shawnchivers/genthang/README.md

```
 ██████╗ ███████╗███╗   ██╗████████╗██╗  ██╗ █████╗ ███╗   ██╗ ██████╗ 
██╔════╝ ██╔════╝████╗  ██║╚══██╔══╝██║  ██║██╔══██╗████╗  ██║██╔════╝ 
██║  ███╗█████╗  ██╔██╗ ██║   ██║   ███████║███████║██╔██╗ ██║██║  ███╗
██║   ██║██╔══╝  ██║╚██╗██║   ██║   ██╔══██║██╔══██║██║╚██╗██║██║   ██║
╚██████╔╝███████╗██║ ╚████║   ██║   ██║  ██║██║  ██║██║ ╚████║╚██████╔╝
 ╚═════╝ ╚══════╝╚═╝  ╚═══╝   ╚═╝   ╚═╝  ╚═╝╚═╝  ╚═╝╚═╝  ╚═══╝ ╚═════╝ 
▀▀▀▀▀▀▀▀▀▀▀▀▀▀▀▀▀▀▀▀▀▀▀▀▀▀▀▀▀▀▀▀▀▀▀▀▀▀▀▀▀▀▀▀▀▀▀▀▀▀▀▀▀▀▀▀▀▀▀▀▀▀▀▀▀▀▀▀▀▀▀▀▀
      M E G A   D R I V E  /  G E N E S I S   ·   T A N G   N A N O   2 0 K
```

# Gen Thang

**Gen Thang is a DIY Sega Genesis / Mega Drive console project for the
[Sipeed Tang Nano 20K](https://wiki.sipeed.com/hardware/en/tang/Tang-Nano-20K/Nano-20K.html).**
A typical emulator recreates a console in software. Gen Thang does it in
hardware instead, using an FPGA chip configured to work like the original console.

Copy your own game ROMs to a microSD card (also called a TF card), choose a game
from the on-screen menu, and play. The standard build sends video and audio over
720p HDMI. You need a computer to program the board initially, but not to play.
Games are not included.

You can build it as a **TV console with Genesis controllers** or a **handheld
with built-in buttons and a small screen**. This repository contains the FPGA
design, menu firmware, build tools and optional PCB and printable-case designs.
You can use a [prebuilt release image](#choose-a-release-image) without compiling
the source yourself.

<p align="center">
  <a href="hardware/modern-3btn-handheld/index.html">
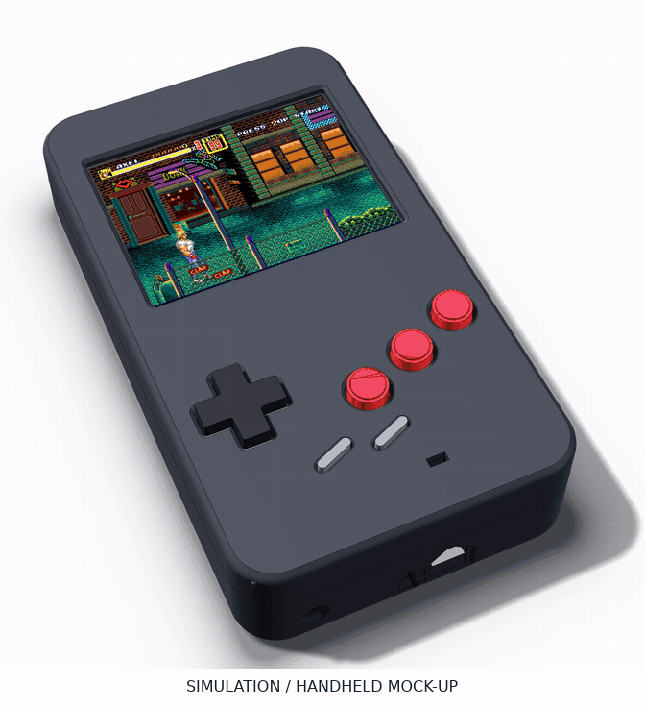
[picture p1: docs/images/modern-3btn-demo.gif]
Light-background mock-up of Streets of Rage 2 on the Gen Thang Modern three-button handheld
    
  </a>
</p>
<p align="center"><sub>Three-button handheld mock-up: Streets of Rage 2 frames from
Gen Thang's Verilator simulation composited onto a 3D render.
This is not footage from a physical handheld.
<a href="hardware/modern-3btn-handheld/index.html">Explore the handheld build guide.</a></sub></p>

> **Alpha software.** Gen Thang is under active development and is published as an
> early alpha. Expect bugs, game-compatibility gaps, missing features and breaking
> changes between releases. The default dual-DB9 build and raw-button variant are
> built and timing-checked but have not yet been tested on the new canonical wiring. The
> legacy single-DB9 breadboard image was tested by the author with a wired Genesis
> pad on its now-deprecated wiring, but only that one setup. Save
> states are experimental. Core switching rewrites the board's SPI flash. There is
> no warranty; you build, wire and flash at your own risk, and wiring mistakes can
> damage the board or a controller. See [Disclaimer](#disclaimer).

## Contents

**First build?** Start with [What you need](#what-you-need), then choose an
[assembly guide](#assembly-guides) for your controller or handheld arrangement.
The detailed pin tables and developer sections are references; you do not need
to read them all to understand the project.

- **See what it does:** [Features](#features) · [Game gallery](#game-gallery-streets-of-rage-2-sonic-2-and-x-men)
- **Build the hardware:** [Assembly guides](#assembly-guides) · [PCB and printable case](#pcb-and-printable-case) · [DB9 + biomech build guide](hardware/dual-db9-opt-pcb/index.html)
- **Set up the board:** [What you need](#what-you-need) · [Choose a release image](#choose-a-release-image) · [Flash](#1-flash-the-board) · [Prepare the card](#2-prepare-the-tf-card) · [Connect controllers](#3-connect-a-controller)
- **Play and use the menu:** [Using Gen Thang](#using-gen-thang) · [Controls](#controls) · [Options](#options-menu) · [Display options](#display-options) · [Save states](#save-states) · [USB upload](#uploading-roms-over-usb-serial) · [Core switching](#switching-cores)
- **Develop and debug:** [Build from source](#build-from-source) · [Simulation and screenshots](#simulation-and-screenshots) · [Limitations and troubleshooting](#limitations-and-troubleshooting)
- **About the project:** [Credits and tooling](#credits-and-tooling) · [Disclaimer](#disclaimer) · [License](#license)

## Features

- Motorola 68000 (fx68k), Z80 (T80), VDP, YM2612 (JT12) and SN76489 (JT89)
  implementations from the MiSTer Genesis core, running at 54 MHz and locked to
  the 60 Hz HDMI frame.
- 720p HDMI with audio. The picture is scaled to a centred 4:3 window.
- ROM browser on the TF card (`.md`, `.bin`, `.gen`, up to 4 MB) with an options
  page for resume, reset, save/load state and display settings.
- Controller options: two Genesis 3/6-button pads on DB9 breakouts (default), or
  twelve directly wired buttons for handhelds on the same physical GPIO layout.
- One save-state slot per game, with "Resume saved game" after a power cycle.
- Scanline and composite-blend display options.
- Optional ROM and core-image upload over the board's USB serial port (only in
  `GT_SERIAL_UPLOAD=1` builds; the default build leaves it out to fit the FPGA).

Not supported: SVP (Virtua Racing), EEPROM cartridges, Game Genie, interleaved
`.smd` ROMs and battery-backed cartridge saves (cartridge SRAM lives in SDRAM and is
only preserved inside a save state). Timing is fixed at NTSC / 60 Hz, as inherited
from MDTang.

## Game gallery: Streets of Rage 2, Sonic 2 and X-Men

Gen Thang's Genesis core playing the intro and attract mode (the unattended
demo) of three games, from ROMs you supply. These native 320x224 frames were
captured from Gen Thang running in its Verilator reference testbench (ideal memory;
see [Simulation and screenshots](#simulation-and-screenshots)). They are Gen Thang
simulation output, not captures from another emulator or from the physical HDMI port.

### Streets of Rage 2

<table>
  <tr>
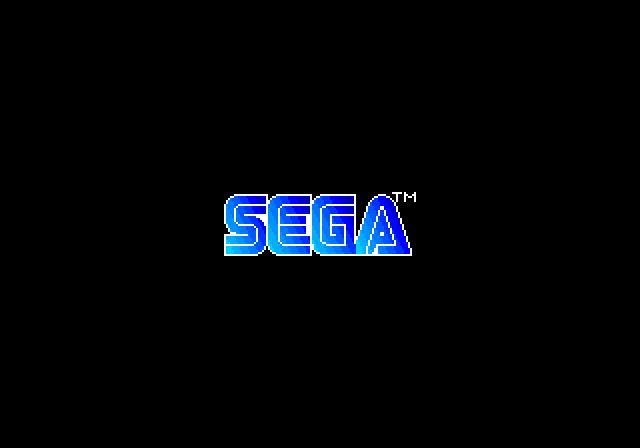
[picture p2: docs/images/sor2-sega.png]
    <td><br><sub>Boot logo</sub></td>
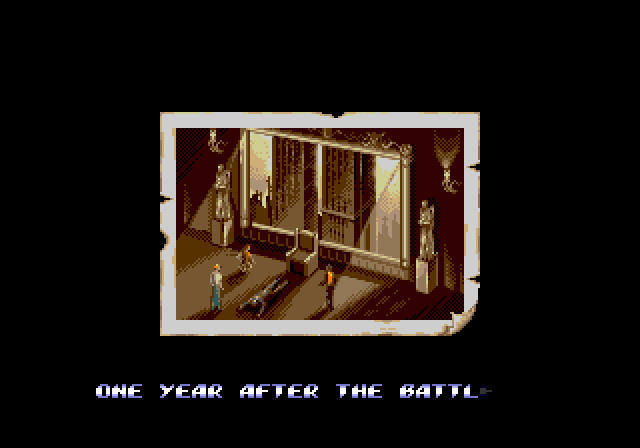
[picture p3: docs/images/sor2-story.png]
    <td><br><sub>Story intro</sub></td>
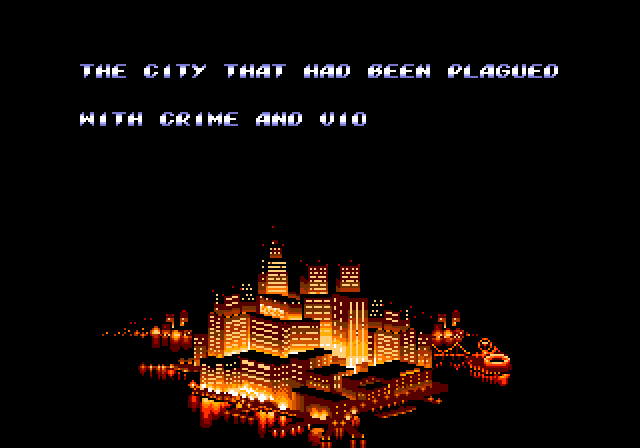
[picture p4: docs/images/sor2-city.png]
    <td><br><sub>The city</sub></td>
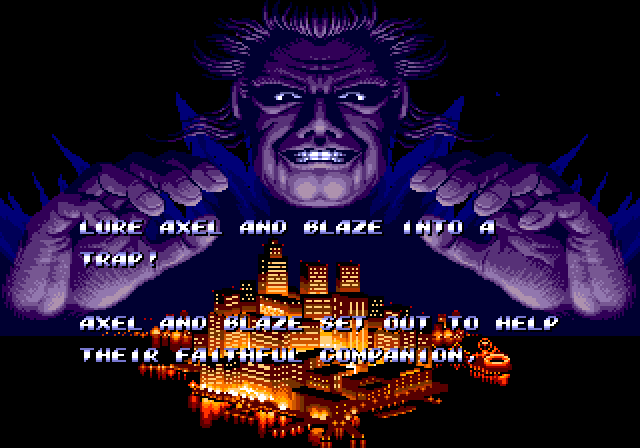
[picture p5: docs/images/sor2-boss.png]
    <td><br><sub>Mr. X and the city</sub></td>
  </tr>
  <tr>
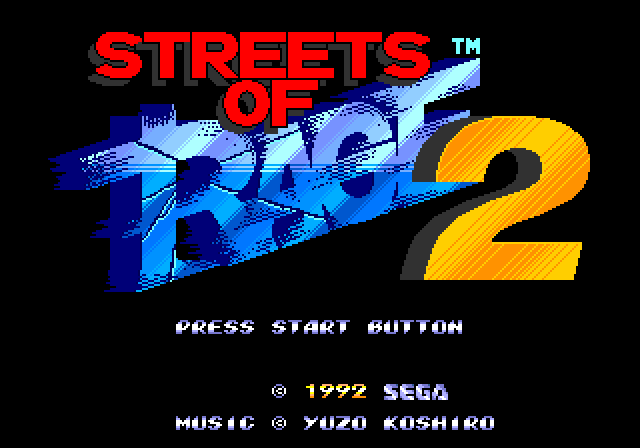
[picture p6: docs/images/sor2-title.png]
    <td><br><sub>Title screen</sub></td>
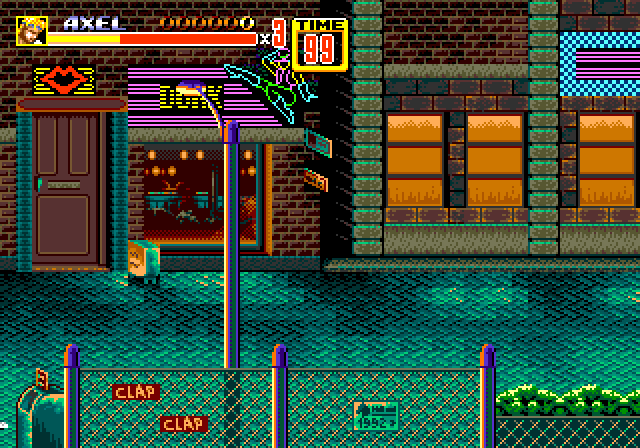
[picture p7: docs/images/sor2-attract-1.png]
    <td><br><sub>Attract mode: Stage 1</sub></td>
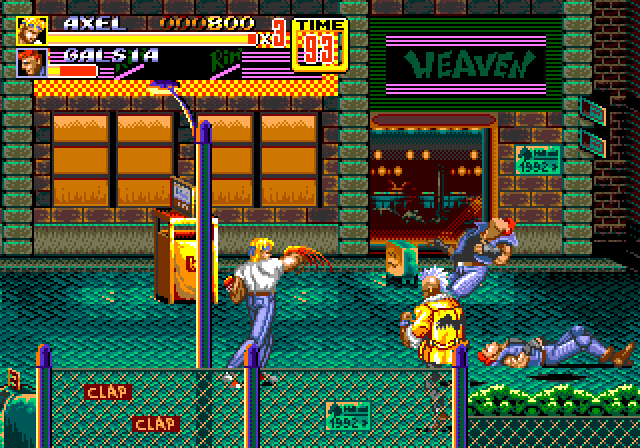
[picture p8: docs/images/sor2-attract-2.png]
    <td><br><sub>Attract mode: a fight</sub></td>
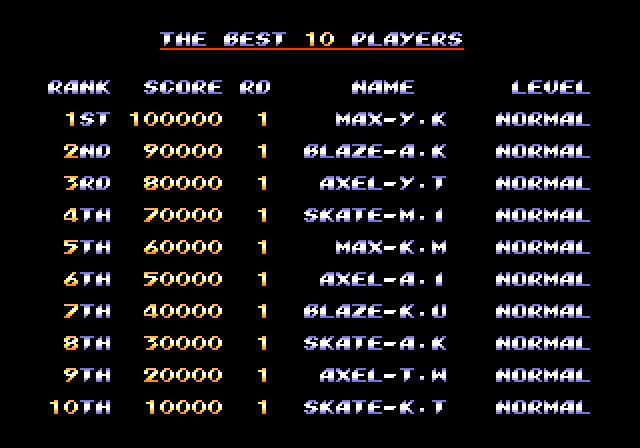
[picture p9: docs/images/sor2-scores.png]
    <td><br><sub>High scores</sub></td>
  </tr>
</table>

### Sonic The Hedgehog 2

<table>
  <tr>
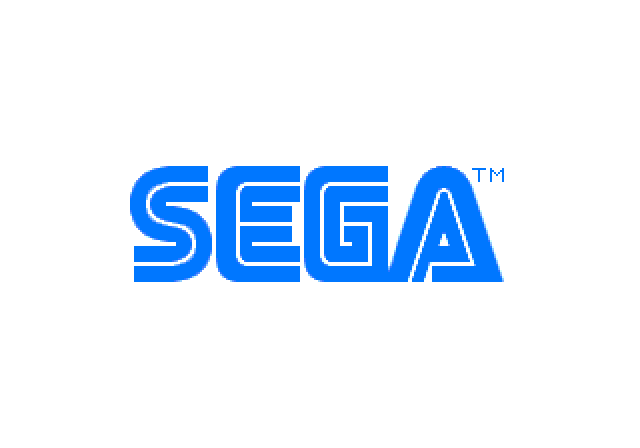
[picture p10: docs/images/sonic2-sega.png]
    <td><br><sub>Boot logo</sub></td>
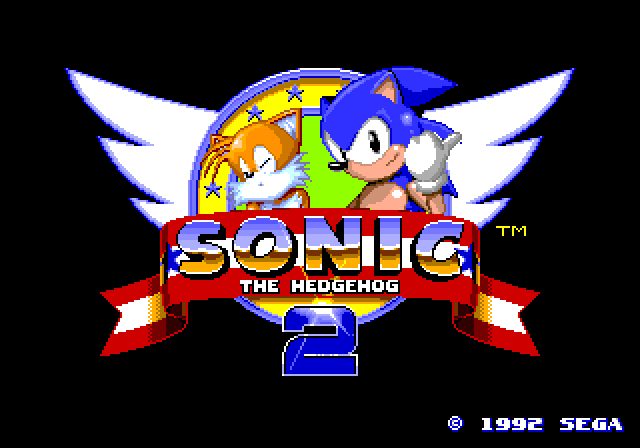
[picture p11: docs/images/sonic2-title.png]
    <td><br><sub>Title screen</sub></td>
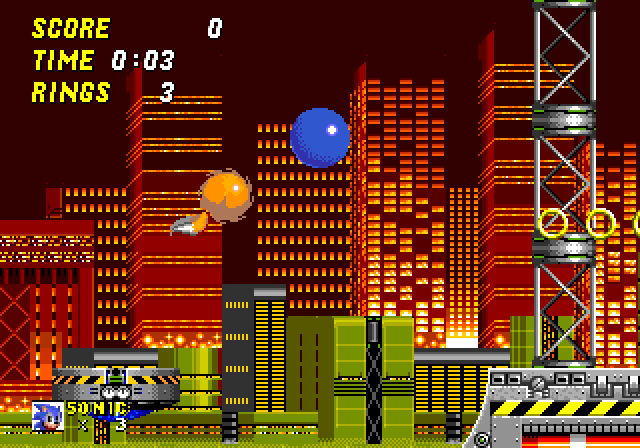
[picture p12: docs/images/sonic2-cpz-1.png]
    <td><br><sub>Chemical Plant Zone (demo)</sub></td>
  </tr>
  <tr>
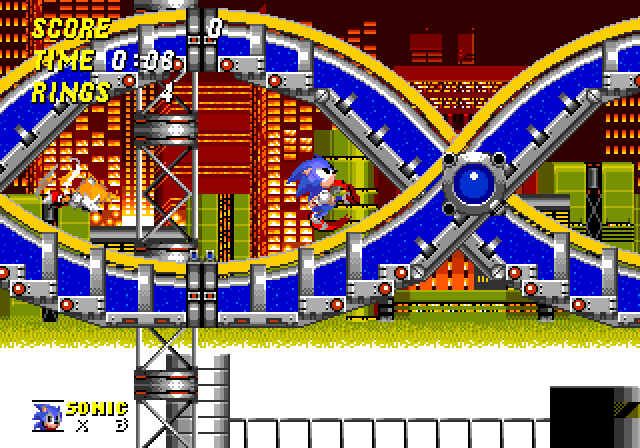
[picture p13: docs/images/sonic2-cpz-2.png]
    <td><br><sub>Chemical Plant Zone (demo)</sub></td>
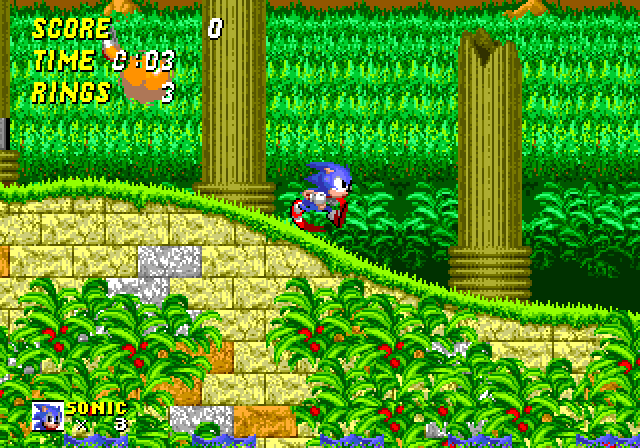
[picture p14: docs/images/sonic2-arz-1.png]
    <td><br><sub>Aquatic Ruin Zone (demo)</sub></td>
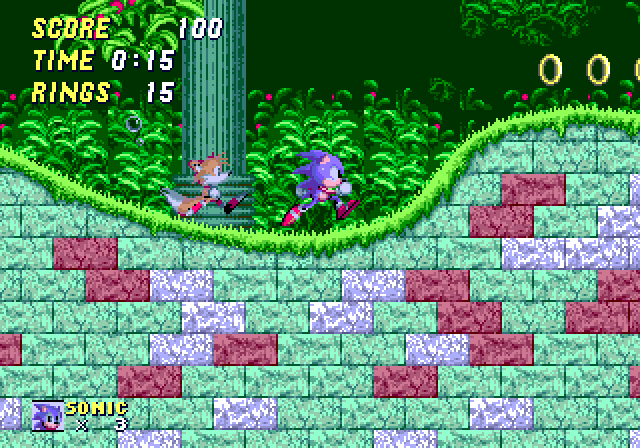
[picture p15: docs/images/sonic2-arz-2.png]
    <td><br><sub>Aquatic Ruin Zone (demo)</sub></td>
  </tr>
</table>

### X-Men

<table>
  <tr>
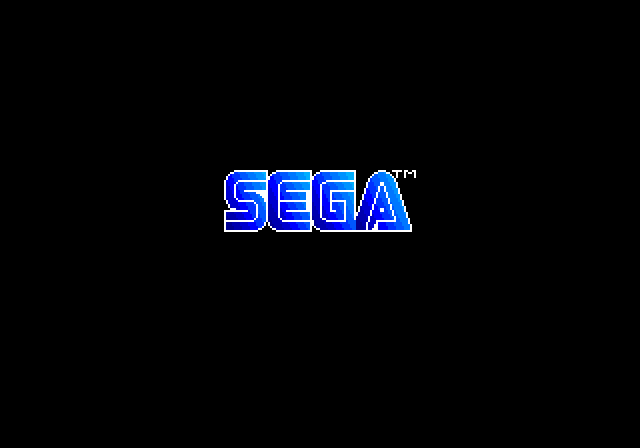
[picture p16: docs/images/xmen-sega.png]
    <td><br><sub>Boot logo</sub></td>
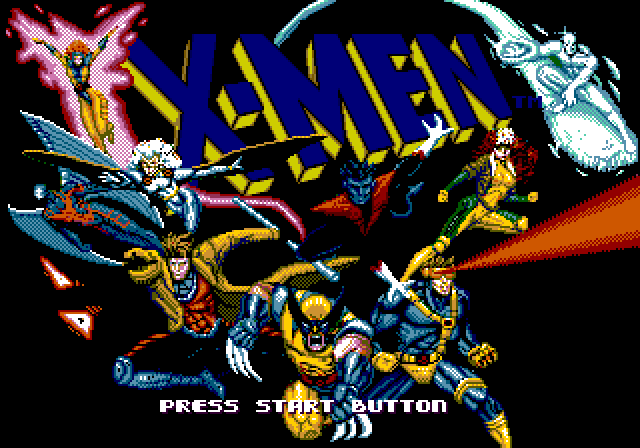
[picture p17: docs/images/xmen-title.png]
    <td><br><sub>Title screen</sub></td>
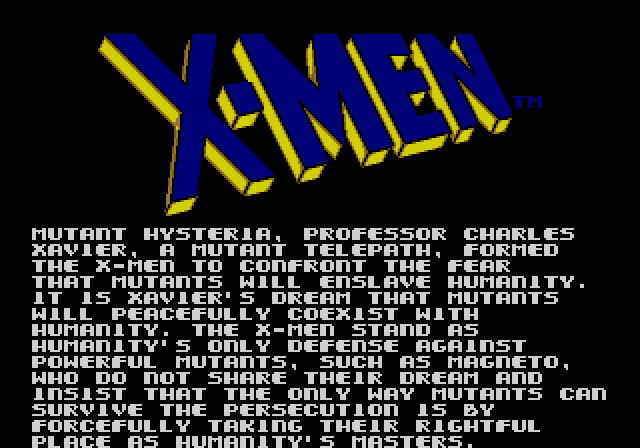
[picture p18: docs/images/xmen-story.png]
    <td><br><sub>Story text</sub></td>
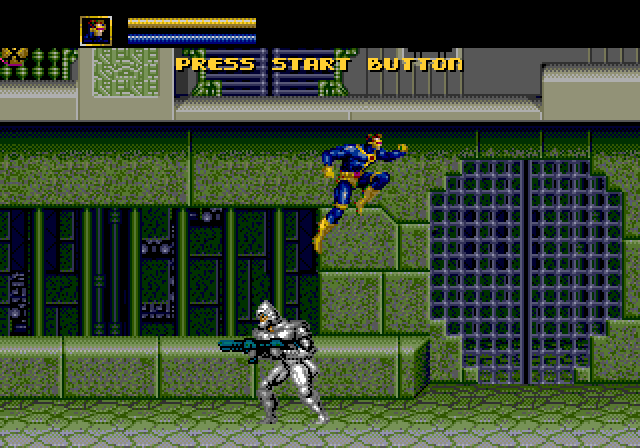
[picture p19: docs/images/xmen-play-1.png]
    <td><br><sub>Demo: Cyclops</sub></td>
  </tr>
  <tr>
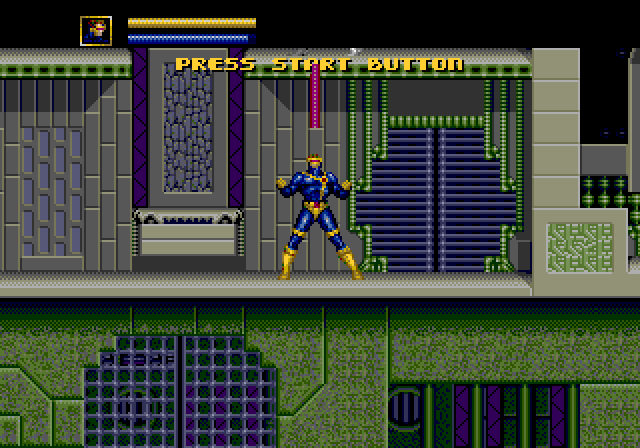
[picture p20: docs/images/xmen-play-2.png]
    <td><br><sub>Demo: Cyclops</sub></td>
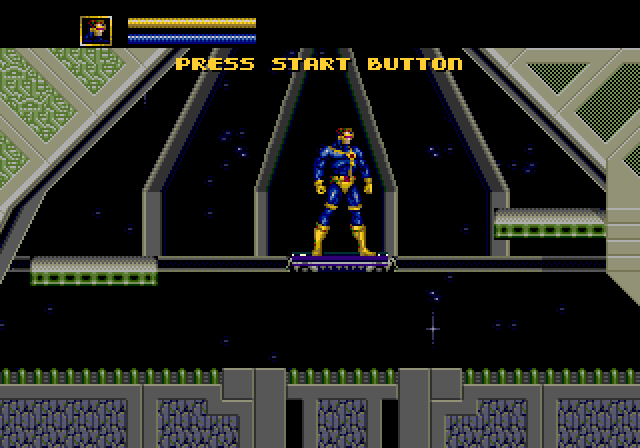
[picture p21: docs/images/xmen-play-3.png]
    <td><br><sub>Demo: Cyclops</sub></td>
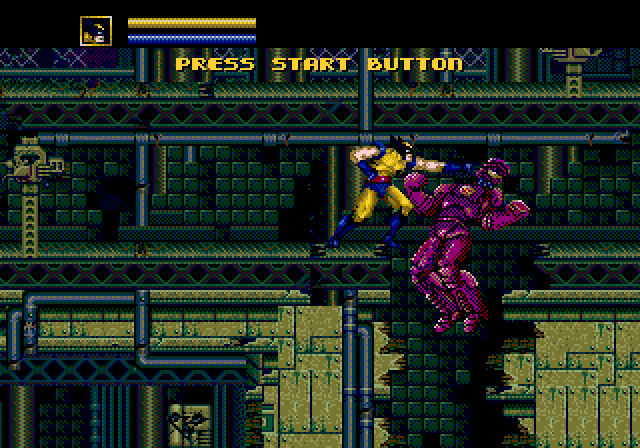
[picture p22: docs/images/xmen-play-4.png]
    <td><br><sub>Demo: Wolverine</sub></td>
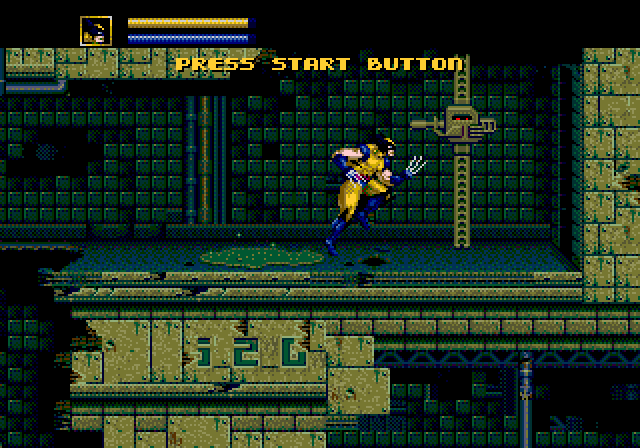
[picture p23: docs/images/xmen-play-5.png]
    <td><br><sub>Demo: Wolverine</sub></td>
  </tr>
</table>

<sub>Frames produced by Gen Thang running in its Verilator reference testbench.
That testbench uses ideal memory and BRAM VRAM rather than the full board's SDRAM
controller and menu firmware; these are simulation captures, not physical HDMI
captures.</sub>

## Assembly guides

Start here for step-by-step hardware builds, including parts, printing, assembly
and firmware setup. Choose the guide and firmware that match your hardware.

| Build | Assembly guide | Firmware |
|---|---|---|
| Two-player DB9 console with biomechanical case | [Illustrated build guide](https://shawnchivers.github.io/genthang/hardware/dual-db9-opt-pcb/) · [Offline page](hardware/dual-db9-opt-pcb/index.html) | `db9` |
| Standalone L3 dual-DB9 carrier with stereo line-out | [Colorful build guide and capacitor chooser](https://shawnchivers.github.io/genthang/hardware/dual-db9-lineout-pcb/) · [Offline page](hardware/dual-db9-lineout-pcb/index.html) | [Official v1.9.3 DB9 image](https://github.com/shawnchivers/genthang/releases/download/v1.9.3/genthang_nano20k_db9_flash.bin) |
| GenThang Modern 3-button handheld (beta) | [Illustrated build guide](https://shawnchivers.github.io/genthang/hardware/modern-3btn-handheld/) · [Offline page](hardware/modern-3btn-handheld/index.html) | `raw` |

**DB9 bench references:** [O1 soldering and pre-power checks](hardware/dual-db9-opt-pcb/ASSEMBLY.md)
· [Biomechanical case printing and assembly](hardware/dual-db9-biomech-case/README.md)
· [L3 line-out assembly](hardware/dual-db9-lineout-pcb/ASSEMBLY.md)
· [L3 capacitor selection](hardware/dual-db9-lineout-pcb/index.html#caps).

## PCB and printable case

The [hardware directory](hardware/README.md) includes the
[O1 dual-DB9 carrier PCB](hardware/dual-db9-opt-pcb/README.md) for two Genesis
controllers and an original
[Giger-inspired biomechanical case](hardware/dual-db9-biomech-case/README.md)
for the carrier and Tang Nano 20K.

**Build the console:** the [DB9 + biomech assembly guide](https://shawnchivers.github.io/genthang/hardware/dual-db9-opt-pcb/)
([local page](hardware/dual-db9-opt-pcb/index.html)) walks through parts sourcing,
printing, soldering, continuity tests, flashing, two-player bring-up and fitting
the carrier into the biomechanical case. It includes CAD illustrations, direct
PCB/STL downloads and a printable bench copy. This O1 build uses HDMI audio, not
the separate line-out carrier.

- **PCB:** KiCad sources, fabrication ZIPs, BOM, assembly instructions and
  continuity-test tables.
- **Case:** printable [base STL](hardware/dual-db9-biomech-case/stl/case_base.stl)
  and [lid STL](hardware/dual-db9-biomech-case/stl/case_lid.stl), an editable
  [STEP model](hardware/dual-db9-biomech-case/dual-db9-biomech-case.step), and
  parametric CadQuery source. The case has been printed.

**Handheld (beta):** the [GenThang Modern 3-button build guide](https://shawnchivers.github.io/genthang/hardware/modern-3btn-handheld/)
([source](hardware/modern-3btn-handheld/index.html)) walks through printing and assembling a battery-powered A·B·C handheld
with a 3.5" IPS screen, with 3D renders, an interactive viewer, wiring diagrams and the three
[STLs](hardware/modern-3btn-handheld/stl/). It uses the `raw` firmware.

**Standalone stereo line-out:** the [L3 carrier](hardware/dual-db9-lineout-pcb/README.md)
adds a 3.5 mm output for powered speakers, with GPIO31 left and GPIO17 right.
Its [colorful build guide](https://shawnchivers.github.io/genthang/hardware/dual-db9-lineout-pcb/)
includes a simple capacitor chooser, soldering and electrical
checks. The author confirms the GPIO17 audio move works and has submitted L3 to
OSH Park. Use the [L3 order ZIP](hardware/dual-db9-lineout-pcb/dual-db9-lineout-L3-OSHPARK.zip)
and the [official v1.9.3 DB9 image](https://github.com/shawnchivers/genthang/releases/download/v1.9.3/genthang_nano20k_db9_flash.bin).
L3 is a separate carrier; it does not fit the O1 biomechanical case above.

**OSH Park is the recommended PCB manufacturer for people within the USA.** Use the [OSH Park order ZIP](hardware/dual-db9-opt-pcb/dual-db9-opt-O1-OSHPARK.zip).

The carrier uses the standard `db9` firmware and the pinout in
[step 3](#3-connect-a-controller). It is unprotected **3.3 V-only**. This worked
on my personal configuration, but not all third-party controllers might work; only
3-button and 6-button SEGA OEM controllers were tested.

## What you need

- Tang Nano 20K and a USB-C cable.
- microSD / TF card (FAT32 or exFAT) and your own Mega Drive ROM files.
- HDMI display (with audio, if you want sound).
- A controller arrangement from [step 3](#3-connect-a-controller).
- Gowin Programmer (part of Gowin EDA) to write the flash. The Education edition
  1.9.11.03 is what was used for the releases.

ROM images and other copyrighted game data are **not** included.

## Choose a release image

Each release contains a bitstream for every controller arrangement. Every
`*_flash.bin` is a complete SPI-flash image (bitstream at `0x000000`, menu
firmware at `0x500000`); the `.fs` files are bitstream-only.

| Image | Controllers | Notes |
|---|---|---|
| `genthang_nano20k_db9_flash.bin` | Two Genesis pads on DB9 breakouts (default) | Canonical J6/J5 wiring, 3.3 V only; see [dual Genesis pads](#dual-genesis-pads-db9-build) |
| `genthang_nano20k_raw_flash.bin` | Twelve direct buttons | Handheld pinout, plus the Nano's speaker and a headphone jack; see [direct buttons](#direct-buttons-raw-build) |
| `genthang_nano20k_raw_3btn_flash.bin` | Single-player three-button handheld | Raw pinout; port 2 reads as unplugged and **Mode** alone opens the menu |
| `genthang_nano20k_db9_800x480_flash.bin`, `genthang_nano20k_raw_800x480_flash.bin` | Same pads, for an 800x480 TFT on a TFP401 board | Native 800x480 DVI, no HDMI audio; see [display options](#display-options) |

The wiring must match the image you flash. A mismatched image reads the wrong pins.

## Setup

### 1. Flash the board

Write the `*_flash.bin` for your controller arrangement at SPI-flash address
`0x000000`. Verify it against the release's `SHA256SUMS` first
(`sha256sum -c SHA256SUMS --ignore-missing`).

**Gowin Programmer GUI (Windows or Linux):** connect the board, open *Gowin
Programmer*, choose series **GW2AR** and device **GW2AR-18C**, then double-click the
operation. Set *Access Mode* to **External Flash Mode** and *Operation* to **exFlash
Erase, Program thru GAO-bridge**, pick the `*_flash.bin` file (switch the file
filter to `*.*`), set *Start Address* to `0x000000` and run it. The
[SNESTang installation guide](https://github.com/nand2mario/snestang/blob/main/doc/installation.md)
has screenshots of the same dialogs.

**Linux, command line:** the on-board BL616 debugger claims the FTDI interface;
release it first (repeat after every replug), then use the programmer. In our
testing openFPGALoader did not work with this board's debugger.

```sh
echo -n 1-2:1.0 | sudo tee /sys/bus/usb/drivers/ftdi_sio/unbind   # adjust 1-2 to your USB port
cd "$GOWIN_HOME/Programmer/bin"      # your Gowin EDA install directory
QT_QPA_PLATFORM=minimal ./programmer_cli --device GW2AR-18C --run 39 \
    --mcuFile /path/to/genthang_nano20k_db9_flash.bin --spiaddr 0x000000
```

A `.fs` file can be loaded into SRAM for a quick test, but it does not include the
menu firmware, so a flash image is required for normal use.

### 2. Prepare the TF card

Format the card with an MBR partition table and a FAT32 (or exFAT) filesystem, then
copy your `.md`, `.bin` or `.gen` ROMs onto it, in folders if you like. On Linux:

```sh
sudo parted /dev/sdX --script mklabel msdos mkpart primary fat32 1MiB 100%
sudo mkfs.vfat -F 32 -n GENTHANG /dev/sdX1
```

(Replace `/dev/sdX` with your card and double-check it first: this erases the card.)
Insert the card, connect HDMI and a controller, then power the board. To add ROMs
later, copy them to the card in a normal card reader. (Builds made with
`GT_SERIAL_UPLOAD=1` can also copy them over USB; see
[Uploading ROMs over USB serial](#uploading-roms-over-usb-serial).)

### 3. Connect a controller

Always **power the board off before wiring** controllers. The FPGA pins are 3.3 V
only and are not 5 V tolerant. In the tables below, the "FPGA pin" is the GPIO
number used in the constraints file; the "Nano contact" is the header position,
counted 1-20 from the USB-C end with the board viewed from above (USB at the top):
**J6** is the left header and **J5** the right header.

The original single-DB9 breadboard layout is documented separately in
[deprecated controller pinouts](docs/deprecated-pinouts.md). It is not included
in current releases.

#### Dual Genesis pads (`db9` build)

For a PCB instead of hand wiring, see the
[dual-DB9 carrier and matching printable case](#pcb-and-printable-case).

For two wired 3- or 6-button Genesis pads, use
`genthang_nano20k_db9_flash.bin`. Player 1 is entirely on J6 and player 2 entirely on J5.
Leave the Nano LCD connector and speaker header empty. Both ports use 3.3 V with
internal pull-ups; the DB9 pin 5 supply is 3.3 V.

| DB9 pin (male) | Signal | Player 1 FPGA pin (contact) | Player 2 FPGA pin (contact) |
|---|---|---|---|
| 1 | Up / D0 | 73 (J6.1) | 42 (J5.5) |
| 2 | Down / D1 | 74 (J6.2) | 41 (J5.6) |
| 3 | Left / D2 | 77 (J6.5) | 51 (J5.9) |
| 4 | Right / D3 | 27 (J6.8) | 48 (J5.10) |
| 5 | Pad supply | **3.3 V, not 5 V** (J6.19) | **3.3 V, not 5 V** (J5.16) |
| 6 | TL (B / A) | 28 (J6.9) | 49 (J5.12) |
| 7 | TH select (output) | 29 (J6.12) | 72 (J5.17) |
| 8 | Ground | GND (J6.20) | GND (J5.15) |
| 9 | TR (C / Start) | 30 (J6.13) | 71 (J5.18) |

##### P1 breadboard wiring

P1 can be built on a 30-row breadboard using only J6. Seat the Nano
component-side up with USB-C at the top, put J6.1 in hole `b5`, and connect a
passive **male DB9 screw-terminal or solder-cup breakout** with nine jumpers:

| DB9 pin | Function | Breakout jumper | Nano hole | Nano contact |
|---:|---|---|---|---|
| 1 | Up / D0 | terminal 1 to `a5` | `b5` | J6.1, GPIO73 |
| 2 | Down / D1 | terminal 2 to `a6` | `b6` | J6.2, GPIO74 |
| 3 | Left / D2 | terminal 3 to `a9` | `b9` | J6.5, GPIO77 |
| 4 | Right / D3 | terminal 4 to `a12` | `b12` | J6.8, GPIO27 |
| 5 | Controller supply | terminal 5 to `a23` | `b23` | J6.19, **3.3 V only** |
| 6 | TL / B, A | terminal 6 to `a13` | `b13` | J6.9, GPIO28 |
| 7 | TH select | terminal 7 to `a16` | `b16` | J6.12, GPIO29 |
| 8 | Ground | terminal 8 to `a24` | `b24` | J6.20, GND |
| 9 | TR / C, Start | terminal 9 to `a17` | `b17` | J6.13, GPIO30 |

Canonical P1 DB9 breadboard wiring

A bare DB9 does not fit a 2.54 mm breadboard. Check the numbered terminals and
your breadboard's internal row connections with a continuity meter before
connecting the Nano. DB9 pin 5 is **3.3 V only, never 5 V**; power off before
wiring or connecting a controller, and do not hot-plug this unprotected setup.
An optional 100 nF ceramic capacitor may be fitted directly across DB9 pins 5
and 8. Use the normal `genthang_nano20k_db9_flash.bin`; P2 may remain
disconnected.

Build it with:

```sh
GT_PAD=db9 ./build.sh
```

#### Direct buttons (`raw` build)

For handheld builds: twelve buttons, each switching an FPGA pin to GND (the
internal pull-ups are enabled), plus the Nano's speaker and a headphone jack (see
[speaker and headphone jack](#speaker-and-headphone-jack-raw-build)).

The pinout is laid out for a Nano mounted component side forward with USB-C at the
top. The left header (J6) faces the D-pad and the jack, and the right header (J5)
faces the face buttons. Groups sit on neighbouring pins, for neat solder runs or
multi-pin Dupont housings.

| Header pin | FPGA pin | Function | | Header pin | FPGA pin | Function |
|---|---|---|---|---|---|---|
| J6.8 | 27 | Up | | J5.3 | 76 | Start |
| J6.9 | 28 | Down | | J5.5 | 42 | X |
| J6.10 | 25 | Left | | J5.6 | 41 | A |
| J6.11 | 26 | Right | | J5.10 | 48 | Y |
| J6.12 | 29 | Headphone detect | | J5.12 | 49 | B |
| J6.13 | 30 | Jack R | | J5.13 | 86 | Mode |
| J6.14 | 31 | Jack L | | J5.17 | 72 | Z |
| J6.20 | GND | Button and jack ground | | J5.18 | 71 | C |
| | | | | J5.15 | GND | Button ground |

- Each face-button column shares neighbouring pins: X/A on J5.5–6, Y/B on
  J5.10/12 and Z/C on J5.17–18.
- The pins skipped on J5 belong to the TF card (80), the speaker amplifier (51,
  54–56) and the LED strip (79).
- Spare: 73, 74, 75 and 77 (J6.1, J6.2, J6.3, J6.5).
- In vector order, `btn_n[0..11]` (`B, A, Mode, Start, Up, Down, Left, Right, C, Y,
  X, Z`) uses pins `49, 41, 86, 76, 27, 28, 25, 26, 71, 48, 42, 72`.
- Releases up to 1.6.2 used the DB9 data pins for the raw build instead
  (`73, 74, 77, 27, 28, 30, 42, 41, 51, 48, 49, 71`). Rewire older raw builds when
  updating.

## Using Gen Thang

At power-on the menu lists the card's folders and ROMs sorted by name. If the card
cannot be read the status line says why (no reply, not initialised, not FAT32 /
exFAT). Picking a ROM streams it into SDRAM (about 7 s for 2 MB) and starts the game.

<p align="center">
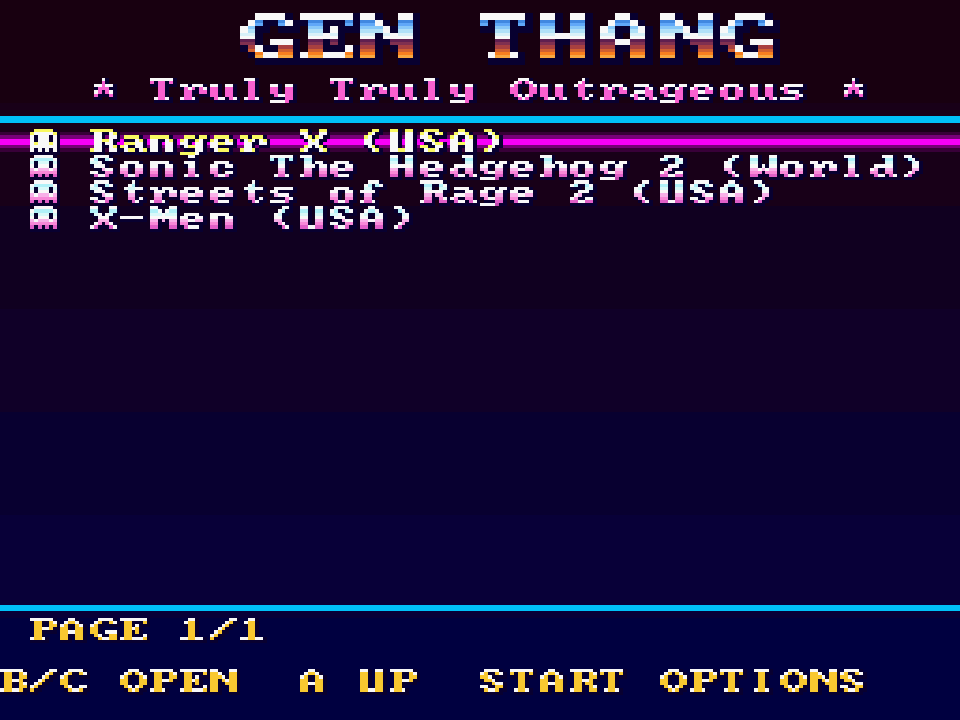
[picture p24: docs/images/menu-games.png]
Gen Thang game menu
  
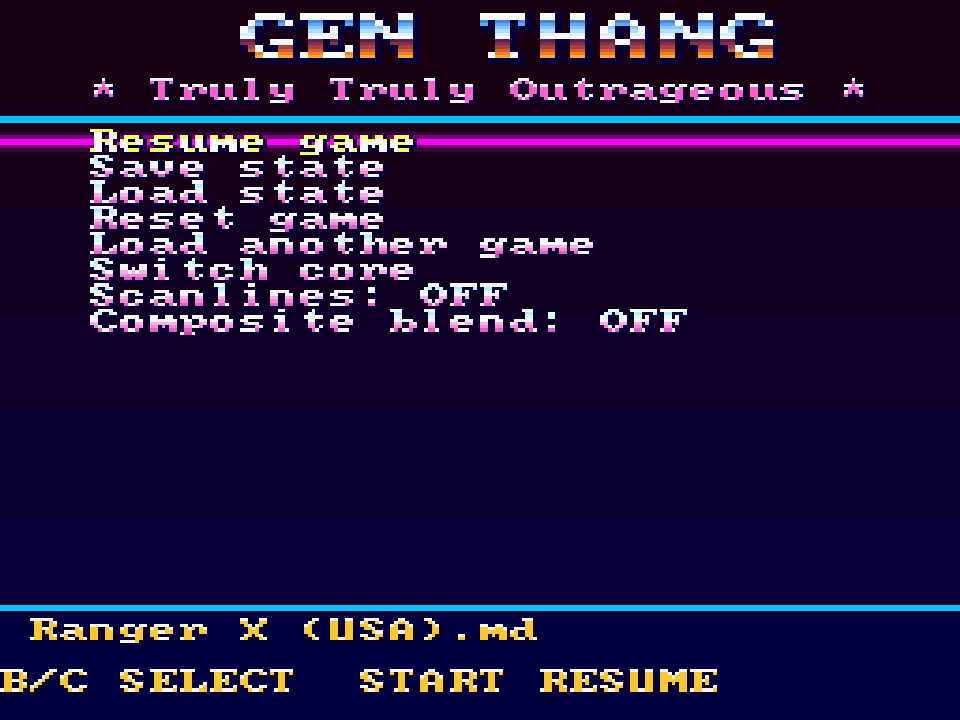
[picture p25: docs/images/menu-options.png]
Gen Thang options menu during a game
  
</p>
<p align="center"><sub>Menu overlay rendered by the Verilator testbench (see
<a href="#simulation-and-screenshots">Simulation and screenshots</a>).</sub></p>

### Controls

Everything in the menus needs only the D-pad, A/B/C and Start, so a 3-button pad
is enough. Player 1 drives the menu; player 2 only plays.

| Genesis control | Games page | Options page | In game |
|---|---|---|---|
| D-pad | move; Left/Right = page | move; Left/Right = change value | D-pad |
| A | parent folder | back to games (no game loaded) | A |
| B / C | open folder / load ROM | select | B / C |
| X / Y / Z | - | - | X / Y / Z |
| Start | open Options | resume the game | Start |
| Start+A+B+C or Mode+Start | resume the game | resume the game | open the menu (the game pauses) |

### Options menu

The Options page opens first when you call up the menu during a game:

- **Resume game**, **Save state**, **Load state**, **Reset game**, **Load another game**
- **Scanlines**: off, 25 %, 50 %
- **Composite blend**: off, on
- **Video output**: HDMI, or DVI with audio on the line-out jack only (see [display options](#display-options))
- **Display**: TV (default), or 4:3 LCD
- **Brightness**: 100 % (default), 75 %, 50 %, 25 % (raw build only)

The running firmware version is shown below the **GEN THANG** title on every menu page.

Opening the menu pauses the game and mutes HDMI audio. **Reset game** pulses the
console reset input without clearing work RAM, like the physical Genesis reset
button (this is the reset X-Men's Mojo level expects). Display settings are saved
to `GENTHANG.CFG` on the card. Scanlines and composite blend never affect the menu
itself, nor does brightness; video output and display apply to the menu too.

### Display options

The menu draws at 256x224 and the game at 320x224 or 256x224, both scaled into the
same centred 960x720 (4:3) window inside the 1280x720 HDMI frame by default. Two
post-processing options are applied by the HDMI scaler:

- **Scanlines** dims the lower half of each Genesis line by 25 % or 50 %. It is
  skipped in interlaced modes.
- **Composite blend** averages each pixel with its left neighbour, which melts the
  dither patterns many games use for transparency and shading the way a composite
  cable does. Version 1.9.3 removes adaptive blending to make room for the YM2612
  ladder effect; a saved adaptive setting becomes normal blend ON. Custom builds
  can restore adaptive with `GT_NO_ADAPTIVE=0`, subject to FPGA fit and timing.

**Brightness** exists only in builds with `GT_PICTURE=1`, the default for the raw
(handheld) build; the DB9 build leaves it out because the FPGA has no logic to spare,
and its menu does not show it. It dims the game picture to 75 %, 50 % or 25 % using the
scanline dimmer: on scanline rows the scanline and brightness levels add, down to 25 %.
On handheld (`GT_PICTURE=1`) builds the menu is always drawn at a fixed 50 % so it is
not harsh on the LCD; Brightness does not change it. This is software dimming, not LCD backlight control:
it does not reduce backlight power or improve the panel's black level, and dark detail
can be lost. The setting is saved to `GENTHANG.CFG` and kept, unused, when the card
moves to a DB9 board. (1.9.0 also had a Color mode; it was removed in 1.9.1 because that
picture stage broke audio and game loading on the handheld.)

**Video output** chooses HDMI (default, with audio) or DVI. DVI sends the same
720p60 picture without HDMI data islands, so the display gets no audio; use the
[line-out jack](#line-out-jack-db9-and-raw-builds) for sound. Use it if a
display pulses or flickers on mid and dark tones: on an LG 50PN6500 plasma, any HDMI
data island made the picture pulse regardless of its contents, and DVI was stable.

**Display** chooses **TV** (default, the centred 4:3 window) or **4:3 LCD**.
Use LCD mode for a 640x480 panel/controller such as the PCB800850 that squeezes
the entire 1280x720 input onto its 4:3 panel. It expands the game and menu across
the full input width (the leftmost 3 pixels stay black), removing the built-in side bars so the controller's
downscaling restores the intended proportions. On a normal 16:9 TV this mode
looks stretched; switch back to TV there. HDMI timing stays at 720p60, and no
extra framebuffer is used. Changes take effect at a frame boundary and are
saved to `GENTHANG.CFG`; settings from older versions still load with TV mode.

**Bare TFT panels behind a DVI/HDMI decoder board** (such as the Adafruit TFP401
with an 800x480 40-pin TFT) have no scaler, so they cannot show 720p at all. Build
the `GT_VIDEO=800x480` variant (`genthang_nano20k_<pad>_800x480.fs`) for them. It
outputs native 800x480 at 59.9 Hz (CVT timing, 29.7 MHz pixel clock), always as DVI
because the TFP401 cannot receive audio, so use the line-out jack for sound. TV mode
shows a centred 640x480 4:3 window; 4:3 LCD mode fills the full 800 width.

<p align="center">
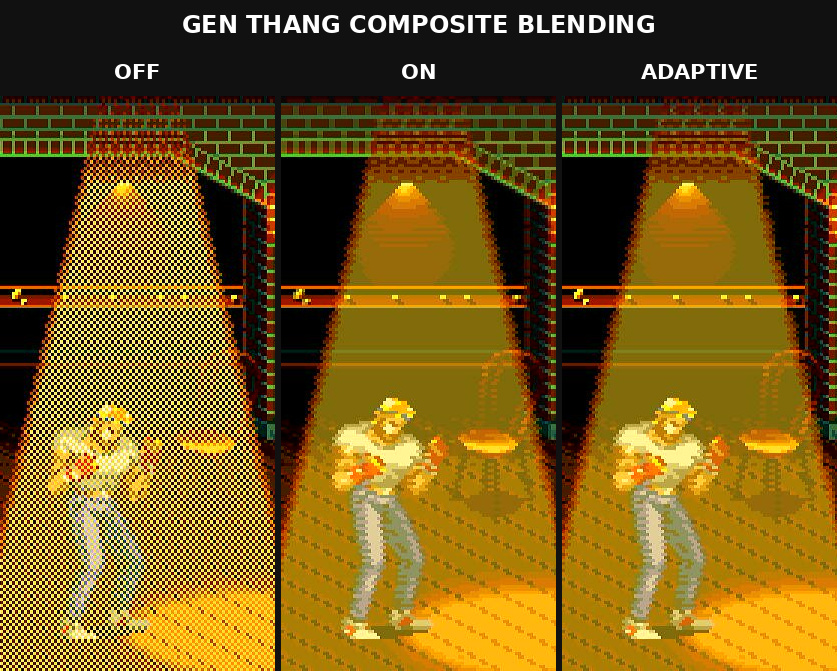
[picture p26: docs/images/composite-blending-options.jpg]
Gen Thang composite blending off, on and adaptive comparison
  
</p>

<p align="center"><sub>The same spotlight scene with composite blending off, on
and adaptive in earlier releases, cropped to show how each mode affects the light, character and floor
dither.</sub></p>

### Save states

Save states are **experimental**. There is one slot per game, stored next to the ROM
as `<rom name>.ss0` (about 200 KB). **Save state** and **Load state** from the
Options page return you to the game. The last ROM path is stored in `GENTHANG.CFG`,
so after a power cycle the start-up options offer **Resume saved game**, which
reloads that ROM and restores its state.

How it works: the menu parks the 68000 in a small routine
([firmware/m68k/savestate.s](firmware/m68k/savestate.s)) through a level-7
interrupt, freezes the Z80 at an instruction boundary, and saves work RAM, VRAM,
CRAM, VSRAM, VDP registers, Z80 RAM and registers, YM2612 registers, I/O and
cartridge SRAM. **Not saved:** PSG and YM2612 key-on state (notes resume at the next
key-on), the VDP FIFO and the raster position. A state only fits the exact ROM it was
made from.

### Uploading ROMs over USB serial

**Not in the default build or releases.** The serial UART is only built with
`GT_SERIAL_UPLOAD=1 ./build.sh`. Its fit is not certified with the 1.9.3 ladder
configuration; the default DB9 build already has very little logic headroom.
Without it the menu ignores the serial port; copy ROMs and core images to the card in
a card reader instead.

`genthang-upload` copies ROMs or core images to the inserted TF card through the Nano
20K's USB serial port. The card stays FAT32 / exFAT and still works in a normal
reader.

```sh
./upload/genthang-upload /dev/ttyUSB0 game.md
./upload/genthang-upload /dev/ttyUSB0 game.md --name "Game Name.md"
./upload/genthang-upload-gui.py     # GTK 3 frontend (needs the GTK 3 Python bindings)
```

The GUI detects the Sipeed debugger, accepts files by picker or drag and drop, and
shows progress and device errors. The transfer is CRC32-verified before it replaces
the destination, so an interrupted upload leaves the previous file intact. **Leave
the on-screen menu open during the transfer**: the PicoRV32 is stalled while a game
runs and cannot receive anything. The tool defaults to 460800 baud because the
debugger's USB-UART runs at four times the FPGA's setting; use `--baud 115200` with
corrected debugger firmware. On Linux your user needs access to the serial device
(usually the `dialout` group).

### Switching cores

Official 1.9.3 builds use `GT_NO_CORE_SWITCH=1`, which removes the runtime flash
interface and hides this menu entry to make room for ladder audio.
It also rejects serial core-image uploads; normal ROM loading and firmware bootstrap
from flash are unchanged. The FPGA reports this omission in core-ID bit 20 and the
adaptive omission in bit 19, so use the matching menu firmware from this worktree.

Custom builds with `GT_NO_CORE_SWITCH=0` can restore this feature, subject to FPGA
fit and timing. In those builds, *Switch core* lists complete SPI-flash images (`.bin`) in `/cores`, programs the one
you pick into the board's flash and asks you to power-cycle. Copy one to `/cores` on
the card (or, in a `GT_SERIAL_UPLOAD=1` build, upload it with
`./upload/genthang-upload /dev/ttyUSB0 other_flash.bin --core`). It must be up to 8 MB, a full flash
image, not a Gowin `.fs`; Gen Thang's own `*_flash.bin` files qualify. **Do not
remove power while the menu says `FLASHING`.** An interrupted write may need
recovery with Gowin Programmer over USB.

## Build from source

### Toolchain

- **Gowin EDA** Education 1.9.11.03 or a compatible release (`gw_sh`). Set
  `GOWIN_HOME` to its install directory (or `GW_SH` to the `gw_sh` binary, or put
  `gw_sh` on `PATH`); `build.sh` then sets the software rendering and FreeType
  environment the tools need on Linux. No install location is assumed. The IDE
  project uses SystemVerilog 2017.
- Only to change the menu: a RISC-V GCC (`riscv64-unknown-elf`, with picolibc) and
  m68k binutils. `firmware/firmware.bin` and `firmware/ss_stub.h` are committed and
  were checked to rebuild bit-for-bit with GCC 13.2 / binutils 2.42.
- Only for simulation: Verilator 5, `mtools` and `mkfs.vfat`.

```sh
git clone https://github.com/shawnchivers/genthang.git
cd genthang
./build.sh                        # impl/pnr/genthang_nano20k_db9.fs, dual DB9 build
GT_LADDER=0 ./build.sh            # custom clean-output audio build
GT_PAD=raw ./build.sh             # twelve direct buttons + Nano speaker (handheld pinout)
GT_VIDEO=800x480 ./build.sh       # native 800x480 DVI for a bare TFT on a TFP401 board
GT_PAD=raw GT_3BTN=1 ./build.sh   # 3-button handheld (*_3btn): no player 2, Mode alone opens the menu
GT_PICTURE=0 GT_PAD=raw ./build.sh  # raw build without the brightness option
./release.sh                      # all variants (db9, raw, raw_3btn, *_800x480) + flash images + tarball
```

`GT_PAD` (`db9`, `raw`) selects the supported pad ports in `src/mdtang_top.sv`, through
`src/pad_config.vh` (written by `build.tcl`) and `src/boards/nano20k_<pad>.cst`.
The raw build has its own handheld pinout; DB9 uses 12 data GPIOs and two TH outputs. The old `GT_PINOUT=breadboard` and `breadboard-rev1` values are deprecated
aliases for canonical DB9 and print a warning. The DualShock (`GT_PAD=ds`) build has
been removed.
`GT_3BTN=1` is for the single-player three-button handheld: player 1 reads as a 3-button
pad (Mode, X, Y and Z are not passed to games), port 2 reads as unplugged, and Mode alone
(held 20 ms) opens the menu instead of Mode+Start. The firmware reads it from bit 18 of
the core ID register. Output names get a `_3btn` suffix.
`GT_SERIAL_UPLOAD=1` adds the iosys UART for USB serial uploads. It is off by default
to leave logic headroom; its fit is not certified for 1.9.3. `GT_PICTURE`
(`0`/`1`) adds the brightness option to the HDMI scaler; it defaults to
`1` for `GT_PAD=raw` and `0` for DB9, which cannot fit it. The firmware reads the choice
from bit 16 of the core ID register, so one `firmware.bin` serves both. The default build also runs
the menu's PicoRV32 with a single-read-port register file, which halves its
distributed RAM at the cost of a slightly slower menu CPU.
The 1.9.3 defaults are `GT_LADDER=1`, `GT_NO_ADAPTIVE=1` and `GT_NO_CORE_SWITCH=1`.
JT12's YM2612 Model 1 DAC ladder distortion is enabled, while adaptive blending and
runtime core switching are omitted. Normal blend OFF/ON and scanlines remain.
Each flag accepts `0` or `1` for custom builds; changing the feature set requires a
fresh placement and timing check. `release.sh` explicitly fixes the official
feature set for every variant regardless of caller environment.
The earlier GPIO17/L3 ladder experiment with adaptive and core switching retained
did not fit the Nano 20K. The initial
build left 218 equivalent LUTs unplaced. Sharing a 10-bit ladder sum between the
stereo outputs reduced that to 100, but both timing-priority and balanced placement
still exhausted all 10,368 CLS. No ladder-enabled bitstream was generated.
The arithmetic optimization passes `tests/jt12_ladder_tb.sv`, which checks all
4,096 accumulator/panning/ladder combinations against the original output equations,
including clock-enable holds. Those full-featured attempts could not proceed to
hardware testing because placement failed.
The trimmed experiment removes only adaptive blending and core switching. It
keeps normal blend OFF/ON, scanlines, game loading, reset and save states. It also
sizes the flash-bootstrap counter to the firmware length; the flash test checks
both 4-byte and full 256 KiB loads, with and without runtime flash access.

**Historical 1.9.2 GPIO17/L3 ladder prerelease:** placement and routing pass, with
20,608/20,736 logic slots and 10,359/10,368 CLS used (128 logic slots and 9 CLS spare).
`clk_sys` reaches 63.534 MHz, `clk_z80` 44.117 MHz and `hclk` 76.879 MHz; all exceed
their targets, with zero negative setup/hold slack.
- [Combined flash image with matching menu firmware](builds/db9-gpio17-ladder-trimmed/genthang_nano20k_db9_gpio17_ladder_trimmed_flash.bin):
  program at SPI-flash address 0. GPIO31 left audio, GPIO17 right audio and both
  DB9 controller pinouts are unchanged.
- [SRAM bitstream](builds/db9-gpio17-ladder-trimmed/genthang_nano20k_db9_gpio17_ladder_trimmed.fs):
  use only after the matching menu firmware is installed in SPI flash. The older
  GPIO17 menu does not know that adaptive and core switching are disabled.
- [Checksums](builds/db9-gpio17-ladder-trimmed/SHA256SUMS) and
  [build configuration, source hashes and validation results](builds/db9-gpio17-ladder-trimmed/build-info.json).

This pre-release image was flashed, verified and tested on hardware; the user
confirmed working operation and audio closer to the original. Its menu version
remains 1.9.2; identify it by the `gpio17_ladder_trimmed` filenames.
Gowin runs share intermediate files
in `impl/`, so do not run two builds concurrently in one checkout.

Gowin writes `impl/pnr/genthang_nano20k.bin` (bitstream) and `.fs`. Combine the
bitstream with the menu firmware into a flash image yourself with:

```sh
python3 merge_flash.py impl/pnr/genthang_nano20k.bin firmware/firmware.bin genthang_nano20k_flash.bin
```

`release.sh` does this for each variant and refuses to package a build that misses
the `clk_sys`, `clk_z80` or `hclk` targets or leaves negative setup/hold slack. The
design nearly fills the FPGA (see [Resource use](#resource-use)), so even small RTL
changes can break timing. Rebuild the menu with:

```sh
cd firmware
make RISCV=/usr/bin/riscv64-unknown-elf EXTRA_CFLAGS="-isystem /usr/lib/picolibc/riscv64-unknown-elf/include"
```

The internal module and file names (`mdtang_top`, `md20k_core`, `sdram_md20k`) keep
the project's MDTang lineage and are intentionally not renamed.

### Resource use

The design nearly fills the Nano 20K's FPGA. Release builds use timing-priority
placement and timing-directed routing. Post-route timing for this release has zero
negative setup and hold slack:

| Variant | `clk_sys` Fmax (needs 54.0 MHz) | `clk_z80` Fmax (needs 27.0 MHz) | `hclk` Fmax (720p needs 74.25 MHz; 800x480 needs 29.7 MHz) |
|---|---|---|---|
| `db9` | 63.534 MHz | 44.117 MHz | 76.879 MHz |
| `raw` | 57.783 MHz | 50.044 MHz | 82.740 MHz |
| `raw_3btn` | 62.023 MHz | 47.732 MHz | 80.840 MHz |
| `db9_800x480` | 65.307 MHz | 46.219 MHz | 71.688 MHz |
| `raw_800x480` | 63.952 MHz | 45.457 MHz | 82.323 MHz |

Every release build is rejected if a clock misses its target or the timing report
contains negative setup or hold slack.

## Simulation and screenshots

The Gen Thang Verilator testbenches in [verilator/](verilator) run the synthesisable
core with the real menu firmware against models of the SDRAM, SPI flash and TF card
(`make dut`), and the same Gen Thang Genesis core in a faster reference configuration
with ideal memory and BRAM VRAM but no menu, SDRAM controller or firmware (`make ref`).
The full-board configuration is too slow to reach the attract modes (see below), so
the game frames in this README come from Gen Thang's reference testbench; the menu
images (`menu-*.png`) come from its full-board testbench.

```sh
cd verilator
make dut ROM=/path/to/game.md              # whole board core + firmware + FAT32 card image
make run-dut ARGS="-T 1700 -O 900"         # boot the menu and dump the overlay (run/dut/overlay_900.ppm)
make textdisp                              # the menu overlay alone -> run/textdisp/*.ppm
make genesis-pad gen-io                    # unit tests for the DB9 pad reader and the I/O block
make picture-modes picture-settings        # RGB pipeline and saved/menu picture settings (no ROM needed)
make ref ROM=/path/to/game.md && make run-ref ARGS="-n 300 -d 100,200"   # golden model
```

`make` needs `mcopy` and `mkfs.vfat`; set `MTOOLS=/dir/containing/mtools/` if `mcopy`
is not on `PATH`. `-t ms:len:mask` presses buttons at an absolute time and
`-p frame:len:mask` relative to the game start (mask bits 0-7: Right, Left, Down,
Up, A, B, C, Start; 8 Mode, 9 X, 10 Z, 11 Y; Mode+Start is `0x180`). `-d` dumps
frames as PPM, `-O` dumps the menu overlay. The simulation is slow (the whole board
runs at roughly 0.4 simulated seconds per minute), so a full ROM load takes tens of
minutes.

[verilator/hdmi_preview.py](verilator/hdmi_preview.py) converts a dumped frame or
overlay into a PNG as the HDMI scaler would show it (`--overlay`, `--scanlines`,
`--blend`, `--crop`). The images in [docs/images](docs/images) were produced this
way. Unit tests for the build selection and pin contract run with
`python3 -m unittest discover -s tests` (needs `tclsh`).

Results for this release: the full-board testbench booted the real menu firmware from
the SPI-flash model, initialised and mounted a FAT32 card model, loaded a 2.2 MB ROM
(560,691 ROM words written to SDRAM and checked against the file, none wrong; 4,422
card blocks read), started the game after 7.3 simulated seconds, and opened the menu
with Mode+Start during play, with zero SDRAM, flash and TF-card protocol errors.
The DB9 pad reader and the two-port I/O block unit tests pass, as do the four build
and pin-selection tests. The testbench does not exercise the HDMI frame lock, and
frame-by-frame equivalence of the whole board against the reference configuration
was not re-run for this release. The gallery therefore shows Gen Thang's Verilator
core output, not captures from the physical board's HDMI port. Hardware performance investigation notes are in
[docs/slowdown-test.md](docs/slowdown-test.md).

## Limitations and troubleshooting

- Alpha quality: compatibility is not exhaustive and timing is tight. Please report
  games that fail along with the image variant and ROM name.
- ROMs must be raw (not interleaved `.smd`), no larger than 4 MB, and use `.md`,
  `.bin` or `.gen`. No battery-backed saves are written; use save states.
- Save states are experimental and tied to the exact ROM; PSG phase, YM2612 key-on
  state, VDP FIFO contents and raster position are not restored.
- If the menu says the card is not FAT32/exFAT, reformat it with an MBR partition
  table and a FAT32 filesystem.
- USB upload is not in the default build (only with `GT_SERIAL_UPLOAD=1`, which has
  little logic headroom); where present it needs the on-screen menu open and serial
  access on your computer.
- Core switching rewrites the SPI flash; never interrupt power while it says
  `FLASHING`.
- Some Genesis pads need 5 V power and a 3.3 V level shifter, which the breadboard
  wiring does not provide; the FPGA inputs are not 5 V tolerant.
- No picture or menu: check the HDMI cable and display (the output is 720p60), that
  the flash image matches your hardware, and that the TF card is fully inserted.
- Picture pulses or flickers on a plasma TV (black and full white stay steady): set
  **Video output** to DVI in the options menu. The TV then gets no audio; use the
  line-out jack below for sound.

### Line-out jack (DB9 and raw builds)

A stereo 3.5 mm line-out is available on two otherwise unused header pins, in both HDMI
and DVI modes: left on FPGA pin 31 (J6 contact 14), right on pin 17 (J6 contact 15), ground on
J6 row 20 or J5 row 15. The raw build uses its own jack pins; see
[below](#speaker-and-headphone-jack-raw-build). The pins carry 1-bit (sigma-delta) audio, so each needs a small
filter:

```
pin ──1 kΩ──┬──10 µF (+ toward the resistor)──► jack tip (L) / ring (R)
          10 nF
GND ────────┴─────────────────────────────────► jack sleeve
```

The output is roughly 1 V peak to peak, for powered speakers, a soundbar or an amplifier;
it is not meant to drive headphones directly.

**Not hot-pluggable without the filter.** Wired straight to the pins (no resistor or
capacitors) the line-out works for a quick test, but plugging or unplugging the jack or
the speaker while the board is powered gave trouble. Power the board off first, or fit
the 1 kΩ / 10 nF / 10 µF filter, which isolates the pins. GPIO17 is unused by the controller
ports, but drives the Nano's on-board LED2 through a 510 Ω resistor; the LED can glow
with the audio. Unlike the old GPIO56 output, it is not a configuration pin or an
on-board amplifier input. Keep the Nano's speaker and LCD connectors empty.

**Carrier compatibility:** these DB9 builds use the
[L3 line-out carrier](https://github.com/shawnchivers/genthang-hw/tree/main/dual-db9-lineout-pcb)
pinout. Released images through 1.9.2 and L1/L2 carriers use GPIO56 (J5 contact 7)
for right audio. On an older carrier, use an isolated jumper from **Tang J6.15
(GPIO17) to PCB J5.7** and do not also connect Tang GPIO56 to that filter. The L3
PCB wires GPIO17 directly, with no jumper. Both controller pinouts and the raw
handheld audio pins are unchanged. This pin change is not a guarantee of noise-free audio.

**Official v1.9.3 L3 builds (DB9, 720p):**
- [Combined flash image](https://github.com/shawnchivers/genthang/releases/download/v1.9.3/genthang_nano20k_db9_flash.bin):
  program at address `0x000000` for persistent boot; includes the matching menu
  firmware at `0x500000`.
- [SRAM bitstream](https://github.com/shawnchivers/genthang/releases/download/v1.9.3/genthang_nano20k_db9.fs):
  temporary FPGA programming only; requires matching 1.9.3 menu firmware already
  installed in SPI flash.
- [SHA256 checksums](https://github.com/shawnchivers/genthang/releases/download/v1.9.3/SHA256SUMS) and
  [build provenance and timing results](https://github.com/shawnchivers/genthang/releases/download/v1.9.3/BUILD-INFO.json).

These official images include YM2612 Model 1 ladder audio and replace the
provisional GPIO17 packages. Use the combined flash image for a complete 1.9.3
installation; do not use the older standard 1.9.2 DB9 images with the L3 carrier.

On the P1 breadboard (above) the jack wires go to free holes: tip to **a18**, ring to
**a19**, sleeve to **j19**.

Line-out jack on the P1 DB9 breadboard

### Speaker and headphone jack (raw build)

The raw build plays through the Nano's **on-board MAX98357A speaker amplifier** and mutes it
when headphones are plugged into a switching 3.5 mm jack. Solder a 4–8 Ω speaker (1 W or
more) to the two speaker pads between the FPGA and header pins 56/54.

| Signal | Pin | Notes |
|---|---|---|
| I2S BCLK / LRCK / DIN | 56 / 55 / 54 | Board traces to the amplifier: 48 kHz, mono (L+R)/2 in both slots |
| Amplifier enable | 51 | High = speaker on |
| Line-out L / R | 31 (J6.14) / 30 (J6.13) | 1-bit audio, filter below |
| Headphone detect | 29 (J6.12) | Jack's RING-NORMAL contact; internal pull-up, high = plug in |

```
pin 31 ─330Ω─┬─100µF(+ to resistor)─┬─► jack TIP
            33nF                   4.7k
pin 30 ─330Ω─┬─100µF(+ to resistor)─┼─► jack RING ◄── RING-NORMAL ──► pin 29
            33nF                   4.7k
GND ────────┴──────────────────────┴─► jack SLEEVE        (TIP-NORMAL: not connected)
```

- With nothing plugged in, the RING-NORMAL contact touches the ring, so pin 29 reads low
  through the 4.7 k and the speaker plays. A plug opens the contact; after about 11 ms the
  speaker amplifier shuts down and the jack plays.
- While nothing is plugged in, both line-outs carry the DAC's silence pattern (a 27 MHz
  square wave that the filter removes). The detect pin sees a clean level, and the
  capacitors stay charged, so plugging in doesn't pop.
- These values suit 32 Ω earbuds (moderate volume) as well as line inputs. The 1 kΩ / 10 µF
  line-out filter above is too weak for headphones.
- Speaker volume is −12 dB of full scale (`ATTEN` in `src/i2s_tx.v`, 6 dB per step). This
  protects small speakers and battery packs.
- The jack's pin numbering varies between makers. With no plug in, find RING ↔ RING-NORMAL
  with a continuity meter.

## Credits and tooling

Gen Thang is an adaptation of [MDTang](https://github.com/nand2mario/mdtang) by
nand2mario, bringing its spirit to the much smaller Tang Nano 20K. It is **based
on** the work of many others. Its Genesis implementation is derived from
[Genesis_MiSTer](https://github.com/MiSTer-devel/Genesis_MiSTer) and
[MegaDrive_MiSTer](https://github.com/MiSTer-devel/MegaDrive_MiSTer) by way of
MDTang, and its menu and I/O subsystem, HDMI framebuffer and several Tang Nano
hardware blocks are derived from [SNESTang](https://github.com/nand2mario/snestang).
These projects' authors did not write Gen Thang's changes and do not endorse it; the
files Gen Thang modified say so in their headers.

Major reusable components: [fx68k](https://github.com/ijor/fx68k) (Jorge Cwik),
[T80](https://opencores.org/projects/t80), [JT12](https://github.com/jotego/jt12) and
[JT89](https://github.com/jotego/jt89) (Jose Tejada),
[PicoRV32](https://github.com/YosysHQ/picorv32) (Claire Xenia Wolf),
[hdl-util/hdmi](https://github.com/hdl-util/hdmi) (Sameer Puri),
[FatFs](http://elm-chan.org/fsw/ff/) (ChaN),
[FemtoRV](https://github.com/BrunoLevy/learn-fpga) (Bruno Levy) and
[nandland spi-master](https://github.com/nandland/spi-master) (Russell Merrick).
The complete list, with licences, is in [THIRD_PARTY.md](THIRD_PARTY.md).

Tools used: Gowin EDA 1.9.11.03, Verilator, GNU RISC-V and m68k toolchains, GNU Make,
Python 3 and Bash, mtools, and GitHub Copilot (Claude models) for development and
documentation assistance. Sipeed's Tang Nano 20K schematic was used to verify the
controller pin assignments.

Release history is in [CHANGELOG.md](CHANGELOG.md).

## Disclaimer

Gen Thang is an independent, unofficial hobby project. It is not affiliated with or
endorsed by Sega, Sipeed, Gowin, MiSTer-devel or any other party named here, and all
trademarks belong to their owners. It is provided "as is", without warranty of any
kind (see the GPL). You are responsible for using only ROMs you are legally entitled
to use; no game data is distributed. The wiring information is provided in good
faith but may contain errors: verify it against your own hardware and the Sipeed
schematic before powering anything, and use at your own risk. HDMI is a trademark of
HDMI Licensing Administrator, Inc.; the HDMI output is intended for personal and
hobby use, and a commercial product would need its own HDMI adopter licence.

## License

Gen Thang is distributed under the [GNU General Public License v3](LICENSE).
Bundled third-party components keep their own licences and notices; see
[THIRD_PARTY.md](THIRD_PARTY.md).
