shawnchivers/genthang/hardware/dual-db9-lineout-pcb/index.html

Skip to the capacitor chooser

L3 build guide · two-player Genesis · stereo line-out

# Build your L3. Choose your sound.

Build the GenThang L3 carrier: two Genesis controller ports, a removable Tang Nano 20K and a 3.5 mm stereo output for powered speakers. Everything you solder is through-hole.

Help me choose capacitors Order the L3 PCB

The author confirms the GPIO17 audio move works and has submitted L3 to OSH Park. Test scope and limits.

L3 carrier top view showing the rear stereo audio circuit and front DB9 controller ports

L3 carrier: stereo audio at the rear, two DB9 controller ports at the front.

100 x 70 mm
2-layer, 1.6 mm PCB

13 soldered parts
All through-hole

Left 31 / Right 17
FPGA GPIO numbers

2 controller ports
Canonical DB9 pinouts

Power off before building or changing connections. Controller pin 5 is 3.3 V only, never 5 V. There are no port fuses, level shifters or ESD protection. Leave the Nano's LCD and speaker connectors empty. Line-out is for powered speakers or an amplifier, not direct headphones.

Step 1

## Gather the parts for one L3 board

Shopping list
Qty | Part | What matters
1 | L3 carrier PCB | OSH Park ZIP; do not order an old L1/L2 archive.
1 | Tang Nano 20K | Two downward 1x20 male headers; Harwin M20-9992046 is the documented socket mate.
2 | Harwin M20-7822046 female sockets | J5/J6: 1x20, 2.54 mm pitch, 8.5 mm tall. Source (https://www.digikey.com/en/products/detail/harwin-inc/M20-7822046/1905)
2 | Kycon K22X-E9P-N male DB9 | J1/J2: right angle, boardlocks, recessed #4-40 inserts. Not NJ. Source (https://www.digikey.com/en/products/detail/kycon-inc/K22X-E9P-N/2596805)
1 | CUI / Same Sky SJ1-3523N | J3: exact 3-pin stereo jack. Not the 5-pin PJ-307. Drawing
2 | 1 kOhm resistors | R1/R2: 1/4 W axial, 7.62 mm lead spacing.
2 | 47 kOhm resistors | R3/R4: 1/4 W axial, 7.62 mm lead spacing.
2 | Nonpolarized filter caps | C1/C2: choose 10, 47 or 56 nF below; 50 V, 5.0 mm lead spacing.
2 | 10 uF radial electrolytics | C3/C4: 25 V, 5 mm body diameter, 2.0 mm lead spacing. Polarized.
1 each | TF card, USB-C cable, HDMI cable/display | FAT32/exFAT card with your own ROMs; USB-C supplies the Nano.
1-2 | Wired Genesis controllers | Canonical 3.3 V-only DB9 wiring; keep power off when connecting pads.
1 | Powered speakers / amplifier + stereo TRS cable | 3.5 mm tip = left, ring = right, sleeve = ground. Start with volume at zero.

Tools: soldering iron and solder, flush cutters, multimeter, a small screwdriver if mounting the board, and a computer with Gowin Programmer.

PCB order: standard 2-layer, 1 oz copper, 1.6 mm board. In the OSH Park preview, check the L3 marking, 100 x 70 mm outline, rear jack notch and three 0.60 x 1.40 mm plated jack slots. No stencil or SMT assembly is needed.

Step 2 · The easy capacitor chooser

## Pick your sound. Buy two matching filter caps.

C1 and C2 set the analog low-pass response. Choose one card below and buy two capacitors of that value: one for the left channel, one for the right. If unsure, start with the green stock option.

Stock · start here

### More treble detail

10 nF

Marking: 103
Also written: 0.01 uF

Buy 2. Nominal cutoff: 15.9 kHz. Matches the stock BOM and schematic.

Optional · darker

### Model 1 VA0-VA2-style

47 nF

Marking: 473
Also written: 0.047 uF

Buy 2. Nominal cutoff: 3.39 kHz. Less high-frequency content.

Optional · darker still

### Model 1 VA3-VA6-style

56 nF

Marking: 563
Also written: 0.056 uF

Buy 2. Nominal cutoff: 2.84 kHz. A good starting point for the darker Model 1-style option.

### How to shop without getting lost

1. Search for your chosen value, followed by “50 V through-hole film capacitor 5 mm pitch”. A nonpolarized ceramic disc also works. Prefer 5% tolerance for a matched filter pair.
2. Check 5.0 mm lead spacing and the body dimensions in the listing. A film body must clear nearby parts and your enclosure; the stock footprint is for a 5 mm ceramic disc.
3. Buy two identical parts. Do not put 10 nF on one channel and 56 nF on the other.
4. Still buy two 10 uF, 25 V radial electrolytics for C3/C4, regardless of your filter choice. Their job is to block DC, not select the tone.

nF is not uF! A 10 nF filter cap is 0.01 uF, not 10 uF. C1/C2 and C3/C4 are not interchangeable.

Nonpolarized C1/C2 filter caps beside polarized C3/C4 electrolytics, showing plus to the square pad and the minus stripe toward the jack

Filter caps: either direction. Electrolytics: plus to the square + pad; stripe/minus toward the jack.

Keep R1/R2 = 1 kOhm, R3/R4 = 47 kOhm, C3/C4 = 10 uF. Only C1/C2 change. No PCB or firmware changes are required for these choices. Power off and unplug USB before replacing parts.

The cutoff numbers use fc = 1 / (2 * pi * R * C) with a 1 kOhm resistor. Real loading shifts the response. These options approximate one analog filter corner, not a complete original Genesis audio circuit. The optional responses have not been measured on L3. Detailed filter notes.

Step 3

## Low parts first. All parts on top.

Parts go on the silkscreen side; solder underneath. With DB9 ports at the front/bottom: USB-C faces left, HDMI right, audio jack rear/top. J5 is the rear socket; J6 is the front. Socket pin 1 is at the left/USB-C end.

1. R1/R2, 1 kOhm: bend to 7.62 mm spacing, seat flat, solder and trim. R3/R4 are 47 kOhm. Resistors work either direction.
2. C1/C2: fit your selected matching pair (10, 47 or 56 nF). They are nonpolarized and can face either way.
3. C3/C4, 10 uF: positive lead into the square + pad; the can's stripe marks the negative lead. The longer lead is positive on an untrimmed new part. Follow the board's polarity marks, not the jack's orientation.
4. J3, SJ1-3523N: fit all three flat pins into the plated slots and locating pegs into their holes. Tack one pin, check it is seated, then solder the rest.
5. J5/J6 sockets: hold parallel, flush, 20.32 mm apart. An unpowered Nano can align the sockets while you tack their end pins. Remove the Nano before soldering all remaining socket contacts; never solder it into the carrier.
6. J1/J2 DB9: noses face out over the front edge. Solder all nine pins and both boardlocks on each port.

Inspect for bridges and trim sharp leads. Count 13 fitted parts and four empty mounting holes. Detailed assembly notes.

L3 top-side assembly drawing with the rotated Nano sockets, rear audio filter and front DB9 ports

Open the full assembly drawing. For mechanical checks, print the fit sheet at actual size and verify its scale with a ruler.

Step 4 · Unpowered, Nano removed

## Check the board before applying power

Use the continuity checklist for every DB9 contact. Number contacts from the USB-C/left end, not from the front edge. DB9 mating-face and solder-side views are mirrored: use molded pin numbers.

Controller continuity, unchanged from canonical GenThang
DB9 pin | Signal | P1 / J1 to J6 contact | P2 / J2 to J5 contact
1 | Up / D0 | 1 | 5
2 | Down / D1 | 2 | 6
3 | Left / D2 | 5 | 9
4 | Right / D3 | 8 | 10
5 | 3.3 V supply | 19 | 16
6 | TL / B, A | 9 | 12
7 | TH select | 12 | 17
8 | Ground | 20 | 15
9 | TR / C, Start | 13 | 18

Audio and isolation checks
Check | Required result
J6.14 / GPIO31 to R1 pad 1 | Continuity: left audio input.
J6.15 / GPIO17 to R2 pad 1 | Continuity: right audio input. No jumper required on L3.
TRS plug tip to C3 minus | Continuity with the plug inserted: left output, J3 pin 2.
TRS plug ring to C4 minus | Continuity with the plug inserted: right output, J3 pin 3.
TRS plug sleeve / J3 pin 1 | Continuity to ground, as are the DB9 shells and boardlocks.
C3/C4 positive leads | Connect to the R1/R2 filter side, not directly to the jack.
3V3 to GND | No short; this should read open with the Nano removed.
J5.1 (5 V) and J5.7 (old GPIO56) | Unconnected on the carrier. Do not bridge old and new audio outputs.

If a check fails, stop. Repair the bridge, wrong part or bad joint and repeat the test. Do not plug in the Nano to "see if it works".

Step 5

## Flash the official v1.9.3 DB9 image

The standard DB9 image in the official GenThang v1.9.3 release (https://github.com/shawnchivers/genthang/releases/tag/v1.9.3) drives right audio on GPIO17 and replaces the provisional GPIO17 package. The older releases through 1.9.2 use GPIO56 for right audio and will leave L3's right channel without the intended audio signal.

1. Download genthang_nano20k_db9_flash.bin (https://github.com/shawnchivers/genthang/releases/download/v1.9.3/genthang_nano20k_db9_flash.bin) and its SHA256SUMS (https://github.com/shawnchivers/genthang/releases/download/v1.9.3/SHA256SUMS). Keep them in the same folder and verify with sha256sum -c SHA256SUMS --ignore-missing. Do not use the raw handheld or bitstream-only image.
2. Connect the Nano separately by USB-C. In Gowin Programmer choose GW2AR / GW2AR-18C, External Flash Mode, exFlash Erase, Program thru GAO-bridge, and start address 0x000000. Program the complete _flash.bin and wait for success.
3. Disconnect USB. Prepare a TF card with an MBR partition table and FAT32 or exFAT; formatting erases existing data. Copy your own .md, .bin or .gen ROMs, up to 4 MB each.
4. Insert the card before seating the Nano: its slot is underneath. Plug the Nano into both sockets with USB-C left and HDMI right. Check all 40 pins are aligned, with no one-position offset. Press evenly.

Full flashing instructions (https://github.com/shawnchivers/genthang#1-flash-the-board) · TF card setup (https://github.com/shawnchivers/genthang#2-prepare-the-tf-card). Standard builds do not support USB ROM upload; lift the Nano out to update the card.

Step 6

## Power up, then listen

1. Place the board on a nonconductive surface, with no controller attached. Connect HDMI, then USB-C power. Measure about 3.3 V between DB9 pins 5 and 8 on each port. Avoid shorting adjacent pins with the probes.
2. Power off. Connect a pad to J1/player 1, power on and launch a game. Test directions, A/B/C and Start. Test the second port in a two-player game, changing controller connections only while unpowered.
3. Power off. Connect the powered speakers with their volume at zero, then power on. Launch a game and raise volume slowly. Verify left and right with a known stereo passage or channel test.
4. On a display that dislikes HDMI audio/data islands, choose Video output: DVI+LINE OUT in the options menu. The analog jack works in HDMI mode too. Audio is muted while the game menu is open.
5. Open the in-game menu with Start+A+B+C on a 3-button pad or Mode+Start on a 6-button pad. Menu navigation uses player 1.

If one channel is quiet or hums: first check the exact SJ1-3523N jack, its solder joints, plug-to-cap continuity, cable and speaker channel. Changing filter caps changes the tonal response; it is not a fix for a broken joint or incorrect jack. GPIO17 still carries an on-board LED load.

Standalone mounting: use the four M2.5 holes with nonconductive supports, keeping underside joints off the desk or metal. L3 retains L2 geometry, not O1's Nano orientation: the O1 biomechanical case is not its matching enclosure. Check real cable overmolds before selecting an enclosure.

Bench files

## Everything for this L3 carrier

- Order: OSH Park ZIP, generic Gerber ZIP, hardware checksums.
- Assemble: stock BOM, assembly notes, continuity checklist, schematic, 1:1 fit sheet.
- Inspect: top copper, bottom copper, KiCad PCB, CAD report, test status.
- Background: L3 design and capacitor notes, GenThang setup and controls (https://github.com/shawnchivers/genthang).

This page and its SVG illustrations have no external viewer or font dependency. Print it from your browser for a paper or PDF bench copy. Firmware downloads and external references require internet access.

Hardware index · Back to top

This is an unprotected hobby build; successful author testing is not ESD or production certification. Build, wire and flash at your own risk. ROMs are not included.
