shawnchivers/genthang/docs/images/console-demo.gif

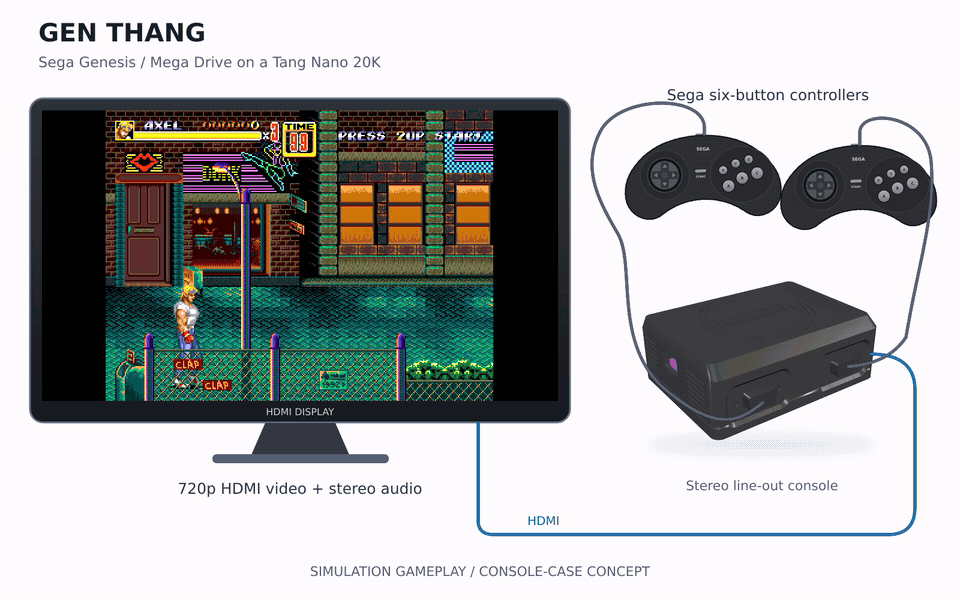
docs/images/console-demo.gif
