shawnchivers/genthang/docs/images/display-blend.png

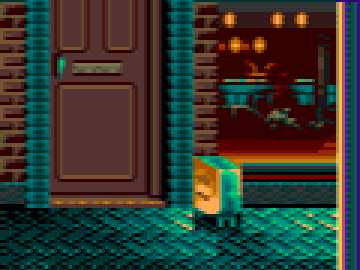
docs/images/display-blend.png
