shawnchivers/genthang/hardware/dual-db9-biomech-case/renders/back.png

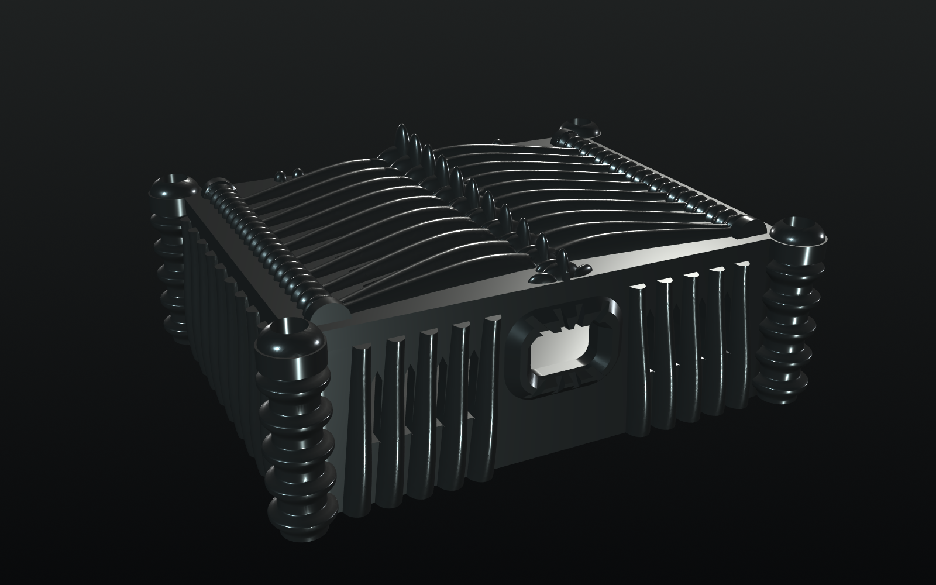
hardware/dual-db9-biomech-case/renders/back.png
