shawnchivers/genthang/hardware/dual-db9-biomech-case/renders/front.png

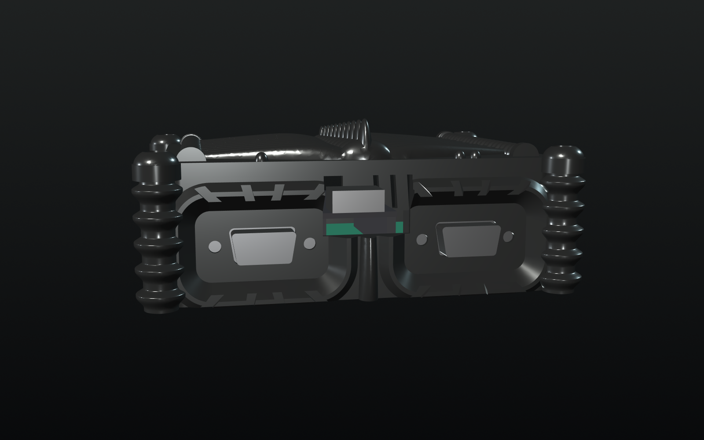
hardware/dual-db9-biomech-case/renders/front.png
