shawnchivers/genthang/hardware/dual-db9-biomech-case/renders/side.png

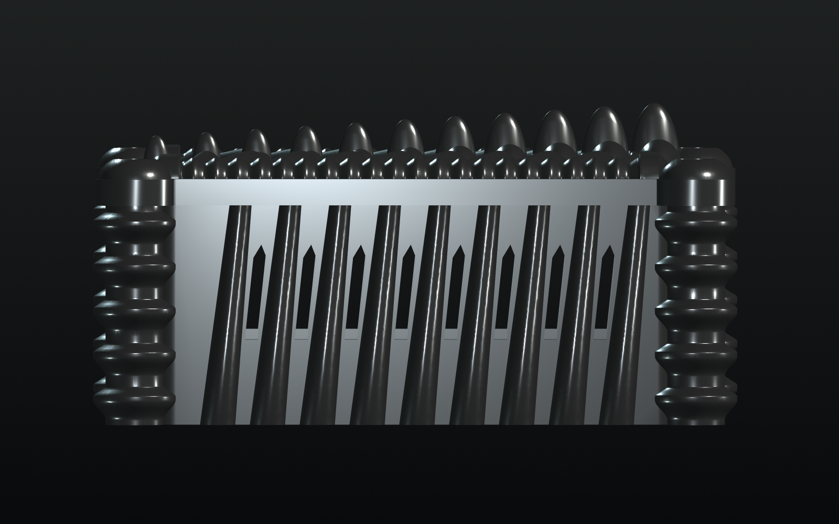
hardware/dual-db9-biomech-case/renders/side.png
