shawnchivers/genthang/hardware/dual-db9-biomech-case/renders/top.png

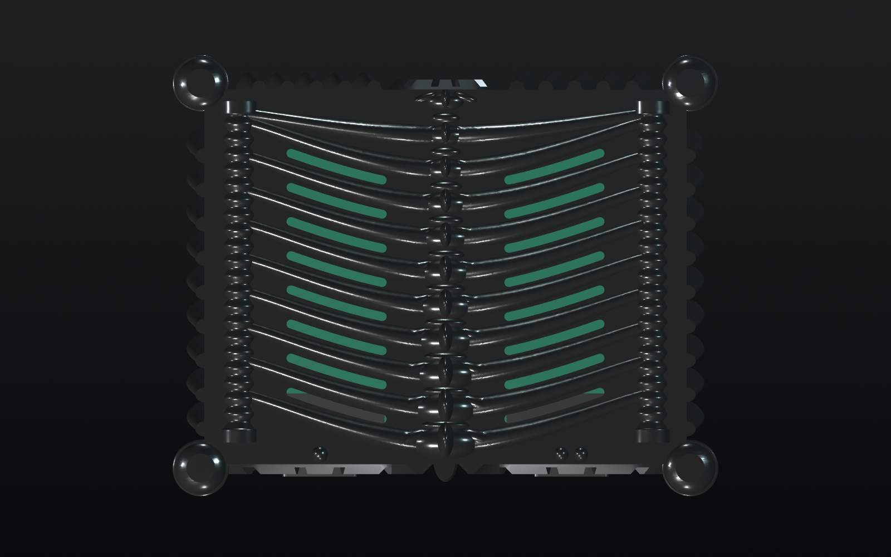
hardware/dual-db9-biomech-case/renders/top.png
