shawnchivers/genthang/hardware/dual-db9-opt-pcb/dual-db9-opt-pcb-top-bottom.png

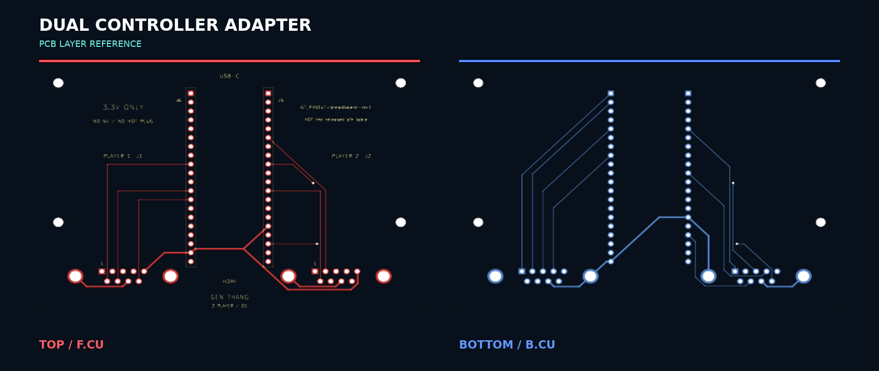
hardware/dual-db9-opt-pcb/dual-db9-opt-pcb-top-bottom.png
