shawnchivers/genthang/hardware/dual-db9-opt-pcb/dual-db9-opt-pcb-true-3d-mockup.png

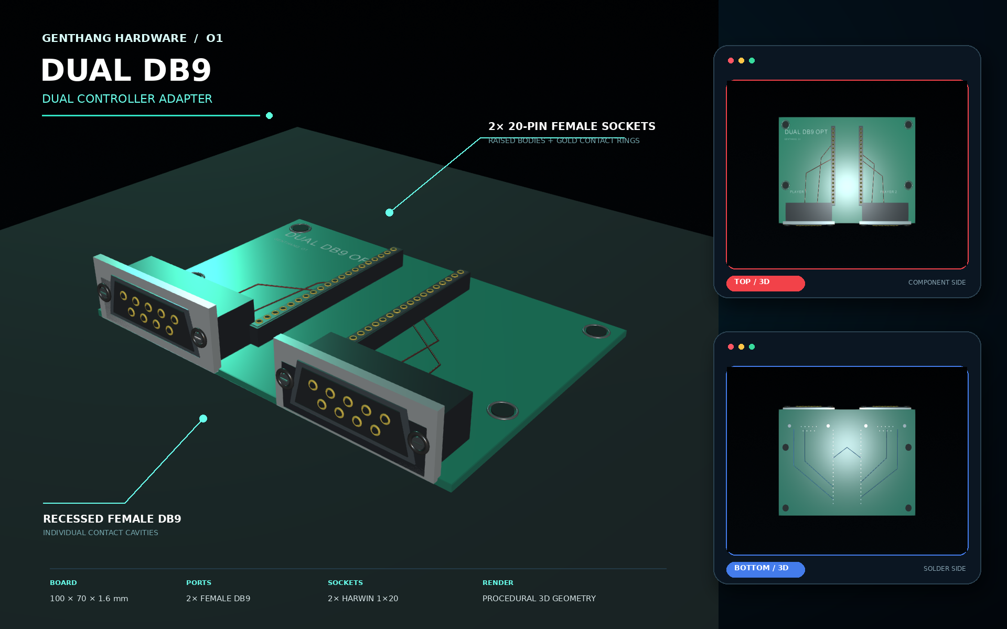
hardware/dual-db9-opt-pcb/dual-db9-opt-pcb-true-3d-mockup.png
