shawnchivers/genthang/hardware/modern-3btn-handheld/renders/buttons.png

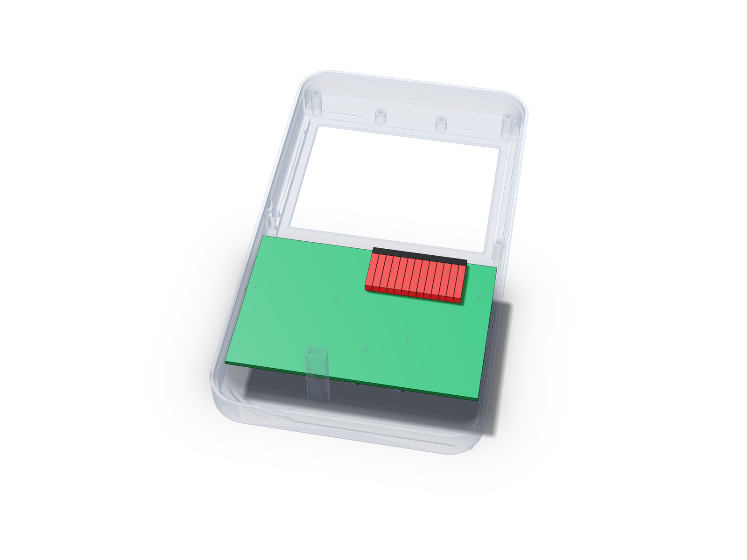
hardware/modern-3btn-handheld/renders/buttons.png
