shawnchivers/genthang/hardware/modern-3btn-handheld/renders/close.png

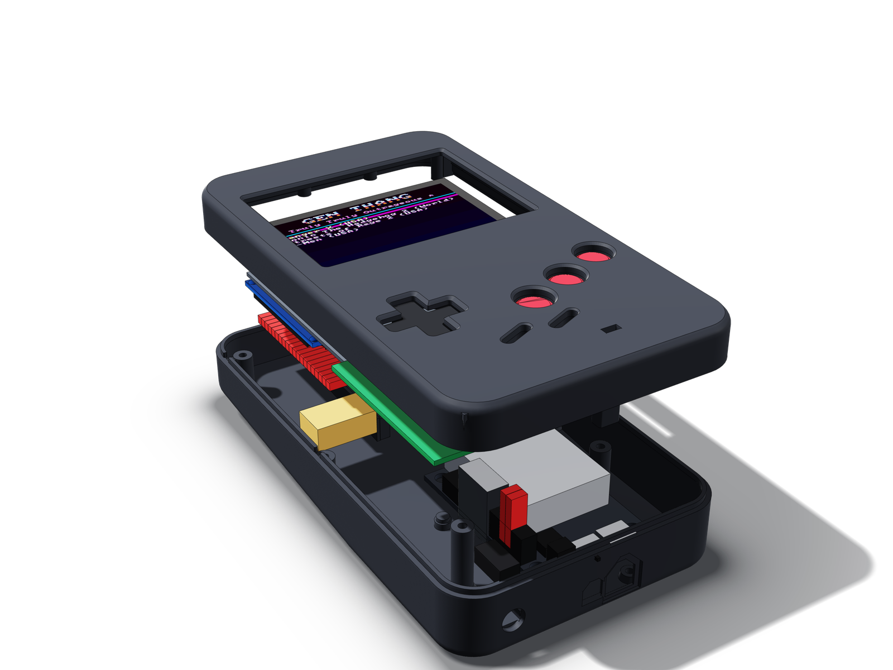
hardware/modern-3btn-handheld/renders/close.png
