shawnchivers/genthang/hardware/modern-3btn-handheld/renders/done.png

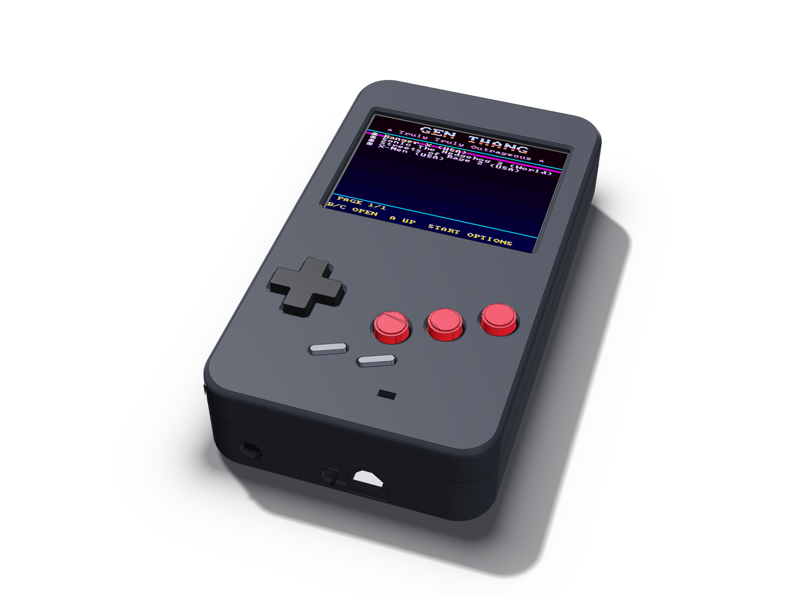
hardware/modern-3btn-handheld/renders/done.png
