shawnchivers/genthang/hardware/modern-3btn-handheld/renders/hero-back-midnight.png

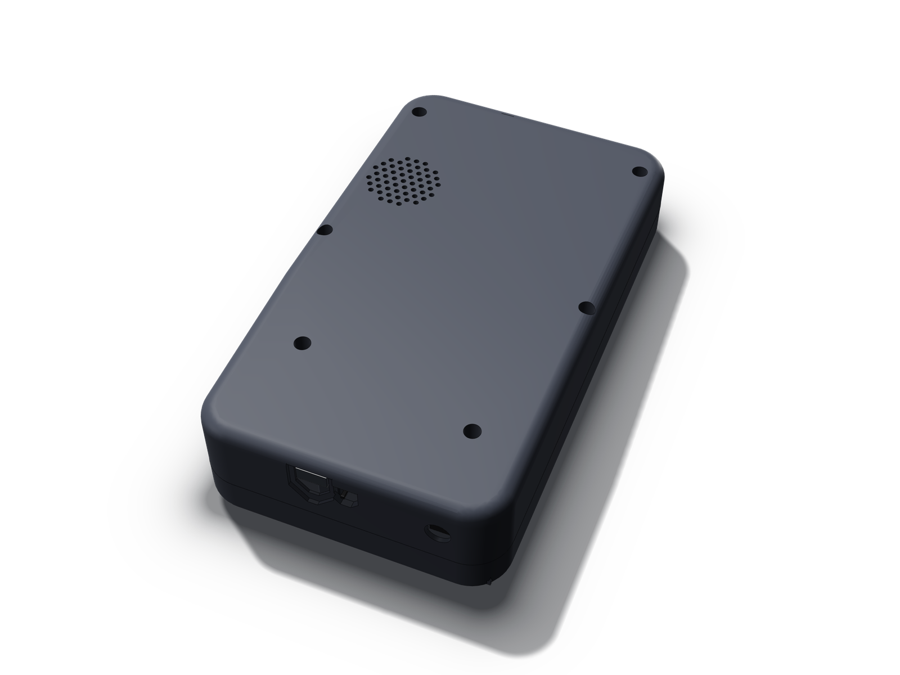
hardware/modern-3btn-handheld/renders/hero-back-midnight.png
