shawnchivers/genthang/hardware/modern-3btn-handheld/renders/inside.png

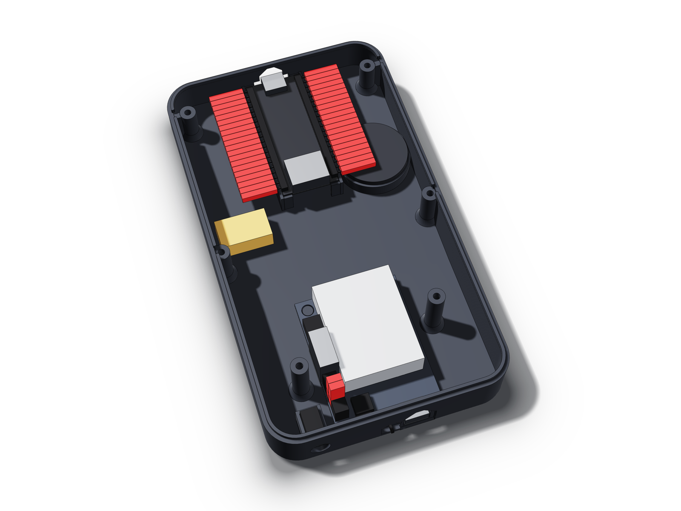
hardware/modern-3btn-handheld/renders/inside.png
