shawnchivers/genthang/hardware/modern-3btn-handheld/renders/membranes.png

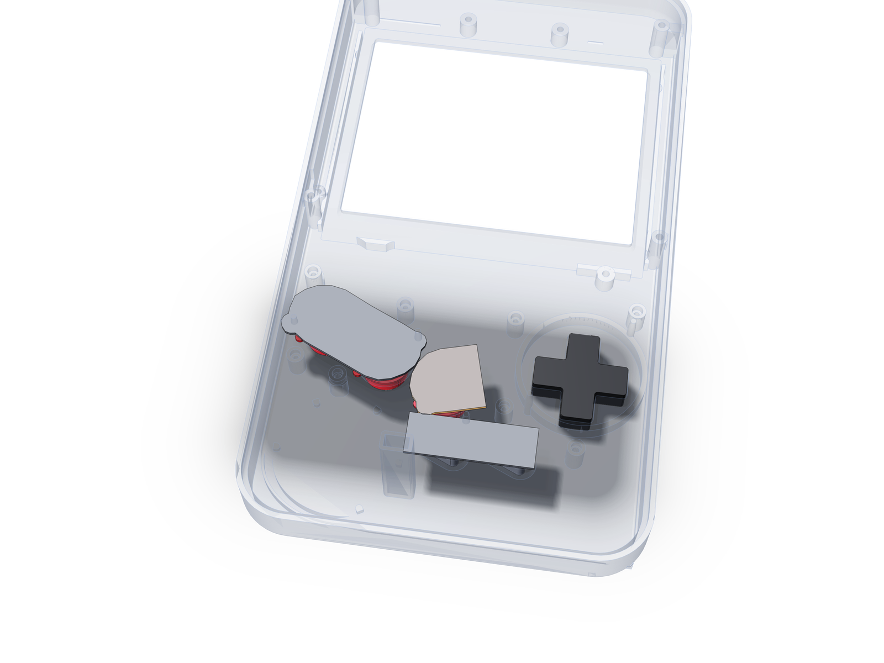
hardware/modern-3btn-handheld/renders/membranes.png
