shawnchivers/genthang/hardware/modern-3btn-handheld/renders/nano.png

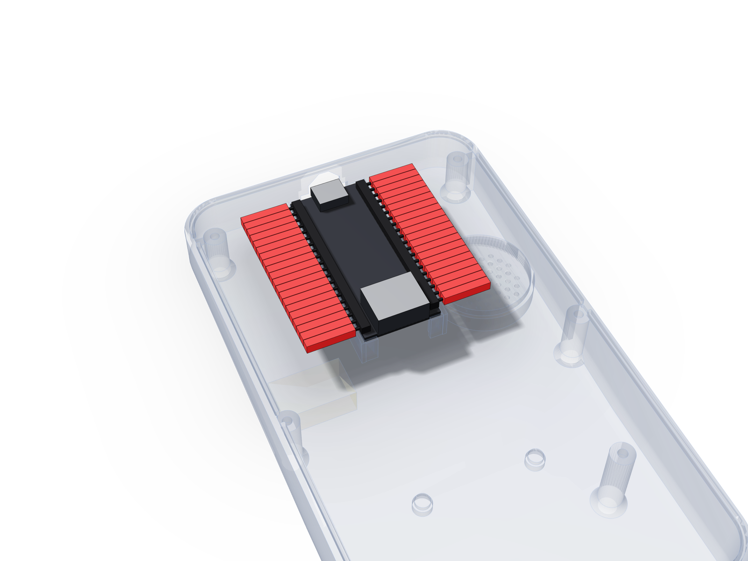
hardware/modern-3btn-handheld/renders/nano.png
