shawnchivers/genthang/hardware/dual-db9-lineout-pcb/THT-placement-reference.csv

Reference | X_mm | Y_mm | Rotation_deg | Side | Datum | Note
J6 | 25.87 | 29 | 90 | Top | Bottom-left board corner; X right/Y up; footprint anchor pin 1 | Manual THT reference, NOT SMT centroid; see assembly drawing for physical orientation
J5 | 25.87 | 49.32 | 90 | Top | Bottom-left board corner; X right/Y up; footprint anchor pin 1 | Manual THT reference, NOT SMT centroid; see assembly drawing for physical orientation
J1 | 16.46 | 10.920000000000002 | 0 | Top | Bottom-left board corner; X right/Y up; footprint anchor pin 1 | Manual THT reference, NOT SMT centroid; see assembly drawing for physical orientation
J2 | 72.46 | 10.920000000000002 | 0 | Top | Bottom-left board corner; X right/Y up; footprint anchor pin 1 | Manual THT reference, NOT SMT centroid; see assembly drawing for physical orientation
R2 | 64.0 | 63.0 | 0 | Top | Bottom-left board corner; X right/Y up; footprint anchor pin 1 | Manual THT reference, NOT SMT centroid; see assembly drawing for physical orientation
C2 | 64.0 | 57.0 | 0 | Top | Bottom-left board corner; X right/Y up; footprint anchor pin 1 | Manual THT reference, NOT SMT centroid; see assembly drawing for physical orientation
C4 | 77.0 | 63.0 | 0 | Top | Bottom-left board corner; X right/Y up; footprint anchor pin 1 | Manual THT reference, NOT SMT centroid; see assembly drawing for physical orientation
R4 | 76.0 | 56.0 | 0 | Top | Bottom-left board corner; X right/Y up; footprint anchor pin 1 | Manual THT reference, NOT SMT centroid; see assembly drawing for physical orientation
R1 | 18.0 | 63.0 | 0 | Top | Bottom-left board corner; X right/Y up; footprint anchor pin 1 | Manual THT reference, NOT SMT centroid; see assembly drawing for physical orientation
C1 | 18.0 | 57.0 | 0 | Top | Bottom-left board corner; X right/Y up; footprint anchor pin 1 | Manual THT reference, NOT SMT centroid; see assembly drawing for physical orientation
C3 | 31.0 | 63.0 | 0 | Top | Bottom-left board corner; X right/Y up; footprint anchor pin 1 | Manual THT reference, NOT SMT centroid; see assembly drawing for physical orientation
R3 | 30.0 | 56.0 | 0 | Top | Bottom-left board corner; X right/Y up; footprint anchor pin 1 | Manual THT reference, NOT SMT centroid; see assembly drawing for physical orientation
J3 | 50.0 | 65.5 | 180 | Top | Bottom-left board corner; X right/Y up; footprint anchor pin 1 | Manual THT reference, NOT SMT centroid; see assembly drawing for physical orientation
