shawnchivers/genthang/hardware/dual-db9-biomech-case/dual-db9-biomech-case.step

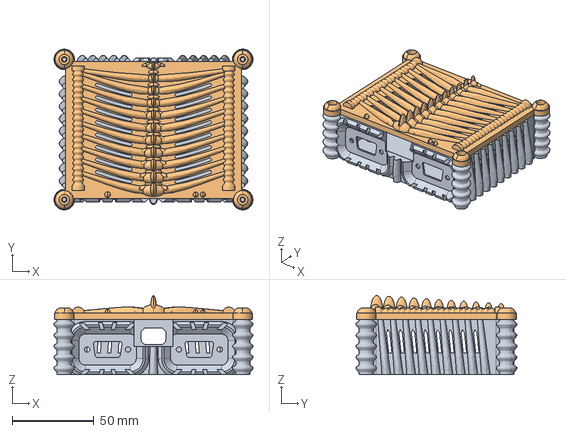
[picture p48: CAD file, 2026-10-20]
hardware/dual-db9-biomech-case/dual-db9-biomech-case.step
121.6 x 98.3 x 48.3 mm
case_base
case_lid
