shawnchivers/genthang/hardware/dual-db9-biomech-case/mockup/sockets.stl

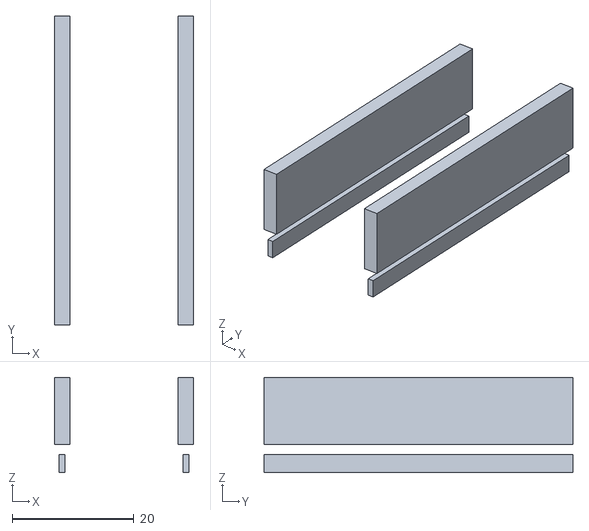
[picture p49: CAD file, 2026-10-20]
hardware/dual-db9-biomech-case/mockup/sockets.stl
22.9 x 50.8 x 15.6
