shawnchivers/genthang/hardware/dual-db9-biomech-case/stl/case_base.stl

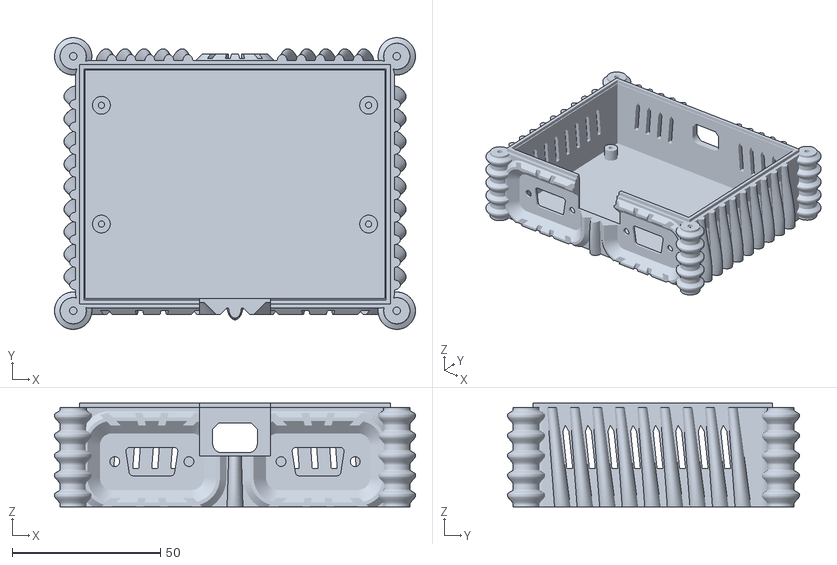
[picture p50: CAD file, 2026-10-20]
hardware/dual-db9-biomech-case/stl/case_base.stl
121.6 x 98.3 x 35.0
