shawnchivers/genthang/hardware/dual-db9-biomech-case/mockup/pcb.stl

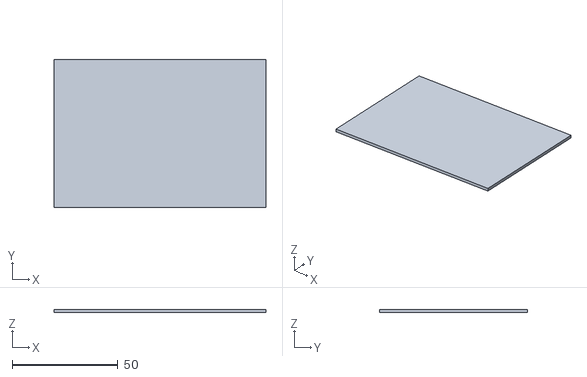
[picture p51: CAD file, 2026-10-20]
hardware/dual-db9-biomech-case/mockup/pcb.stl
100.0 x 70.0 x 1.60
