shawnchivers/genthang/hardware/dual-db9-biomech-case/stl/case_lid.stl

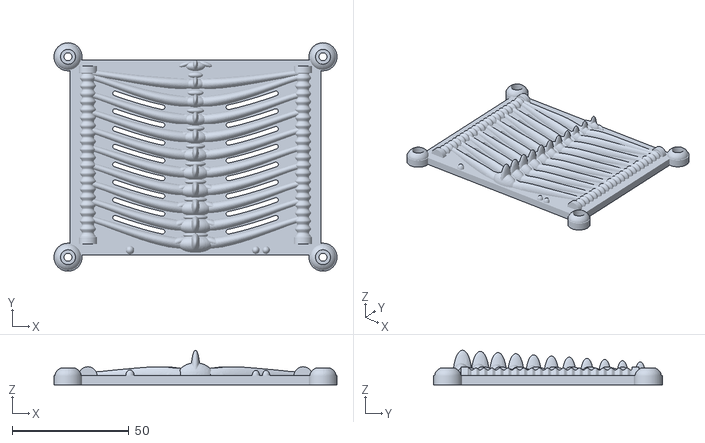
[picture p52: CAD file, 2026-10-20]
hardware/dual-db9-biomech-case/stl/case_lid.stl
121.0 x 97.7 x 14.8
