shawnchivers/genthang/hardware/dual-db9-biomech-case/mockup/usbc.stl

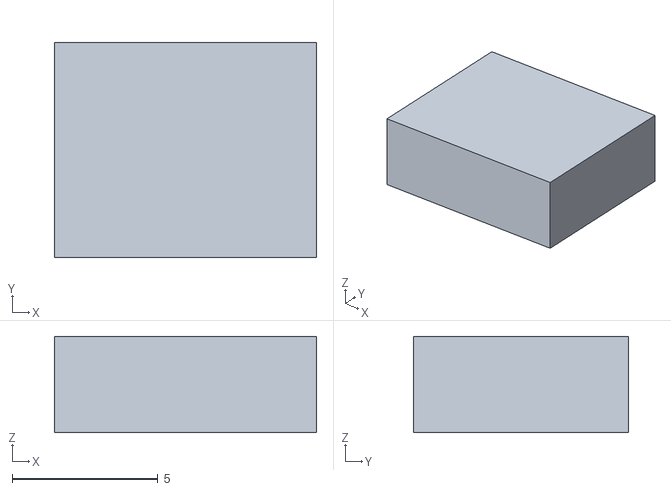
[picture p53: CAD file, 2026-10-20]
hardware/dual-db9-biomech-case/mockup/usbc.stl
9.00 x 7.40 x 3.30
