shawnchivers/genthang/hardware/dual-db9-biomech-case/mockup/hdmi.stl

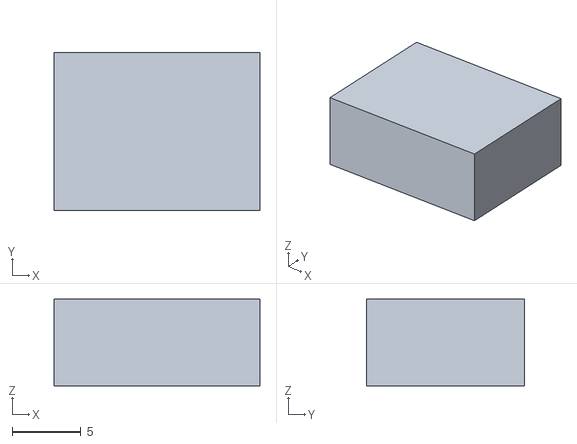
[picture p54: CAD file, 2026-10-20]
hardware/dual-db9-biomech-case/mockup/hdmi.stl
15.0 x 11.5 x 6.30
