shawnchivers/genthang/hardware/dual-db9-biomech-case/mockup/db9.stl

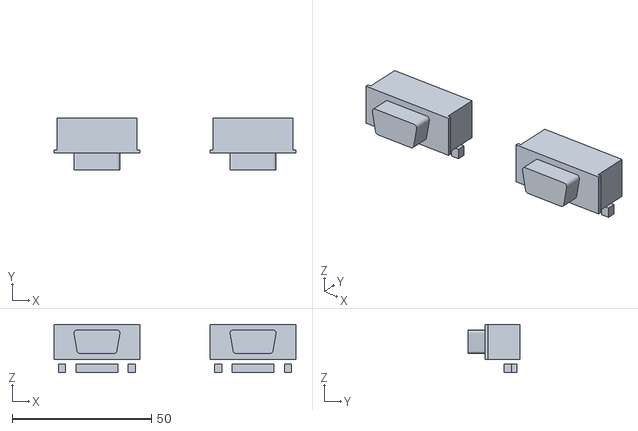
[picture p55: CAD file, 2026-10-20]
hardware/dual-db9-biomech-case/mockup/db9.stl
86.8 x 18.5 x 17.3
