shawnchivers/genthang/hardware/dual-db9-biomech-case/mockup/plugs.stl

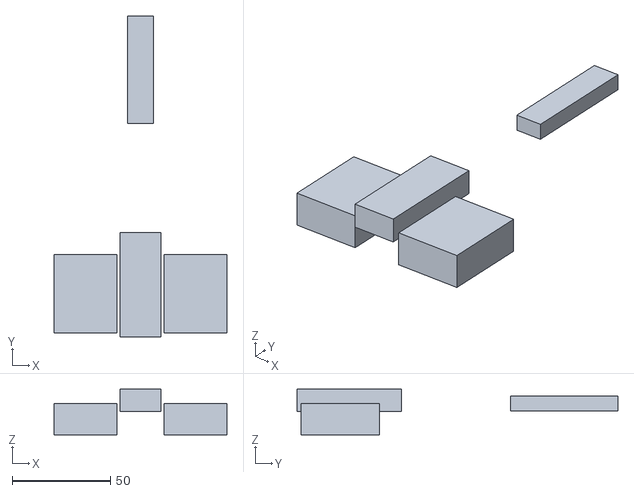
[picture p56: CAD file, 2026-10-20]
hardware/dual-db9-biomech-case/mockup/plugs.stl
88.0 x 163.4 x 23.3
