shawnchivers/genthang/hardware/dual-db9-biomech-case/mockup/nano.stl

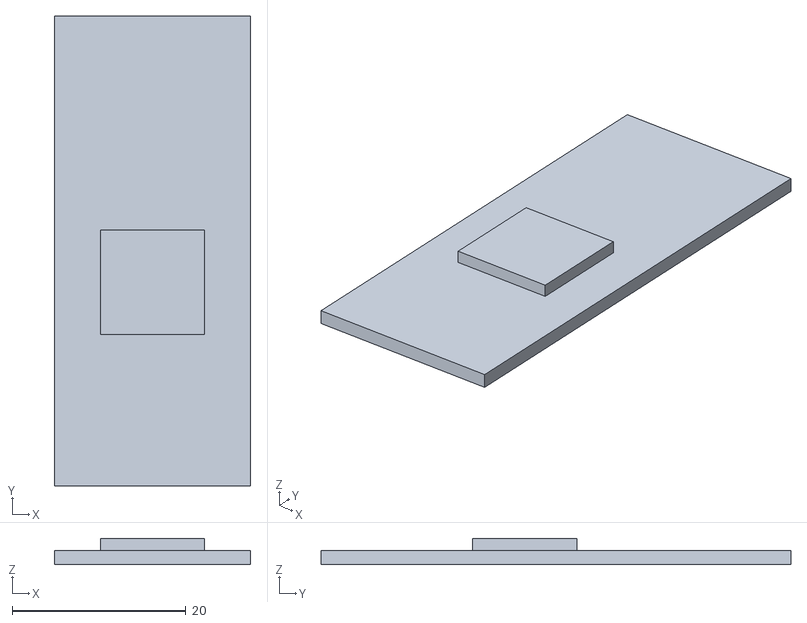
[picture p57: CAD file, 2026-10-20]
hardware/dual-db9-biomech-case/mockup/nano.stl
22.6 x 54.0 x 3.00
