shawnchivers/genthang/hardware/dual-db9-biomech-case/mockup/screws.stl

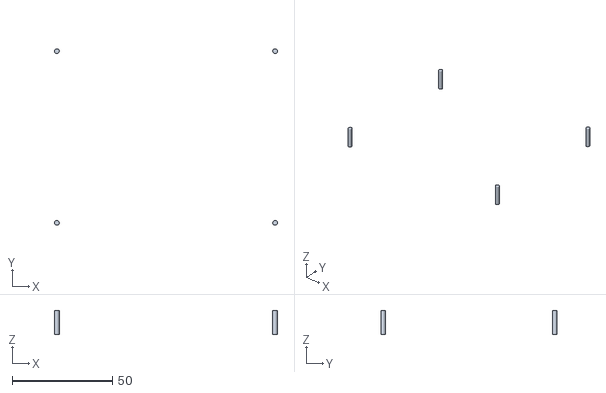
[picture p58: CAD file, 2026-10-20]
hardware/dual-db9-biomech-case/mockup/screws.stl
111.4 x 88.1 x 12.0
