shawnchivers/genthang/hardware/modern-3btn-handheld/renders/print.png

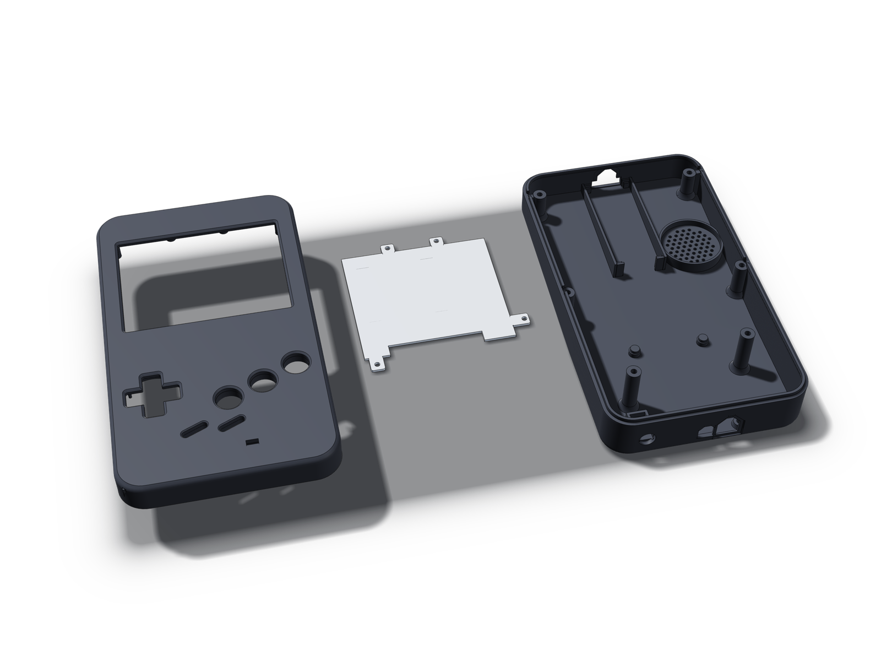
hardware/modern-3btn-handheld/renders/print.png
