shawnchivers/genthang/CHANGELOG.md

# Changelog

## Unreleased

## 1.9.3 - 2026-11-07

- **Official ladder-audio builds:** YM2612 Model 1 DAC distortion is enabled for
  every release variant. Adaptive blending and runtime core switching are removed
  to fit the Nano 20K; normal composite blending, scanlines, game loading/reset,
  save states and handheld brightness remain. Existing adaptive settings become
  normal blend ON. Combined flash images include matching 1.9.3 menu firmware.
- The DB9 GPIO17/L3 ladder implementation was hardware-tested before release:
  flash programming/verification and reboot passed, and the user confirmed
  working operation and sound closer to the original. Other variants are checked
  by synthesis, placement/routing, timing and targeted regression tests.

- **GPIO17/L3 ladder audio build:** enables YM2612 Model 1 DAC distortion, with
  shared 10-bit JT12 output arithmetic verified against all 4,096 input/mode/pan
  combinations. Adaptive blending and runtime core switching are omitted to fit;
  normal blending, scanlines, game loading, reset and save states remain. Legacy
  adaptive settings map to normal blending. The matching menu detects omitted
  features through core-ID bits 19/20. A sized flash-bootstrap counter provides
  the final placement savings. All timing targets pass with zero negative slack,
  leaving 9 CLS and 128 logic slots. Flashed and verified on hardware; the user
  reports working operation and sound closer to the original. Published separately
  from the standard 1.9.2 builds; its menu version remains 1.9.2.

- **DB9 right line-out moved to GPIO17 (J6 contact 15)** for the L3 line-out
  carrier, instead of GPIO56 (J5 contact 7), which is shared with the on-board
  amplifier and FPGA configuration. Left audio, both controller pinouts and raw
  handheld audio are unchanged. GPIO17 has the Nano's on-board LED2 load.
  L1/L2 carriers need an isolated right-audio jumper from Tang J6.15 to PCB J5.7;
  their original GPIO56 connection must not remain connected to that filter.

## 1.9.2 - 2026-10-25

- **Handheld menu at a fixed 50 %.** Raw (`GT_PICTURE=1`) builds draw the menu at half
  brightness, so it is no longer harsh on the LCD. Brightness still applies to games
  only. DB9 builds are unchanged.
- **Fixed: sound and loading breaking after unrelated changes.** X-Men and Gargoyles
  played only a rumble (and Aladdin could white-screen) whenever unrelated logic changed,
  even though timing passed. Synthesis optimizes the whole chip, so it resolved the `x`
  don't-care values in the 68K (fx68k) and Z80 (T80) cores differently in each build.
  They are now fixed at `0`. Found by step-by-step hardware tests that ruled out the JT12
  and Z80 timing exceptions, the SDRAM clock phase and the Z80 clock phase.

## 1.9.1 - 2026-10-25

- **Raw build: sound and game loading fixed.** The 1.9.0 Color mode / Brightness stage
  broke X-Men audio (only a rumble) and white-screened some games (Aladdin) on the
  handheld, even though the build met timing. Bisected on hardware to that stage alone.
  **Color mode is removed**; **Brightness** (100 / 75 / 50 / 25 %) now reuses the
  scanline dimmer, with no extra pipeline stage. It dims games only; the menu stays
  at full brightness. A Color mode saved by 1.9.0 is ignored.
- **New `raw_3btn` image** (`GT_PAD=raw GT_3BTN=1`) for the single-player three-button
  handheld: player 1 is a 3-button pad, port 2 reads as unplugged (Streets of Rage 2 no
  longer sees a second player), and **Mode alone** opens the menu (20 ms debounce).
  Other builds keep Mode+Start / Start+A+B+C.

## 1.9.0 - 2026-10-25

- **Raw build: Color mode and Brightness options.** The handheld build adds saved
  **Color mode: Original / Warm / Cool / Vivid** and **Brightness: 100% / 75% / 50% / 25%**
  menu options, applied to games and menus after scanlines and blending (software
  dimming, not the LCD backlight). They are behind the new `GT_PICTURE` build flag, on by
  default for `GT_PAD=raw` and off for DB9, whose build has no logic to spare. The core
  reports the flag in bit 16 of the core ID register, so the shared menu firmware only
  shows the options on builds that have them. Older settings files still load.

- Tested on the handheld (raw build): Toy Story, Sonic & Knuckles + Sonic 2, and the
  Color mode and Brightness options. The DB9 build has these fixes too but was only
  verified in simulation.

- **Fixed: Sonic & Knuckles + Sonic 2 (lock-on) showed a white/black screen.** S&K writes 1
  to `$A130F1` and then jumps to the locked-on Sonic 2 code at `$300000`. The core took
  every such write as "map cartridge SRAM over `$200000-$3FFFFF`" and executed SRAM. That
  register only exists on cartridges with backup RAM, so the core now honours it only when
  the loaded ROM declares backup RAM (`RA` at `$1B0`) or, for S&K lock-on images, the
  locked-on game does (`RA` at `$2001B0`, which Sonic 3 has and Sonic 2 lacks). The menu
  firmware checks this while loading and passes it with the end-of-load write, which costs
  the FPGA almost no logic (a comparator version did not fit the DB9 build). This matches
  BlastEm. Among the test ROMs only Sonic & Knuckles (alone and with Sonic 2) changes
  behaviour; Sonic 3 & Knuckles still saves through `$A130F1`.

- **Fixed: games of exactly 4 MB showed a white screen and never started** (Toy Story,
  Sonic 3 & Knuckles, Ultimate Mortal Kombat 3, Sonic 3D Blast, ...). The loader counts
  32-bit words in a 21-bit counter, but `md20k_core.sv` passed only its low 20 bits to the
  core as the ROM size. A full 4 MB ROM (0x100000 words) therefore wrapped to size 0, and
  every cartridge read, including the reset vectors, returned 0. ROMs smaller than 4 MB
  were not affected. genthangverify did not catch it because its testbench supplies the
  ROM size directly instead of going through the board loader.

- New **`GT_VIDEO=800x480`** build (`genthang_nano20k_<pad>_800x480.fs`) for bare TFT
  panels behind a scaler-less DVI decoder such as the Adafruit TFP401 with an 800x480
  40-pin panel, which cannot display 720p. It outputs 800x480 at 59.9 Hz (CVT timing,
  992x500 total, 29.7 MHz pixel clock from a 148.5 MHz PLL) and always as DVI. The
  Display option picks a centred 640x480 window (TV) or the full 800 width (LCD).
  The default 720p build is unchanged. Result: logic 95% (19544/20736), CLS 10145/10368,
  timing met (hclk Fmax 82 MHz). Tested on the board with an Adafruit TFP401 and an
  800x480 TFT. `release.sh` now also builds `db9_800x480` and `raw_800x480`.

## 1.8.0 - 2026-10-20

- Added a saved **Display: TV / 4:3 LCD** option for panels whose controllers
  squeeze the full 720p input onto a 4:3 screen (such as a 640x480 PCB800850 kit).
  LCD mode fills the input width for both games and menus; TV mode retains the
  existing centred 4:3 window and remains the default.
- Reverted the 68000 refresh change that kept the 128-cycle phase across DMA bus
  hand-overs (`d294e0f`, shipped in 1.7.0). It fixed one Aladdin frame but broke Alien 3
  (30 frames) and the Streets of Rage 2 trash-can demo. Refresh timing around DMA is a
  known trade-off; see the "Regression-sensitive" section of `docs/known-issues.md`
  before changing it.

## 1.7.0 - 2026-10-17

- **USB serial upload removed from the default build** so the design fits the GW2AR-18
  again. Since the VDP slot-timing change (`08dbf6c`) every build failed placement by
  42-348 LUTs at 100% CLS. The iosys UART is now only built with `GT_SERIAL_UPLOAD=1`
  (which fits with the register-file change below, but with only 9 spare CLS); without
  it the menu ignores the serial port and its debug output, and releases no longer ship
  the upload tools. Copy ROMs and core images to the card in a card reader.
- The menu's PicoRV32 uses a single-read-port register file (`ENABLE_REGS_DUALPORT=0`),
  halving its distributed RAM. The menu CPU takes an extra cycle for instructions with
  two source registers.
- Result: logic 97% (20101/20736), CLS 10270/10368, timing met on all clocks
  (clk_sys 62.6 MHz against 54 MHz). Not yet tested on the board.
- 68000 refresh keeps its 128-cycle phase across DMA bus hand-overs (fixes seven wrong
  pixels in an Aladdin palette transition; see `docs/known-issues.md`).
- **Removed the deprecated DualShock build** (`GT_PAD=ds`, `nano20k_ds.cst`,
  `dualshock_controller.v`). `GT_PAD` now accepts only `db9` and `raw`; every build has the
  line-out jack.
- **Raw build: new handheld pinout (rewire existing raw builds).** The pins are laid out for
  a Nano mounted component side forward. The D-pad (J6.8–11) and the 3.5 mm jack (J6.12–14)
  are on the left header. The face buttons sit in column pairs (X/A J5.5–6, Y/B J5.10/12,
  Z/C J5.17–18) with Start on J5.3 and Mode on J5.13. `btn_n[0..11]` is now on
  `49, 41, 86, 76, 27, 28, 25, 26, 71, 48, 42, 72`; it was on the DB9 data pins.
- Raw build: plays through the Nano's on-board MAX98357A speaker amplifier (`src/i2s_tx.v`,
  48 kHz mono, −12 dB). The speaker mutes when headphones are plugged into a switching jack;
  detection is on pin 29. The line-out moves to pins 31/30 with the RC filter values for
  headphones.

## 1.6.2 - 2026-10-14

- Fixed the menu's "Reset game" sometimes freezing the game (for example Streets of Rage 2
  stopping on a still picture). The menu overlay pauses the core, and the reset was sent
  entirely inside that pause. The fx68k 68000 only takes a reset when its clock enables run
  while it is held, so depending on where the CPU was frozen the reset was lost. The 68000
  then carried on with the old game while the Z80 and YM2612 had been reset. The pause is now
  lifted while the reset is asserted. Tested on the board with repeated resets in SOR2.
- Verilator `tb_ref`: `+sreset`, `+sreset_len`, `+spause`, `+oldpause` and `+sprobe` reproduce
  and inspect a menu reset.

## 1.6.1 - 2026-10-13

- Fixed the Streets of Rage 2 stage 1 trash-can glitch (a stray pixel column beside the
  can, or black dots and a white line on it). The VDP line buffers now use Gowin
  simple-dual-port BSRAM instead of true dual-port, whose sprite buffer returned corrupted
  colour bits on the board although simulation and timing were clean. The sprite buffer
  write port runs on the falling clock edge, fed straight from registers. See
  `docs/sor2-trashcan-glitch.md`.
- Added the `GT_NO_SOUND=1` build option (debug builds without FM, PSG and audio filters).
- Known issue: the menu's "Reset game" can hang some games (`docs/known-issues.md`).

## 1.6.0 - 2026-10-11

- Added a **Video output** menu option: HDMI (default) or DVI. DVI sends the picture
  without HDMI data islands and therefore without audio. An LG 50PN6500 plasma pulsed
  on mid and dark tones whenever any data island was present, whatever it carried;
  standalone HDMI tests showed DVI and island-free output were stable. The setting is
  saved in `GENTHANG.CFG` (third character), which older firmware ignores.
- Added a stereo 3.5 mm line-out on DB9 and raw builds: 1-bit sigma-delta audio on
  FPGA pins 31 (left, J6 row 14) and 56 (right, J5 row 7), filtered off board with
  1 kOhm, 10 nF and 10 uF per channel. It works in HDMI and DVI modes. The menu shows the DVI setting as
  "Video output: DVI+LINE OUT". Without the filter the jack is not hot-pluggable.
- Restored 68K DRAM refresh timing: every 128 CPU cycles the next 68K bus cycle
  waits 2 cycles, as on the console. CPU-bound code no longer runs ~1.6% fast.
- 68K writes to the VDP no longer take an extra wait state when the VDP FIFO has
  room. Together these match BlastEm's bus timing in the genthangverify probes
  and fix Flicky running two frames ahead of the reference.
- The menu's serial port baud divider is now fixed at 115200 baud (the only
  rate the firmware uses) to free logic for the timing fix.

## 1.5.2 - 2026-10-10

- Fixed X/Y/Z/Mode on wired 6-button DB9 pads repeatedly triggering while held.
  The pad reader restarted its handshake every ~2 ms, before some pads' TH
  counters had reset, so those scans read the extra buttons as released. A
  missed 6-button reply now keeps the previous X/Y/Z/Mode state and doubles the
  pause between scans (from about 2.4 ms up to 19 ms, longer than a console
  polling once per frame); pads that reset quickly keep the short poll. Button
  changes are also reported right after each scan instead of one pause later.
- The `genesis-pad` Verilator test now models 6-button pads with 1-12 ms reset
  times and fails on any change of a held button. Bench-tested on the DB9 build
  with a wired six-button pad on P1.

## 1.5.1 - 2026-10-10

- Made the canonical dual-DB9 J6/J5 controller mapping the default and deprecated
  the separate DualShock layout. DualShock source remains available for archival
  builds but is no longer included in releases.
- Consolidated all non-DualShock controller wiring on the dual-DB9 J6/J5 pinout.
  The raw build now uses the same 12 data GPIOs as DB9 and omits only the two TH
  outputs. The DualShock constraints are unchanged.
- Replaced the separate DB9 breadboard release variants with one `db9` image.
  `GT_PINOUT=breadboard` and `breadboard-rev1` remain warning-producing aliases
  for canonical DB9; the duplicate constraint files were removed.

## 1.5.0 - 2026-10-09

- Removed the nonfunctional CRAM-dots menu option and forced the VDP option off.
  Settings files written by v1.4.2 remain readable.
- Added a dual-DB9 `breadboard-rev1` build matching the two-controller perfboard
  pinout in the Genthang hardware repository.

## 1.4.2 - 2026-10-09

- Fixed the Genesis six-button controller phase counter so the extended response
  occurs once per handshake instead of repeating every fourth rapid poll.
- Added a runtime **CRAM dots** option to the menu. It defaults to off, persists
  in `GENTHANG.CFG`, and preserves settings files written by earlier releases.
- Built and timing-checked the DualShock, raw-button, and DB9 breadboard images;
  the controller, smoke, and VDP accuracy regressions all pass.

## 1.4.1 - 2026-10-08

- Corrected per-line sprite-cell overflow handling for partially budgeted
  horizontally flipped sprites; the rendered cell selection now matches
  BlastEm in the covered Verilator comparisons. Physical hardware overflow
  ordering is not independently confirmed.
- Enabled timing-priority placement and timing-directed routing for the DS,
  raw, and DB9 breadboard release builds.

## 1.4.0 - 2026-10-08

- VDP accuracy, found with genthangverify against BlastEm: the sprite line buffer RAM is
  clocked on `CLK` here (Genesis_MiSTer uses `~CLK`), which made the "is this pixel already
  taken" read lag one pixel, so overlapping sprites lost or replaced pixels and the sprite
  collision flag was wrong. Sprite part three now issues the read two pixels ahead and
  primes the first two pixels of every tile (two extra cycles per sprite tile). Sonic 2 and
  Streets of Rage 2 scenes that differed on every frame now match BlastEm.
- `VSCROLL_BUG` is now 1 (hardware behaviour of the partial left column with per-column
  vertical scroll) instead of the MiSTer "nicer" option 0.
- Consolidated the project into the standalone `genthang` repository with a clean
  root commit while retaining the earlier development record below.
- Clarified the project's lineage: Gen Thang adapts MDTang, bringing its spirit to
  the much smaller Tang Nano 20K.
- New `db9_breadboard` image and `GT_PINOUT=breadboard` build option: single Genesis
  pad on a nine-wire DB9 breakout that avoids the Nano's HDMI-sideband GPIOs. Built
  and timing-checked, and bench-tested with a wired six-button Genesis pad.
- The two-pad stock DB9 image and its wiring notes are no longer part of this
  repository (the wiring is kept in the hardware repository).
- Build selection variables renamed `MDX_PAD` / `MDX_PINOUT` to `GT_PAD` / `GT_PINOUT`;
  Gowin outputs are now named `genthang_nano20k*`.
- `release.sh` builds the `ds`, `raw` and `db9_breadboard` variants, fails on missed
  clocks or negative slack, and packages a tarball with `SHA256SUMS`.
- Source headers now say which files are based on MDTang, Genesis_MiSTer and
  SNESTang; added `THIRD_PARTY.md`.
- Documentation rewritten: DualShock 2 and breadboard wiring, display options,
  save states, and screenshots identified explicitly as Gen Thang Verilator output.
- Gowin builds use `GOWIN_HOME`, `GW_SH` or `gw_sh` on `PATH`; no installation
  directory is assumed.
- Verilator `Makefile` no longer assumes a ROM path or tool locations; added
  `verilator/hdmi_preview.py` to preview scanlines and composite blend on dumped
  frames.
