shawnchivers/genthang/hardware/dual-db9-lineout-pcb/schematic.pdf

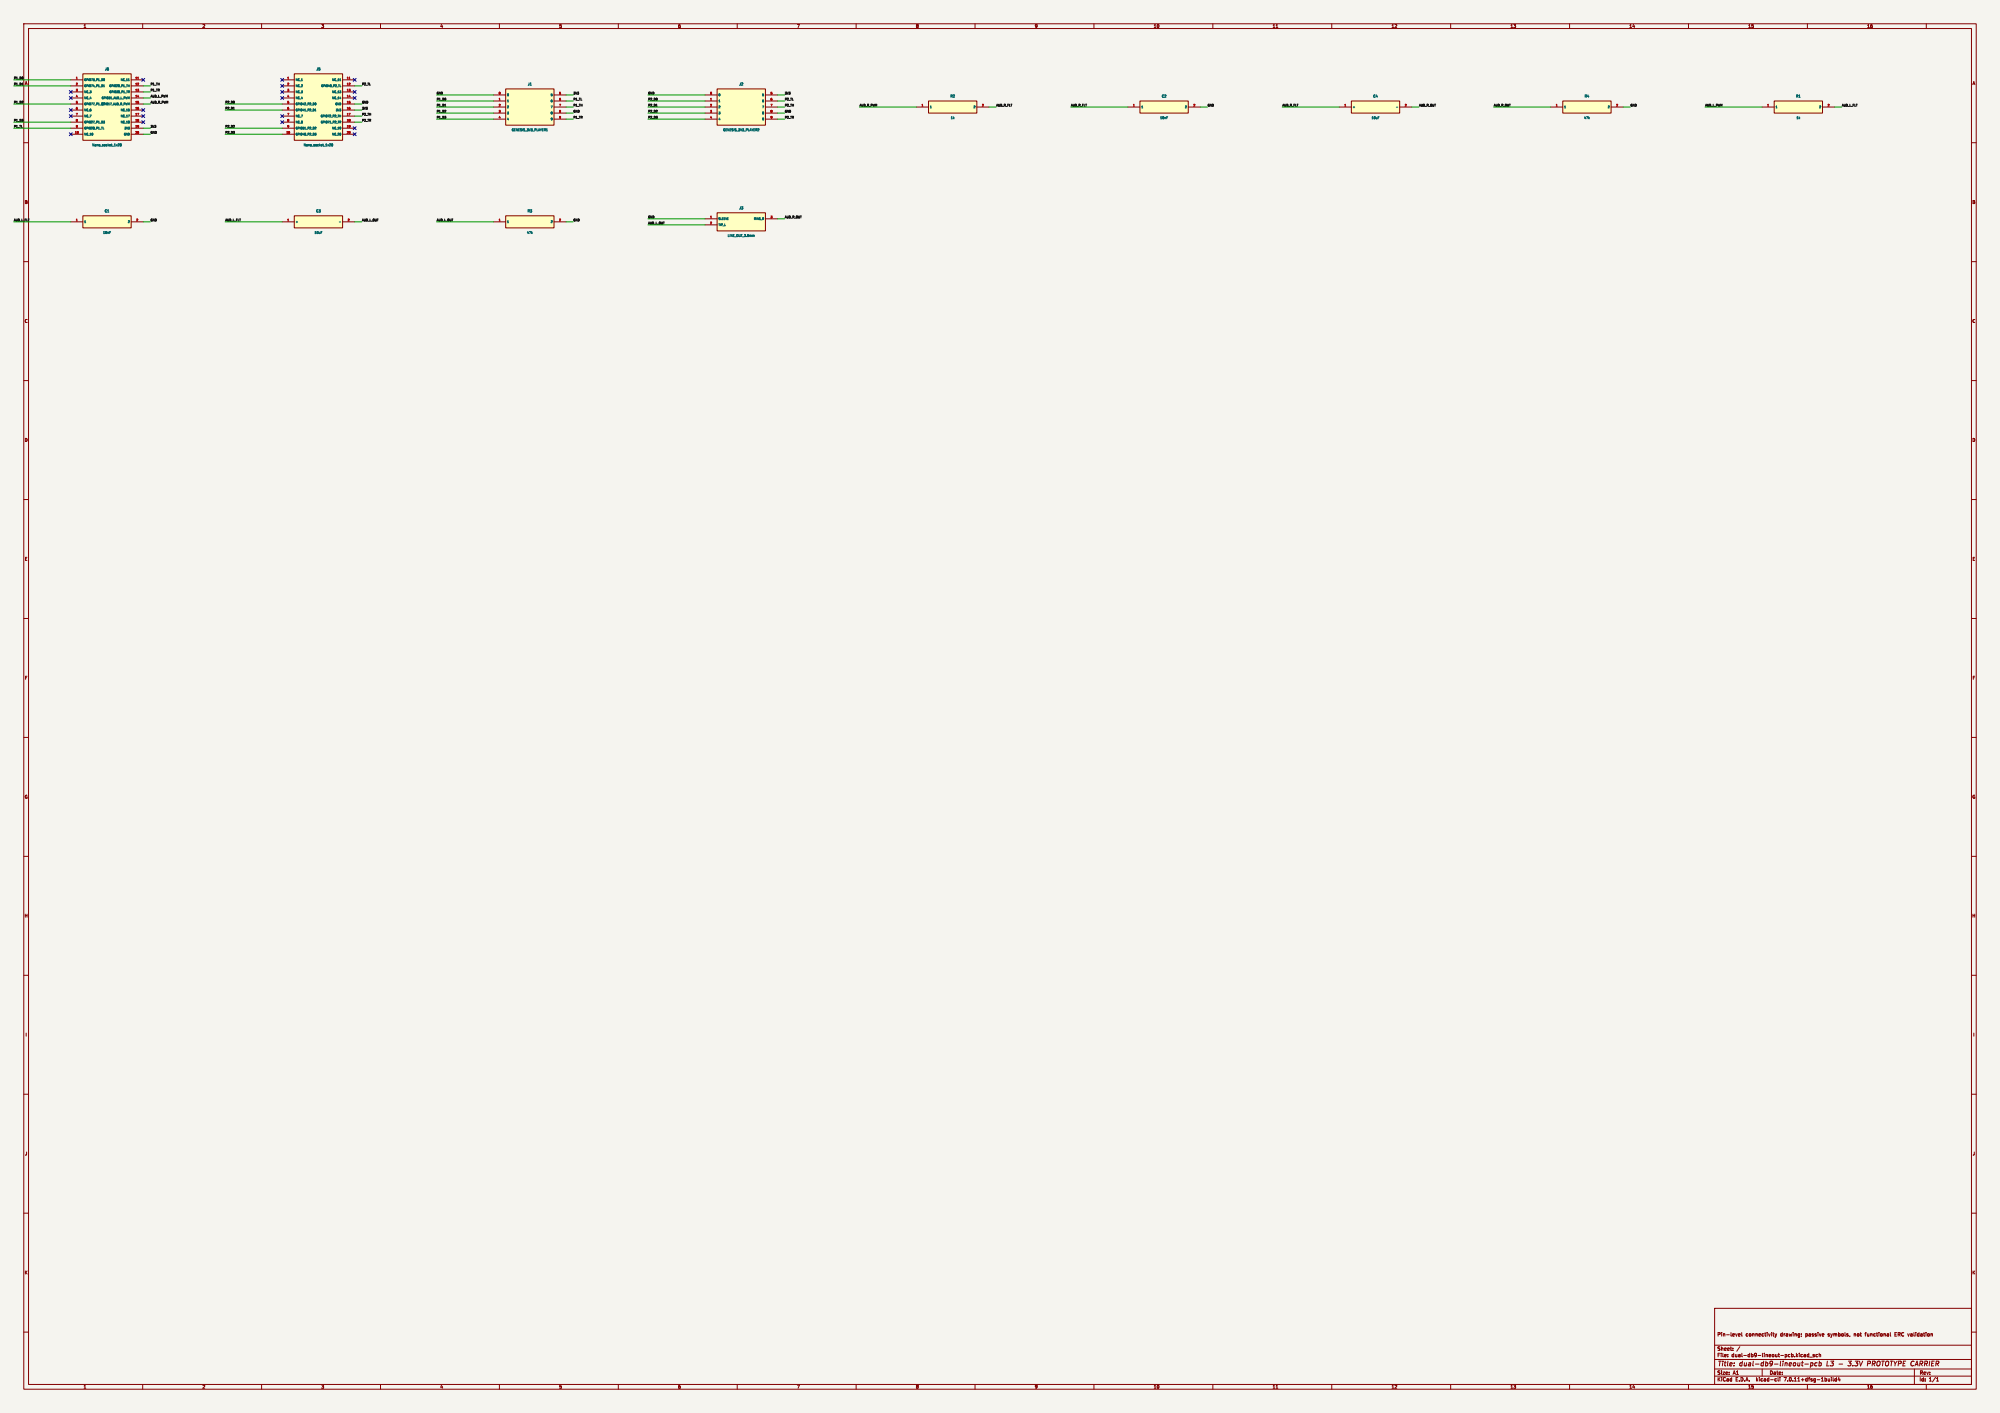
[picture p60: page 1]
