shawnchivers/genthang/hardware/dual-db9-opt-pcb/schematic.pdf

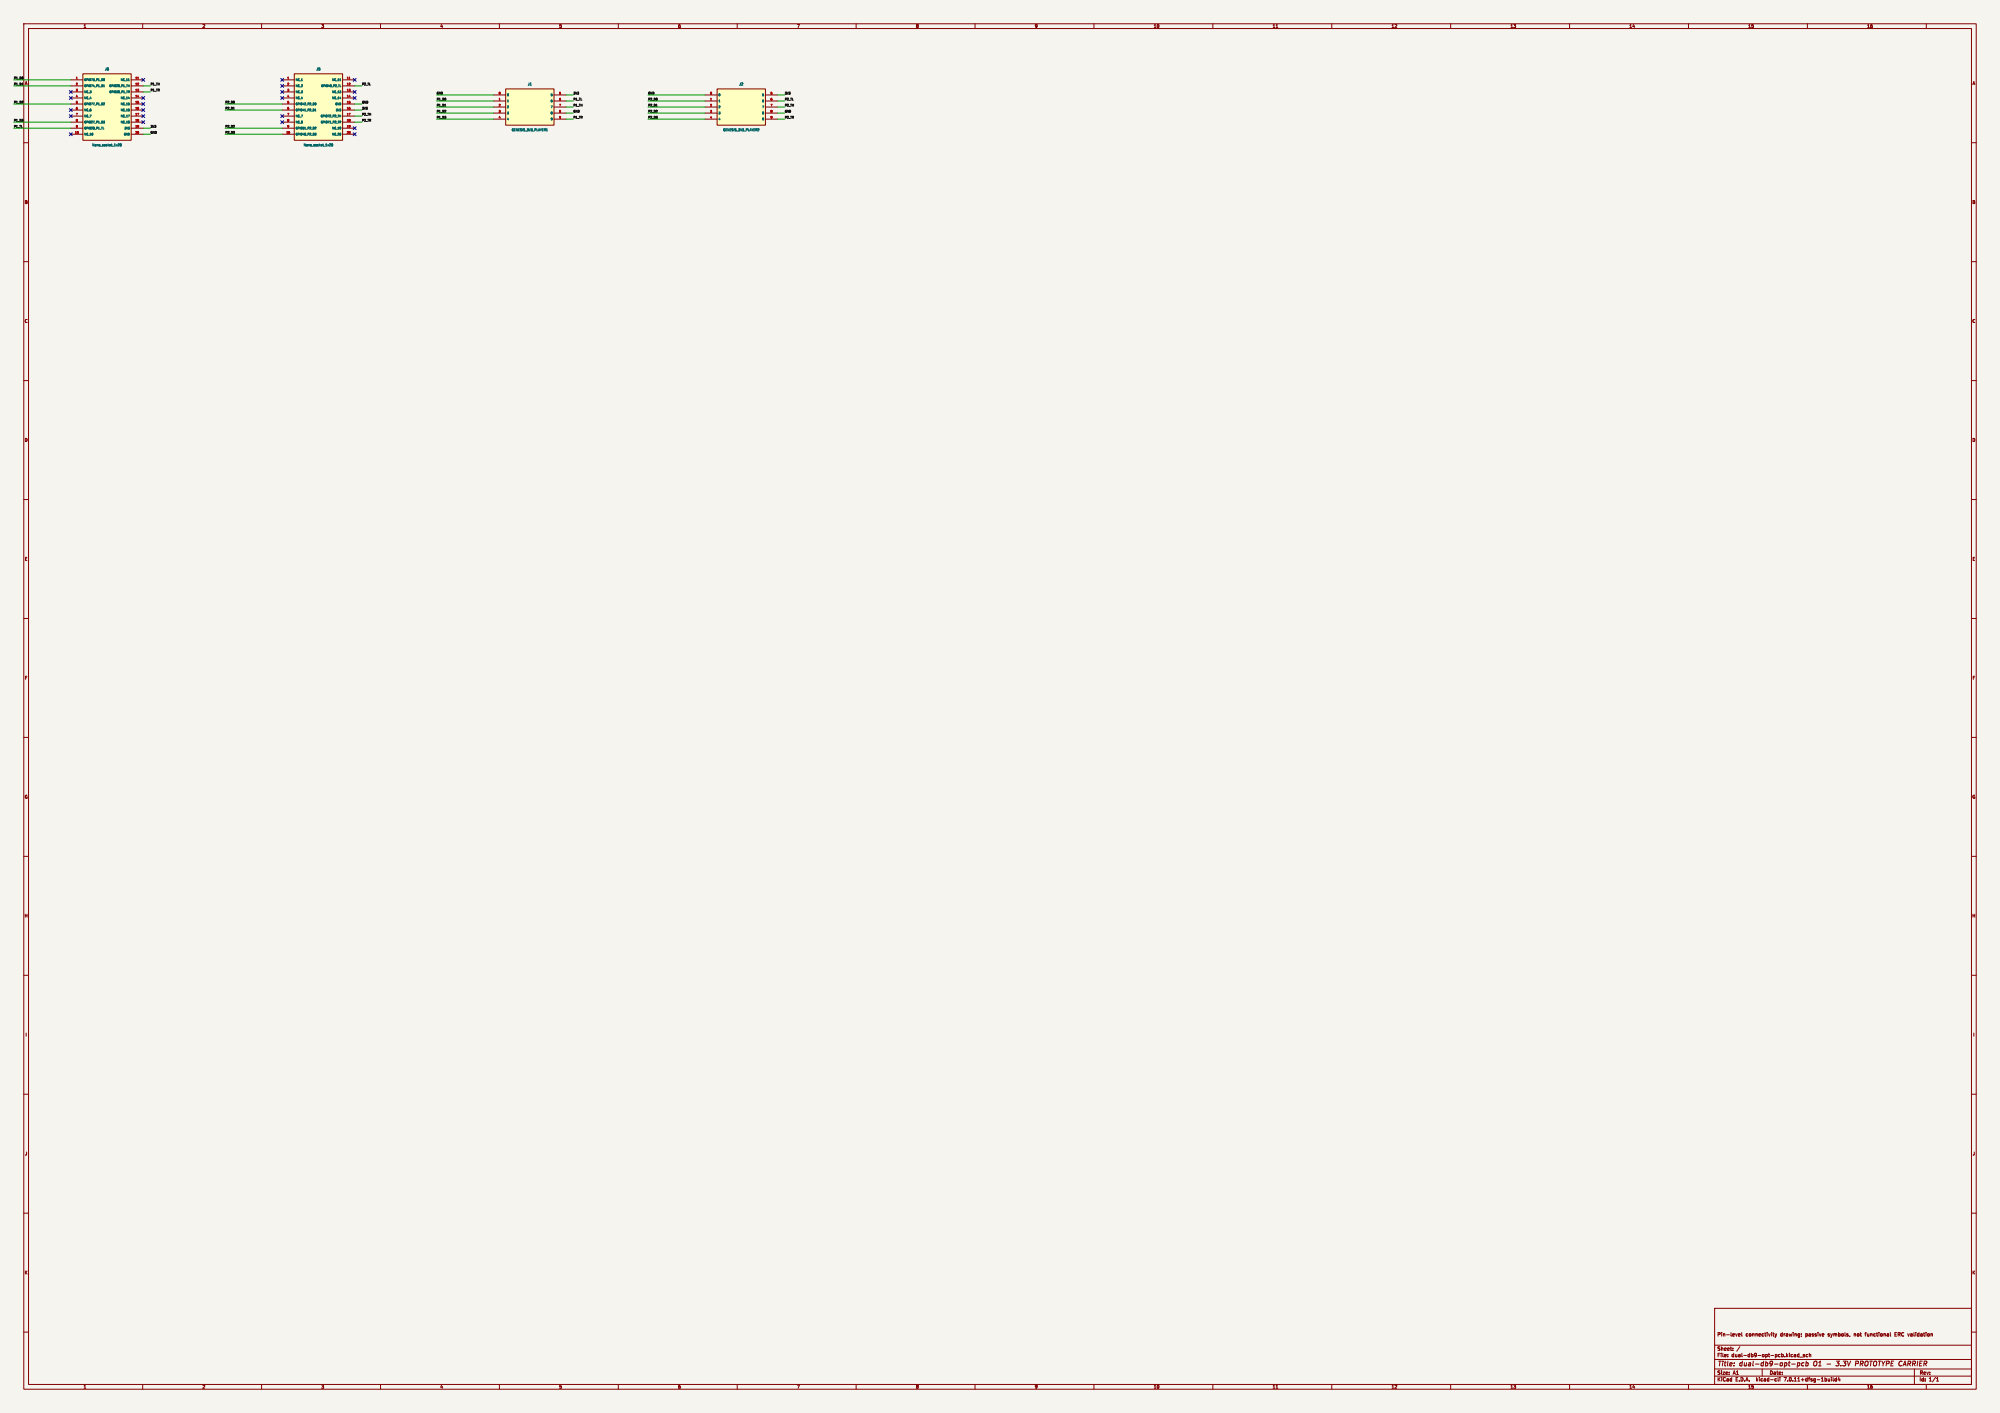
[picture p61: page 1]
