shawnchivers/genthang/hardware/dual-db9-opt-pcb/dual-db9-opt-pcb.kicad_pcb

## KiCad design hardware/dual-db9-opt-pcb/dual-db9-opt-pcb.kicad_pcb (2026-10-20)

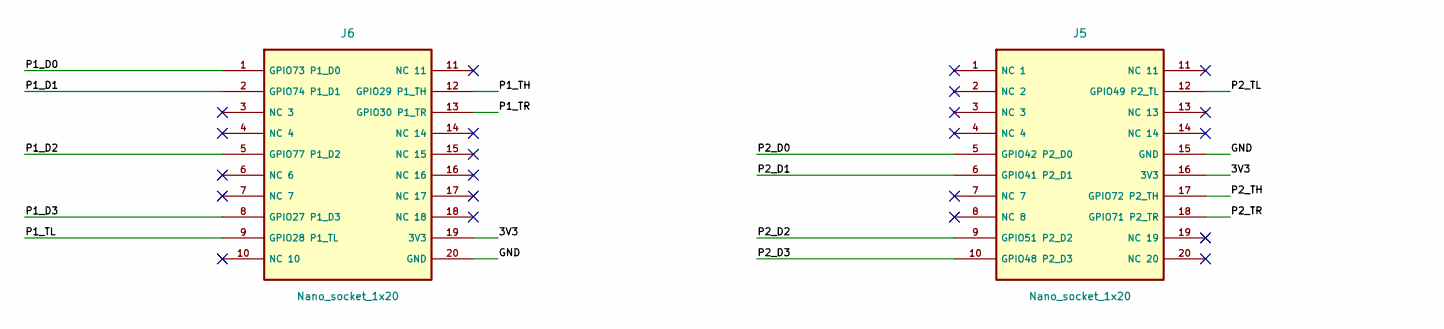
[picture p62: schematic dual-db9-opt-pcb.kicad_sch, dual-db9-opt-pcb O1 - 3.3V PROTOTYPE CARRIER, part in row 1, column 1]

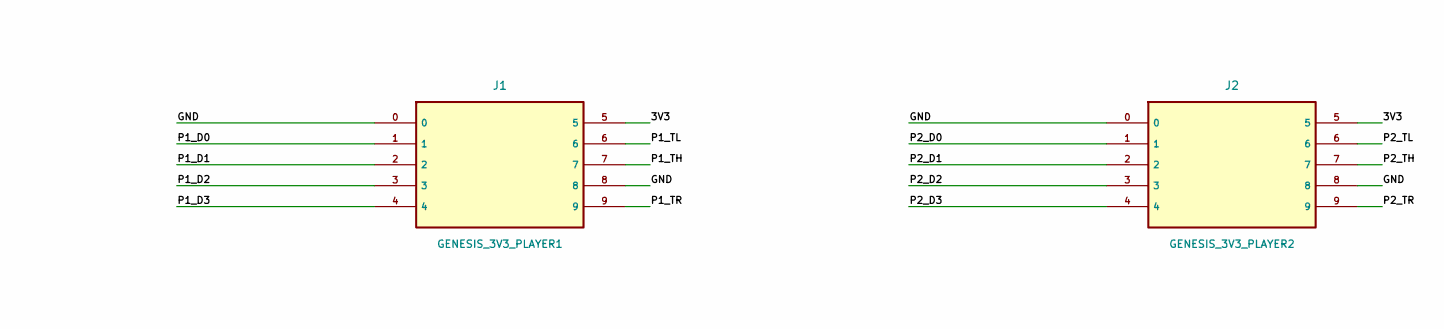
[picture p63: schematic dual-db9-opt-pcb.kicad_sch, dual-db9-opt-pcb O1 - 3.3V PROTOTYPE CARRIER, part in row 1, column 2]

Parts:
J1: GENESIS_3V3_PLAYER1; Kycon_K22X-E9P-N
J2: GENESIS_3V3_PLAYER2; Kycon_K22X-E9P-N
J5, J6: Nano_socket_1x20; Harwin_M20-7822046_1x20

Connections:
3V3: J1.5, J2.5, J5.16 (3V3), J6.19 (3V3)
GND: J1.0, J1.8, J2.0, J2.8, J5.15 (GND), J6.20 (GND)
P1_D0: J1.1, J6.1 (GPIO73 P1_D0)
P1_D1: J1.2, J6.2 (GPIO74 P1_D1)
P1_D2: J1.3, J6.5 (GPIO77 P1_D2)
P1_D3: J1.4, J6.8 (GPIO27 P1_D3)
P1_TH: J1.7, J6.12 (GPIO29 P1_TH)
P1_TL: J1.6, J6.9 (GPIO28 P1_TL)
P1_TR: J1.9, J6.13 (GPIO30 P1_TR)
P2_D0: J2.1, J5.5 (GPIO42 P2_D0)
P2_D1: J2.2, J5.6 (GPIO41 P2_D1)
P2_D2: J2.3, J5.9 (GPIO51 P2_D2)
P2_D3: J2.4, J5.10 (GPIO48 P2_D3)
P2_TH: J2.7, J5.17 (GPIO72 P2_TH)
P2_TL: J2.6, J5.12 (GPIO49 P2_TL)
P2_TR: J2.9, J5.18 (GPIO71 P2_TR)

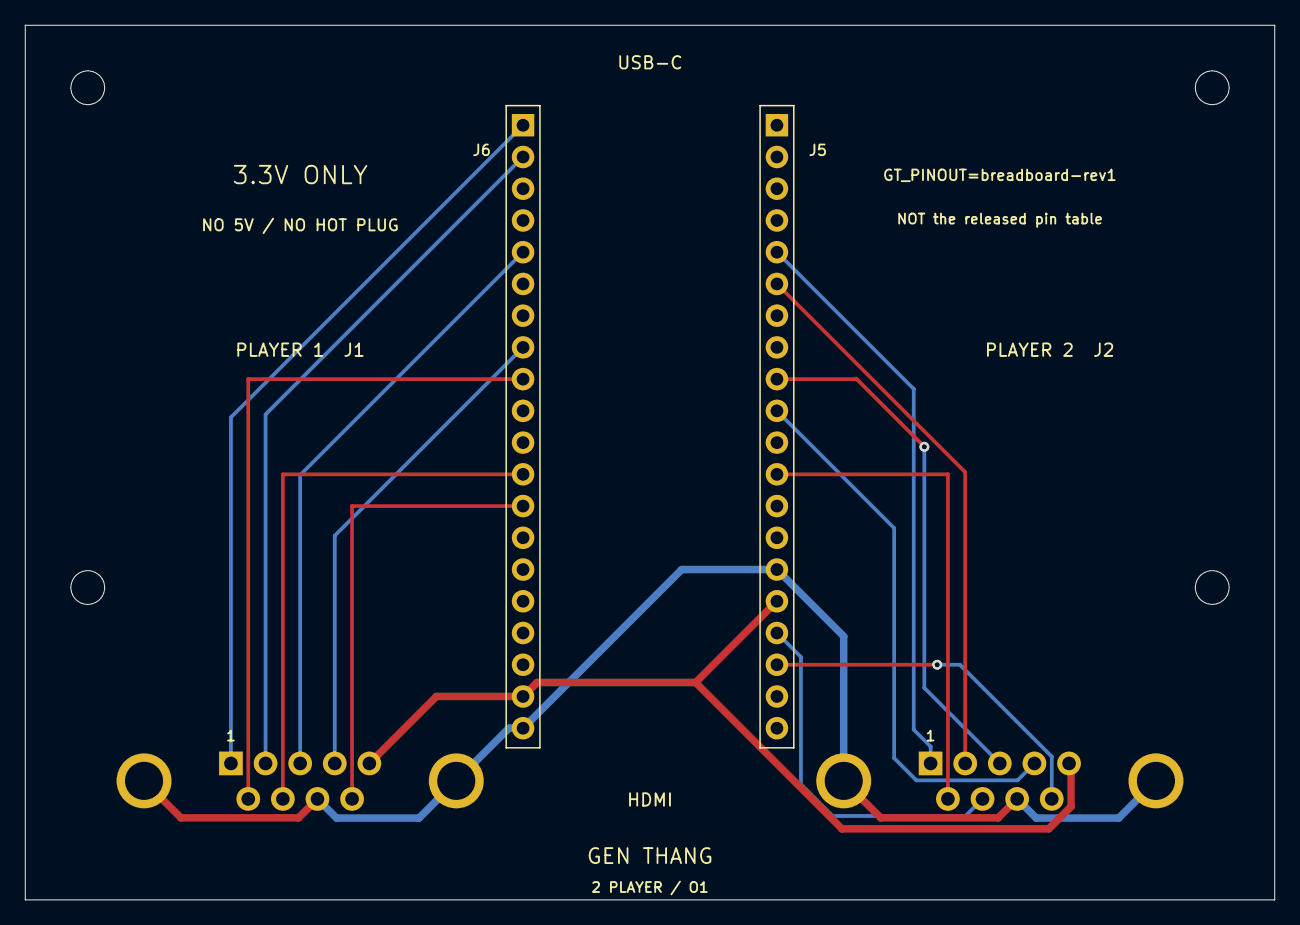
[picture p64: board dual-db9-opt-pcb.kicad_pcb from above]

Board: 2 copper layers, 100.0 x 70.0 mm, 8 parts (0 on the bottom side), 16 nets.

Other parts of the board:
H1, H2, H3, H4: M2.5_clearance; Mount_M2_5
