shawnchivers/genthang/src/system.sv

`include "pad_config.vh"   // build options (NO_SOUND)
// Copyright (c) 2010 Gregory Estrade (greg@torlus.com)
// Copyright (c) 2018 Sorgelig
//
// All rights reserved
//
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
// Redistributions in synthesized form must reproduce the above copyright
// notice, this list of conditions and the following disclaimer in the
// documentation and/or other materials provided with the distribution.
//
// Neither the name of the author nor the names of other contributors may
// be used to endorse or promote products derived from this software without
// specific prior written permission.
//
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
// Please report bugs to the author, but before you do so, please
// make sure that this is not a derivative work and that
// you have the latest version of this file.
//
//
// Changes for Tang boards by nand2mario, 10/2024
// 1. Added a separate clock for Z80 (CLK_Z80) that is half the speed of MCLK
//    due to lower Fmax of T80 on Tang.
// 2. Converted VHDL T80 to Verilog.
// 3. No SVP, EEPROM or GameGenie for now.
//
// Gen Thang: derived from Genesis_MiSTer (MiSTer-devel) by way of MDTang; this is
// not the upstream file. Gen Thang additions: shorter 68K ROM/RAM read path,
// posted work-RAM writes, SDRAM-backed cartridge SRAM and the save-state window.
//
// Tang Nano 20K build:
// 4. VDP VRAM is external (VRAM_* / VRAM32_* ports), served from SDRAM by the top level.
// 5. Two 3/6-button pads; no multitap/mouse/gun/serial/J-Cart.

module system #(
	parameter P2_SIX_BUTTON = 1,
	parameter P2_CONNECTED = 1
)
(
	input         RESET_N,
	input         SOFT_RESET,
	input         MCLK,			// 53.69Mhz
	input         CLK_Z80,		// 1/2 MCLK as Z80 core has low Fmax

	input   [1:0] LPF_MODE,		// low-pass filter mode: Model 1,Model 2,Minimal,No Filter
	input         ENABLE_FM,
	input         ENABLE_PSG,
	output [15:0] DAC_LDATA,
	output [15:0] DAC_RDATA,

	input         LOADING,
	input         PAL,
	input         EXPORT,
	input         FAST_FIFO,
	input         SRAM_QUIRK,
	input         SRAM00_QUIRK,
	input         EEPROM_QUIRK,
	input         NORAM_QUIRK,
	input         PIER_QUIRK,
	input         SVP_QUIRK, 
	input         FMBUSY_QUIRK,
	input         SCHAN_QUIRK,
	input         SRAM_REG,		// cartridge (or the locked-on one) declares backup RAM: $A130F1 maps SRAM over ROM

	input   [1:0] TURBO,		// Turbo mode: None,Medium,High

	input         GG_RESET,
	input         GG_EN,
	input [128:0] GG_CODE,
	output        GG_AVAILABLE,

	input  [14:0] BRAM_A,		// SRAM access interface
	input  [15:0] BRAM_DI,
	output [15:0] BRAM_DO,
	input         BRAM_WE,
	output        BRAM_CHANGE,

	output  [3:0] RED,
	output  [3:0] GREEN,
	output  [3:0] BLUE,
	output        VS,
	output        HS,
	output        HBL,
	output        VBL,
	output        CE_PIX,
	input         BORDER,
	input         CRAM_DOTS,

	output        INTERLACE,
	output        FIELD,
	output  [1:0] RESOLUTION,

	input         J3BUT,
	input  [11:0] JOY_1,		// {Z,Y,X,Mode,Start,C,B,A,Up,Down,Left,Right}, active high
	input  [11:0] JOY_2,
	input  [11:0] JOY_3,
	input  [11:0] JOY_4,
	input  [11:0] JOY_5,
	input   [2:0] MULTITAP,		// Disabled,4-Way,TeamPlayer: Port1,TeamPlayer: Port2,J-Cart

	input  [24:0] MOUSE,
	input   [2:0] MOUSE_OPT,
	
	input         GUN_OPT,
	input         GUN_TYPE,
	input         GUN_SENSOR,
	input         GUN_A,
	input         GUN_B,
	input         GUN_C,
	input         GUN_START,

	input   [7:0] SERJOYSTICK_IN,
	output  [7:0] SERJOYSTICK_OUT,
	input   [1:0] SER_OPT,

	input  [24:1] ROMSZ,
	output reg [24:1] MEM_ADDR,
	input  [15:0] MEM_DATA,
	output [15:0] MEM_WDATA,
	output reg    MEM_WE,		// only for Game no Kanzume Otokuyou
	output  [1:0] MEM_BE,
	output reg    MEM_REQ,
	input         MEM_ACK,

	// VDP VRAM, toggle req/ack handshakes (see vdp.v)
	output        VRAM_REQ,
	input         VRAM_ACK,
	output        VRAM_WE,
	output        VRAM_U_N,
	output        VRAM_L_N,
	output [15:1] VRAM_A,
	output [15:0] VRAM_D,
	input  [15:0] VRAM_Q,
	output        VRAM32_REQ,
	input         VRAM32_ACK,
	output [15:1] VRAM32_A,
	input  [31:0] VRAM32_Q,

	// output [24:1] MEM_ADDR2,
	// input  [15:0] MEM_DATA2,
	// output        MEM_REQ2,
	// input         MEM_ACK2, 
	
	input         EN_HIFI_PCM,
	input         LADDER,
	input         OBJ_LIMIT_HIGH,

	output		  TRANSP_DETECT,
	
	//debug
	input         PAUSE_EN,
	input         BGA_EN,
	input         BGB_EN,
	input         SPR_EN,
	output [23:0] DBG_M68K_A,
	output [23:0] DBG_VBUS_A,

	// save states (see firmware/savestate.S): [EN] maps the window at 0x400000 and the
	// state registers at 0x420000 and redirects the level 7 vector; [NMI] raises level 7;
	// [ZFREEZE] stops the Z80 at the next instruction boundary
	input         SS_EN,
	input         SS_NMI,
	input         SS_ZFREEZE
);

wire [23:1] M68K_A       /* xsynthesis syn_keep=1 */;
wire [15:0] M68K_DO      /* xsynthesis syn_keep=1 */;
wire        M68K_AS_N    /* xsynthesis syn_keep=1 */;
wire        M68K_UDS_N   /* xsynthesis syn_keep=1 */;
wire        M68K_LDS_N   /* xsynthesis syn_keep=1 */;
wire        M68K_RNW     /* xsynthesis syn_keep=1 */;
wire        M68K_BGACK_N /* xsynthesis syn_keep=1 */;
wire  [2:0] M68K_FC     ;
wire        M68K_BG_N   ;
wire        M68K_BR_N   ;

wire [23:0] M68K_A_FULL = {M68K_A, 1'b0};

wire        M68K_EXINT;
wire        M68K_HINT;
wire        M68K_VINT;
wire        Z80_VINT;

reg        M68K_MBUS_DTACK_N;
reg        Z80_MBUS_DTACK_N;
reg        VDP_MBUS_DTACK_N;

reg [15:0] M68K_MBUS_D;
reg  [7:0] Z80_MBUS_D;
reg [15:0] VDP_MBUS_D;

reg [23:1] MBUS_A;
reg [15:0] MBUS_DO;

wire [23:0] MBUS_A_FULL = {MBUS_A, 1'b0};

reg        MBUS_RNW;
reg        MBUS_UDS_N;
reg        MBUS_LDS_N;

reg [15:0] NO_DATA;

reg  [4:0] BANK_REG[0:7];
reg        BANK_ROM;
reg        BANK_SRAM;


reg soft_reset = 1'b0;
always @(posedge MCLK) begin
	if (~RESET_N) soft_reset <= 1'b0;
	else soft_reset <= SOFT_RESET;
end

wire reset, hard_reset;
assign reset = ~RESET_N | soft_reset;
assign hard_reset = ~RESET_N;

// reg reset;
// reg hard_reset;
// always @(posedge MCLK) if(M68K_CLKENn) begin
// 	reset <= ~RESET_N | LOADING;
// 	// hard_reset <= LOADING;
// 	hard_reset <= ~RESET_N | LOADING;
// end

//--------------------------------------------------------------
// CLOCK ENABLERS
//--------------------------------------------------------------
wire M68K_CLKEN = M68K_CLKENp;
reg  M68K_CLKENp, M68K_CLKENn;
reg  Z80_CLKENp, Z80_CLKENn, PSG_CLKEN;
reg  FM_CLKEN;
reg clk_z80_cycle;			// 0: CLK_Z80 is high (first half), 1: low (second half)
always @(posedge MCLK) if (CLK_Z80) clk_z80_cycle <= 1;
reg pause_reg;				// PAUSE_EN registered on whole m68k cycle

always @(posedge MCLK) begin
	reg [3:0] FCLKCNT;
	reg [3:0] VCLKCNT;
	reg [3:0] ZCLKCNT;
	reg [3:0] PCLKCNT;
	reg [3:0] VCLKMAX;
	reg [3:0] VCLKMID;

	if(~RESET_N /*| LOADING*/) begin
		VCLKCNT <= 0;
		PCLKCNT <= 0;
		FCLKCNT <= 0;
		Z80_CLKENp <= 1;
		Z80_CLKENn <= 1;
		PSG_CLKEN <= 1;
		M68K_CLKENp <= 1;
		M68K_CLKENn <= 1;
		pause_reg <= 0;
		VCLKMAX <= 6;
		VCLKMID <= 3;
	end
	else begin
		Z80_CLKENn <= 0;				
		ZCLKCNT <= ZCLKCNT + 1'b1;
		if (ZCLKCNT == 14)
			ZCLKCNT <= 0;
		if (clk_z80_cycle) 				// make sure Z80_CLKENn is 2 MCLK wide and aligned with CLK_Z80
			if (ZCLKCNT == 13 | ZCLKCNT == 14) 
				Z80_CLKENn <= 1; // ~PAUSE_EN;
			else
				Z80_CLKENn <= 0;
		
		Z80_CLKENp <= 0;
		if (ZCLKCNT == 7) begin
			Z80_CLKENp <= 1; // ~PAUSE_EN;
		end

		PSG_CLKEN <= 0;
		PCLKCNT <= PCLKCNT + 1'b1;
		if (PCLKCNT == 14) begin
			PCLKCNT <= 0;
			PSG_CLKEN <= 1; 	// ~PAUSE_EN;	// nand2mario: do not pause PSG for frame sync
		end

		M68K_CLKENp <= 0;
		VCLKCNT <= VCLKCNT + 1'b1;
		if (VCLKCNT == VCLKMAX) begin
			VCLKCNT <= 0;
			M68K_CLKENp <= ~PAUSE_EN;
			pause_reg <= PAUSE_EN;
			VCLKMAX <= (TURBO == 2) ? 4'd1 : (TURBO == 1) ? 4'd3 : 4'd6;
			VCLKMID <= (TURBO == 2) ? 4'd0 : (TURBO == 1) ? 4'd1 : 4'd3;
		end

		M68K_CLKENn <= 0;
		if (VCLKCNT == VCLKMID) begin
			M68K_CLKENn <= ~pause_reg;
		end

		FM_CLKEN <= 0;
		FCLKCNT <= FCLKCNT + 1'b1;
		if (FCLKCNT == 6) begin
			FCLKCNT <= 0;
			FM_CLKEN <= 1; // ~PAUSE_EN;		// nand2mario: do not pause FM for frame sync
		end
	end
end


//--------------------------------------------------------------
// CPU 68000
//--------------------------------------------------------------
reg   [2:0] M68K_IPL_N;
always @(posedge MCLK) begin
	reg       old_as;
	reg [1:0] scnt;
	
	if(reset) M68K_IPL_N <= 3'b111;
	else if (M68K_CLKEN) begin
		old_as <= M68K_AS_N;
		scnt <= scnt + 1'd1;
		if(~M68K_AS_N) scnt <= 0;
		if((~old_as & M68K_AS_N) || &scnt) begin
			if (SS_NMI) M68K_IPL_N <= 3'b000;
			else if (M68K_VINT) M68K_IPL_N <= 3'b001;
			else if (M68K_HINT) M68K_IPL_N <= 3'b011;
			else if (M68K_EXINT) M68K_IPL_N <= 3'b101;
			else M68K_IPL_N <= 3'b111;
		end
	end
end

wire M68K_INTACK = &M68K_FC;

assign M68K_BR_N = VBUS_BR_N & Z80_BR_N;
assign M68K_BGACK_N = VBUS_BGACK_N & Z80_BGACK_N;

fx68k M68K
(
	.clk(MCLK),
	.extReset(reset),
	.pwrUp(hard_reset),
	.enPhi1(M68K_CLKENp),
	.enPhi2(M68K_CLKENn),

	.eRWn(M68K_RNW),
	.ASn(M68K_AS_N),
	.UDSn(M68K_UDS_N),
	.LDSn(M68K_LDS_N),

	.FC0(M68K_FC[0]),
	.FC1(M68K_FC[1]),
	.FC2(M68K_FC[2]),

	.BGn(M68K_BG_N),
	.BRn(M68K_BR_N),
	.BGACKn(M68K_BGACK_N),
	.HALTn(1),

	.DTACKn(M68K_MBUS_DTACK_N),
	.VPAn(~M68K_INTACK),
	.BERRn(1),
	.IPL0n(M68K_IPL_N[0]),
	.IPL1n(M68K_IPL_N[1]),
	.IPL2n(M68K_IPL_N[2]),
	.iEdb(genie_data),
	.oEdb(M68K_DO),
	.eab(M68K_A)
);


assign DBG_M68K_A = {M68K_A,1'b0};
assign DBG_VBUS_A = {VBUS_A,1'b0};

//--------------------------------------------------------------
// CHEAT CODES
//--------------------------------------------------------------

wire [15:0] genie_data;
// nand2mario: skip game genie for now
assign genie_data = M68K_MBUS_D;

// CODES #(.ADDR_WIDTH(24), .DATA_WIDTH(16), .BIG_ENDIAN(1)) codes
// (
// 	.clk(MCLK),
// 	.reset(LOADING | GG_RESET),
// 	.enable(~GG_EN),
// 	.code(GG_CODE),
// 	.available(GG_AVAILABLE),
// 	.addr_in({M68K_A[23:1], 1'b0}),
// 	.data_in(M68K_MBUS_D),
// 	.data_out(genie_data)
// );


//--------------------------------------------------------------
// VDP + PSG
//--------------------------------------------------------------
reg         VDP_SEL;
wire [15:0] VDP_DO;
wire        VDP_DTACK_N;

wire [23:1] VBUS_A;
wire        VBUS_SEL;
wire        VBUS_BR_N;
wire        VBUS_BGACK_N;

wire        vram_req;
wire        vram_ack = VRAM_ACK;
wire        vram_we;
wire        vram_u_n;
wire        vram_l_n;
wire [15:1] vram_a;
wire [15:0] vram_d;

wire        vram32_req;
wire        vram32_ack = VRAM32_ACK;
wire [15:1] vram32_a;

assign VRAM_REQ   = vram_req;
assign VRAM_WE    = vram_we;
assign VRAM_U_N   = vram_u_n;
assign VRAM_L_N   = vram_l_n;
assign VRAM_A     = vram_a;
assign VRAM_D     = vram_d;
assign VRAM32_REQ = vram32_req;
assign VRAM32_A   = vram32_a;

wire VDP_hs, VDP_vs;
assign HS = ~VDP_hs;
assign VS = ~VDP_vs;

wire HL;

vdp #(
`ifdef GT_NO_ADAPTIVE
	.ADAPTIVE_BLEND(0)
`else
	.ADAPTIVE_BLEND(1)
`endif
) vdp
(
	.RST_N(~hard_reset),
	.CLK(MCLK),
	.CE(~pause_reg),

	.SEL(VDP_SEL),
	.A({MBUS_A[4:1], 1'b0}),
	.RNW(MBUS_RNW),
	.DI(MBUS_DO),
	.DO(VDP_DO),
	.DTACK_N(VDP_DTACK_N),

	.vram_req(vram_req),
	.vram_ack(vram_ack),
	.vram_we(vram_we),
	.vram_u_n(vram_u_n),
	.vram_l_n(vram_l_n),
	.vram_a(vram_a),
	.vram_d(vram_d),
	.vram_q(VRAM_Q),

	.vram32_req(vram32_req),
	.vram32_ack(vram32_ack),
	.vram32_a(vram32_a),
	.vram32_q(VRAM32_Q),
	
	.EXINT(M68K_EXINT),
	.HL(HL),
	
	.HINT(M68K_HINT),
	.VINT_TG68(M68K_VINT),
	.INTACK(M68K_INTACK),

	.VINT_T80(Z80_VINT),

	.VBUS_ADDR(VBUS_A),
	.VBUS_DATA(VDP_MBUS_D),
	.VBUS_SEL(VBUS_SEL),
	.VBUS_DTACK_N(VDP_MBUS_DTACK_N),

	.BG_N(M68K_BG_N),
	.BR_N(VBUS_BR_N),
	.BGACK_N(VBUS_BGACK_N),

	.VRAM_SPEED(~(FAST_FIFO|TURBO!=0)),
	.VSCROLL_BUG(1),		// 1: hardware-accurate left-column vscroll bug (0 is the "nicer" MiSTer option)
	.BORDER_EN(BORDER),
	.CRAM_DOTS(CRAM_DOTS),
	.SVP_QUIRK(SVP_QUIRK),
	.OBJ_LIMIT_HIGH_EN(OBJ_LIMIT_HIGH),

	.FIELD_OUT(FIELD),
	.INTERLACE(INTERLACE),
	.RESOLUTION(RESOLUTION),

	.PAL(PAL),
	.R(RED),
	.G(GREEN),
	.B(BLUE),
	.HS(VDP_hs),
	.VS(VDP_vs),
	.CE_PIX(CE_PIX),
	.HBL(HBL),
	.VBL(VBL),

	.TRANSP_DETECT(TRANSP_DETECT),
	
	.BGA_EN(BGA_EN),
	.BGB_EN(BGB_EN),
	.SPR_EN(SPR_EN),
	.dbg_in({2'b00, MBUS_A[7], MBUS_A[5:1]}),
	.dbg_out(VDP_DBG)
);

// PSG 0x10-0x17 in VDP space
wire signed [10:0] PSG_SND;
`ifndef NO_SOUND
jt89 psg
(
	.rst(reset),
	.clk(MCLK),
	.clk_en(PSG_CLKEN),

	.wr_n(MBUS_RNW | ~VDP_SEL | ~MBUS_A[4] | MBUS_A[3]),
	.din(MBUS_DO[15:8]),

	.sound(PSG_SND)
);
`else
assign PSG_SND = 11'sd0;
`endif

//--------------------------------------------------------------
// Gamepads
//--------------------------------------------------------------
reg         IO_SEL;
wire  [7:0] IO_DO;
wire        IO_DTACK_N;

reg         JCART_SEL;
wire [15:0] JCART_DO;
wire        JCART_DTACK_N;

gen_io_minimal #(.P2_SIX_BUTTON(P2_SIX_BUTTON), .P2_CONNECTED(P2_CONNECTED)) io
(
	.RESET(hard_reset),
	.CLK(MCLK),
	.CE(M68K_CLKEN),
	.J3BUT(J3BUT),
	.P1_UP(~JOY_1[3]),
	.P1_DOWN(~JOY_1[2]),
	.P1_LEFT(~JOY_1[1]),
	.P1_RIGHT(~JOY_1[0]),
	.P1_A(~JOY_1[4]),
	.P1_B(~JOY_1[5]),
	.P1_C(~JOY_1[6]),
	.P1_START(~JOY_1[7]),
	.P1_MODE(~JOY_1[8]),
	.P1_X(~JOY_1[9]),
	.P1_Y(~JOY_1[10]),
	.P1_Z(~JOY_1[11]),
	.P2_UP(~JOY_2[3]),
	.P2_DOWN(~JOY_2[2]),
	.P2_LEFT(~JOY_2[1]),
	.P2_RIGHT(~JOY_2[0]),
	.P2_A(~JOY_2[4]),
	.P2_B(~JOY_2[5]),
	.P2_C(~JOY_2[6]),
	.P2_START(~JOY_2[7]),
	.P2_MODE(~JOY_2[8]),
	.P2_X(~JOY_2[9]),
	.P2_Y(~JOY_2[10]),
	.P2_Z(~JOY_2[11]),
	.PAL(PAL),
	.EXPORT(EXPORT),
	.SEL(IO_SEL),
	.A(MBUS_A[4:1]),
	.RNW(MBUS_RNW),
	.DI(MBUS_DO[7:0]),
	.DO(IO_DO),
	.DTACK_N(IO_DTACK_N)
);

assign HL = 1'b1;
assign SERJOYSTICK_OUT = 8'hFF;
assign JCART_DO = 16'hFFFF;
assign JCART_DTACK_N = 1'b1;


//-----------------------------------------------------------------------
// ROM
//-----------------------------------------------------------------------

// assign MEM_ADDR = BANK_ROM ? {BANK_REG[MBUS_A[21:19]], MBUS_A[18:1]} : MBUS_A;
assign MEM_BE = ~{MBUS_UDS_N, MBUS_LDS_N};
assign MEM_WDATA = MBUS_DO;

//-----------------------------------------------------------------------
// 64KB SRAM / 128KB SVP DRAM
//-----------------------------------------------------------------------
// reg SRAM_SEL;
// reg [15:0] sram_addr;
// reg [7:0] sram_di;
// reg sram_wren;
// wire [7:0] sram_q_l, sram_q_u;
// assign sram_q = sram_addr[0] ? sram_q_u : sram_q_l;

// always_comb begin
// 	if (PIER_QUIRK) begin
// 		sram_addr = {4'b0000, m95_addr};
// 		sram_di = m95_di;
// 		sram_wren = m95_rnw;
// 	end else begin
// 		sram_addr = MBUS_A[16:1];
// 		sram_di = MBUS_DO[7:0];
// 		sram_wren = SRAM_SEL & ~MBUS_RNW;
// 	end
// end

// // nand2mario: dropping SVP, so SRAM is 64K instead of 128K, and use dpram instead of dpram_dif
// dpram #(15) sram_u
// (
// 	.clock(MCLK),
// 	.address_a(sram_addr[15:1]),
// 	.data_a(sram_di),
// 	.wren_a(sram_wren),
// 	.q_a(sram_q_u),

// 	.address_b(LOADING ? ram_rst_a : BRAM_A),
// 	// Initializes SRAM to 0x0 for Sonic 1 Remastered, all other games have SRAM initialized to 0xFF
// 	.data_b(LOADING ? (SRAM00_QUIRK ? 8'h00 : 'hFF) : BRAM_DI),
// 	.wren_b(BRAM_WE),
// 	.q_b(BRAM_DO[15:8])
// );

// dpram #(15) sram_l
// (
// 	.clock(MCLK),
// 	.address_a(sram_addr[15:1]),
// 	.data_a(sram_di),
// 	.wren_a(sram_wren),
// 	.q_a(sram_q_l),

// 	.address_b(LOADING ? ram_rst_a : BRAM_A),
// 	.data_b(LOADING ? (SRAM00_QUIRK ? 8'h00 : 'hFF) : BRAM_DI),
// 	.wren_b(BRAM_WE),
// 	.q_b(BRAM_DO[7:0])
// );

// dpram_dif #(17,8,16,16) sram
// (
// 	.clock(MCLK),
// 	.address_a(sram_addr),
// 	.data_a(sram_di),
// 	.wren_a(sram_wren & ~SVP_QUIRK),
// 	.q_a(sram_q),

// 	.address_b(LOADING ? ram_rst_a : SVP_QUIRK ? SVP_DRAM_A : BRAM_A),
// 	// Initializes SRAM to 0x0 for Sonic 1 Remastered, all other games have SRAM initialized to 0xFF
// 	.data_b(LOADING ? (SRAM00_QUIRK ? 16'h0000 : 16'hFFFF) : SVP_QUIRK ? SVP_DRAM_DO : BRAM_DI),
// 	.wren_b(LOADING | SVP_DRAM_WE | BRAM_WE),
// 	.q_b(BRAM_DO)
// );

// wire [7:0] sram_q;
// assign BRAM_CHANGE = sram_wren;

//-----------------------------------------------------------------------
// EEPROM Handling
//-----------------------------------------------------------------------
reg ep_si, m95_so, ep_sck, ep_hold, ep_cs;
wire [7:0] m95_di, m95_q;
wire [11:0] m95_addr;
wire m95_rnw;

// STM95XXX pier_eeprom
// (
// 	.clk(MCLK),
// 	.enable(PIER_QUIRK),
// 	.so(m95_so),
// 	.si(ep_si),
// 	.sck(ep_sck),
// 	.hold_n(ep_hold),
// 	.cs_n(ep_cs),
// 	.wp_n(1'b1),
// 	.ram_addr(m95_addr),
// 	.ram_q(sram_q),
// 	.ram_di(m95_di),
// 	.ram_RnW(m95_rnw)
// );

//-----------------------------------------------------------------------
// SVP
//-----------------------------------------------------------------------
reg         SVP_SEL;
wire [15:0] SVP_DO;
wire        SVP_DTACK_N;

wire [15:0] SVP_DRAM_A;
wire [15:0] SVP_DRAM_DO;
wire        SVP_DRAM_WE;
wire [15:0] SVP_DRAM_DI = BRAM_DO;

reg SVP_CLKEN;
// always @(posedge MCLK) SVP_CLKEN <= ~reset & ~SVP_CLKEN;

// SVP svp
// (
// 	.CLK(MCLK),
// 	.CE(SVP_CLKEN),
// 	.RST_N(~reset & SVP_QUIRK),
// 	.ENABLE(1),

// 	.BUS_A(MBUS_A[23:1]),
// 	.BUS_DO(SVP_DO),
// 	.BUS_DI(MBUS_DO),
// 	.BUS_SEL(SVP_SEL),
// 	.BUS_RNW(MBUS_RNW),
// 	.BUS_DTACK_N(SVP_DTACK_N),
// 	.DMA_ACTIVE(VBUS_SEL),

// 	.ROM_A(MEM_ADDR2),
// 	.ROM_DI(MEM_DATA2),
// 	.MEM_REQ(MEM_REQ2),
// 	.MEM_ACK(MEM_ACK2),

// 	.DRAM_A(SVP_DRAM_A),
// 	.DRAM_DI(SVP_DRAM_DI),
// 	.DRAM_DO(SVP_DRAM_DO),
// 	.DRAM_WE(SVP_DRAM_WE)
// );


//-----------------------------------------------------------------------
// 68K RAM
//-----------------------------------------------------------------------
// reg RAM_SEL;

// dpram #(15) ram68k_u
// (
// 	.clock(MCLK),
// 	.address_a(MBUS_A[15:1]),
// 	.data_a(MBUS_DO[15:8]),
// 	.wren_a(RAM_SEL & ~MBUS_RNW & ~MBUS_UDS_N),
// 	.q_a(ram68k_q[15:8]),

// 	.address_b(ram_rst_a[15:1]),
// 	.wren_b(LOADING)
// );

// dpram #(15) ram68k_l
// (
// 	.clock(MCLK),
// 	.address_a(MBUS_A[15:1]),
// 	.data_a(MBUS_DO[7:0]),
// 	.wren_a(RAM_SEL & ~MBUS_RNW & ~MBUS_LDS_N),
// 	.q_a(ram68k_q[7:0]),

// 	.address_b(ram_rst_a[15:1]),
// 	.wren_b(LOADING)
// );
// wire [15:0] ram68k_q;

//-----------------------------------------------------------------------
// Save state registers (68K 0x420000-0x43FFFF while SS_EN), word offsets:
//   0x000-0x01A  Z80 registers (T80 REG) / write: T80 DIR
//   0x020        status {frozen, HALT_n, game BUSREQ_n, game RESET_n, 3'b0, BAR}
//                write: {DIRSet, T80 reset}
//   0x040-0x07E  VDP registers 0-31, 0x080-0x086 VDP ADDR lo/hi, {PENDING, CODE}, ADDR[16]
//   0x400-0x7FE  YM2612 register shadow, port 0 then port 1
//-----------------------------------------------------------------------
wire  [7:0] VDP_DBG;
wire [211:0] Z80_REG;
wire        Z80_HALT_N;
reg [255:0] ss_dir;
reg   [1:0] ss_zctl;					// {DIRSet, T80 reset}
reg         ss_zfrozen;
reg   [7:0] ym_q;
wire [255:0] ss_zreg = {44'd0, Z80_REG};
wire [15:0] ss_status;
wire        SS_SEL = SS_EN && MBUS_A[23:18] == 6'b0100_00;

//-----------------------------------------------------------------------
// MBUS Handling
//-----------------------------------------------------------------------

reg  [4:0] mstate;
reg  [1:0] msrc;
	
localparam	MSRC_NONE = 0,
			MSRC_M68K = 1,
			MSRC_Z80  = 2,
			MSRC_VDP  = 3;

localparam 	MBUS_IDLE         = 0,
			MBUS_SELECT       = 1,
			MBUS_RAM_READ     = 2,
			MBUS_ROM_READ     = 3,
			MBUS_ROM_WRITE    = 4,
			MBUS_VDP_READ     = 5,
			MBUS_IO_READ      = 6,
			MBUS_JCRT_READ    = 7,
			MBUS_SRAM_READ    = 8,
			MBUS_ZBUS_PRE     = 9,
			MBUS_ZBUS_WS 	   = 10,
			MBUS_ZBUS_READ    = 11,
			MBUS_SVP_READ     = 12,
			MBUS_REFRESH      = 13,
			MBUS_FINISH       = 14,
			MBUS_Z80_PREREAD  = 15,
			MBUS_WAIT_FOR_S4  = 16,
			MBUS_SS_READ      = 17;

				
always @(posedge MCLK) begin
	reg [15:0] data;
	reg  [3:0] pier_count;
	reg [6:0] refresh_timer;
	reg rfs_pend;
	reg rfs_wait;
	reg vbus_bgack_r;
	reg [1:0] cycle_cnt;
	reg wr_posted;

	if (reset) begin
		M68K_MBUS_DTACK_N <= 1;
		Z80_MBUS_DTACK_N  <= 1;
		VDP_MBUS_DTACK_N  <= 1;
		wr_posted <= 0;
		refresh_timer <= 7'h7F;
		rfs_pend <= 0;
		rfs_wait <= 0;
		VDP_SEL <= 0;
		IO_SEL <= 0;
		SVP_SEL <= 0; 
		ZBUS_SEL <= 0;
		BANK_ROM <= 0;
		BANK_SRAM <= 0;
		mstate <= MBUS_IDLE;
		pier_count <= 0;
		MBUS_RNW <= 1;
		NO_DATA <= 'h4E71;
		BANK_REG <= '{0,1,2,3,4,5,6,7};
	end
	else begin
		if (M68K_CLKENp) begin
			if (cycle_cnt) cycle_cnt <= cycle_cnt - 1'd1;
		end

		if (M68K_AS_N) M68K_MBUS_DTACK_N <= 1;
		if (~Z80_IO)   Z80_MBUS_DTACK_N  <= 1;
		if (~VBUS_SEL) VDP_MBUS_DTACK_N  <= 1;
		if (~SS_EN)    ss_zctl <= 2'b00;

		case(mstate)
		MBUS_IDLE:
			begin
				CTRL_SEL <= 0;
				// SRAM_SEL <= 0;
				// RAM_SEL <= 0;
				MBUS_RNW <= 1;
				MBUS_UDS_N <= 1;
				MBUS_LDS_N <= 1;
				
				/*if (rfs_pend) begin
					rfs_pend <= 0;
					mstate <= MBUS_REFRESH;
				end
				else*/ if (!M68K_AS_N && M68K_MBUS_DTACK_N && !rfs_pend) begin		// refresh holds the 68K
					msrc <= MSRC_M68K;
					MBUS_A <= M68K_A[23:1];
					data <= NO_DATA;
					MBUS_DO <= M68K_DO;
					MBUS_RNW <= M68K_RNW;
					mstate <= M68K_RNW ? MBUS_SELECT : MBUS_WAIT_FOR_S4;
					// plain ROM / work RAM reads go to memory without the SELECT cycle
					if (M68K_RNW && &M68K_A[23:21]) begin
						MEM_REQ <= ~MEM_ACK;
						MEM_ADDR <= {9'b0_1000_0000, M68K_A[15:1]};
						MEM_WE <= 0;
						MBUS_UDS_N <= M68K_UDS_N;
						MBUS_LDS_N <= M68K_LDS_N;
						mstate <= MBUS_RAM_READ;
					end
					else if (M68K_RNW && M68K_A[23:20] < 'hA && M68K_A < ROMSZ && !(BANK_SRAM && M68K_A[23:21] == 1) &&
					         !PIER_QUIRK && !EEPROM_QUIRK && !SRAM_QUIRK && !SRAM00_QUIRK && !SVP_QUIRK) begin
						MEM_REQ <= ~MEM_ACK;
						MEM_ADDR <= (SS_EN && M68K_A[23:2] == 22'h1F) ? {8'b0_1000_010, 15'h1F, M68K_A[1]} :	// level 7 vector from the window
						            BANK_ROM ? {BANK_REG[M68K_A[21:19]], M68K_A[18:1]} : M68K_A;
						MEM_WE <= 0;
						mstate <= MBUS_ROM_READ;
					end
				end
				else if (VBUS_SEL && VDP_MBUS_DTACK_N) begin
					msrc <= MSRC_VDP;
					MBUS_A <= VBUS_A;
					data <= NO_DATA;
					MBUS_DO <= 0;
					mstate <=  MBUS_SELECT;
				end
				else if (Z80_IO && !Z80_ZBUS && Z80_MBUS_DTACK_N && !Z80_BGACK_N && Z80_BR_N) begin
					msrc <= MSRC_Z80;
					MBUS_A <= Z80_A[15] ? {BAR[23:15],Z80_A[14:1]} : {16'hC000, Z80_A[7:1]};
					data <= 16'hFFFF;
					MBUS_DO <= {Z80_DO,Z80_DO};
					MBUS_RNW <= Z80_WR_N;
					mstate <= MBUS_Z80_PREREAD;
					cycle_cnt <= 2'd1;
				end
			end
		
		MBUS_WAIT_FOR_S4:			// nand2mario: datasheet 5.8, "STATE 4: Entering the high clock
									// period of S4, UDS, LDS, and/or DS is asserted(during a write 
									// cycle) on the rising edge of the clock."
									// --> UDS/LDS is delayed one full clock cycle for writes
									//     So we wait a cycle here.
			if (M68K_CLKENp)
				mstate <= MBUS_SELECT;

		MBUS_Z80_PREREAD:
			begin
				if (cycle_cnt) begin
					mstate <= MBUS_SELECT;
					cycle_cnt <= 2'd1;
				end
			end

		MBUS_SELECT:
			begin
				//NO DEVICE (usually lockup on real HW)
				mstate <= MBUS_FINISH;

				if (MBUS_A[23:20]<'hA || (msrc == MSRC_Z80 && MBUS_A[23:20]<'hE && ROMSZ[24:20]>='hA)) begin
					//ROM: 000000-9FFFFF (A00000-DFFFFF)
					if (BANK_SRAM && MBUS_A[23:21] == 1) begin
						// 200000-3FFFFF SRAM overrides ROM when bank is selected
						// SRAM_SEL <= 1;
						MEM_REQ <= ~MEM_ACK;
						MEM_ADDR <= {8'b0_1000_001, MBUS_A[16:1]};
						MEM_WE <= ~MBUS_RNW;
						MBUS_UDS_N <= M68K_UDS_N;
						MBUS_LDS_N <= M68K_LDS_N;
						mstate <= MBUS_SRAM_READ;
					end
					else if (PIER_QUIRK && ({MBUS_A,1'b0} == 'h0015E6 || {MBUS_A,1'b0} == 'h0015E8)) begin
						if (pier_count < 'h6) begin
							pier_count <= pier_count + 1'h1;
							data <= MBUS_A[1] ? 16'h0 : 16'h0010;
						end else begin
							data <= MBUS_A[1] ? 16'h0001 : 16'h8010;
						end
					end
					else if (EEPROM_QUIRK && {MBUS_A,1'b0} == 'h200000) begin
						data <= 0;
						mstate <= MBUS_FINISH;
					end
					else if ((SRAM_QUIRK | SRAM00_QUIRK) && {MBUS_A,1'b0} == 'h200000) begin
						// SRAM_SEL <= 1;
						MEM_REQ <= ~MEM_ACK;
						MEM_ADDR <= {8'b0_1000_001, MBUS_A[16:1]};
						MEM_WE <= ~MBUS_RNW;
						MBUS_UDS_N <= M68K_UDS_N;
						MBUS_LDS_N <= M68K_LDS_N;
						mstate <= MBUS_SRAM_READ;
					end
					else if(SVP_QUIRK && MBUS_A[23:20] == 3) begin
						// 300000-37FFFF (+mirrors) SVP DRAM
						// 390000-39FFFF SVP DRAM cell arrange 1
						// 3A0000-3AFFFF SVP DRAM cell arrange 2
						SVP_SEL <= 1;
						mstate <= MBUS_SVP_READ;
					end 
					else if (SCHAN_QUIRK && ~MBUS_RNW && (MBUS_A < 'h400000)) begin
						mstate <= MBUS_ROM_WRITE;
					end
					else if (SS_SEL && !MBUS_A[17]) begin
						// 400000-41FFFF save state window (SDRAM)
						MEM_REQ <= ~MEM_ACK;
						MEM_ADDR <= {8'b0_1000_010, MBUS_A[16:1]};
						MEM_WE <= ~MBUS_RNW;
						MBUS_UDS_N <= M68K_UDS_N;
						MBUS_LDS_N <= M68K_LDS_N;
						mstate <= MBUS_SRAM_READ;
					end
					else if (SS_SEL) begin
						// 420000-43FFFF save state registers
						if (~MBUS_RNW) begin
							if (MBUS_A[10:5] == 0) ss_dir[MBUS_A[4:1]*16 +: 16] <= MBUS_DO;
							if (MBUS_A[10:1] == 10'h10) ss_zctl <= MBUS_DO[1:0];
						end else
							mstate <= MBUS_SS_READ;
					end
					else if (MBUS_A < ROMSZ) begin
						if (SVP_QUIRK && msrc == MSRC_VDP) MBUS_A <= MBUS_A - 1'd1;
						MEM_WE <= 0;
						MEM_REQ <= ~MEM_ACK;
						MEM_ADDR <= BANK_ROM ? {BANK_REG[MBUS_A[21:19]], MBUS_A[18:1]} : MBUS_A;
						mstate <= MBUS_ROM_READ;
					end
					else if ((MULTITAP == 4) && ({MBUS_A,1'b0} == 'h3FFFFE || {MBUS_A,1'b0} == 'h38FFFE)) begin
						JCART_SEL <= 1;
						mstate <= MBUS_JCRT_READ;
					end
					else if(MBUS_A[23:21] == 1 && ~&MBUS_A[20:19] && ~NORAM_QUIRK) begin
						// 200000-37FFFF
						// SRAM_SEL <= 1;
						MEM_REQ <= ~MEM_ACK;
						MEM_ADDR <= {8'b0_1000_001, MBUS_A[16:1]};
						MEM_WE <= ~MBUS_RNW;
						MBUS_UDS_N <= M68K_UDS_N;
						MBUS_LDS_N <= M68K_LDS_N;
						mstate <= MBUS_SRAM_READ;
					end
					else begin
						data <= 0;
						mstate <= MBUS_FINISH;
					end
				end

				//ZBUS: A00000-A07FFF (A08000-A0FFFF)
				else if(MBUS_A[23:16] == 'hA0) mstate <= (!Z80_BUSRQ_N || SS_EN) ? MBUS_ZBUS_PRE : MBUS_FINISH;

				//I/O: A10000-A1001F (+mirrors)
				else if(MBUS_A[23:5] == {16'hA100, 3'b000}) begin
					IO_SEL <= 1;
					mstate <= MBUS_IO_READ;
				end

				//CTL: A11100, A11200
				else if(MBUS_A[23:12] == 12'hA11 && !MBUS_A[7:1]) begin
					CTRL_SEL <= 1;
					data <= CTRL_DO;
					mstate <= MBUS_FINISH;
				end

				// BANK Register A13XXX
				else if (MBUS_A[23:8] == 'hA130) begin
					if (~MBUS_RNW) begin
						if (ROMSZ > 'h200000) begin // SSF2/Pier Solar ROM banking
							if (MBUS_A[3:1]) begin
								BANK_ROM <= 1;
								if (~PIER_QUIRK) begin // SSF2
									BANK_REG[MBUS_A[3:1]] <= MBUS_DO[4:0];
								end
								else if (MBUS_A[3:1] == 4) begin // Pier EEPROM
									{ep_cs, ep_hold , ep_sck, ep_si} <= MBUS_DO[3:0];
								end
								else if (~MBUS_A[3]) begin // Pier Banks
									BANK_REG[{1'b1,MBUS_A[2:1]}] <= MBUS_DO[3:0];
								end
							end
							else if (~PIER_QUIRK) begin // SRAM control only in the first register on SSF2 mapper
							   BANK_SRAM <= {MBUS_DO[0]};
							end
						end else if (SRAM_REG) begin
							// Without backup RAM the cartridge has no such register. Sonic & Knuckles
							// writes 1 here before jumping to the locked-on Sonic 2 code at $300000.
							BANK_SRAM <= {MBUS_DO[0]};
						end
					end else if (PIER_QUIRK && MBUS_A[3:1] == 'h5) begin
						data <= {15'h7FFF, m95_so};
					end
					mstate <= MBUS_FINISH;
				end
				
				//SVP: A15000-A5000F 
				else if(MBUS_A[23:4] == 20'hA1500) begin
					SVP_SEL <= 1;
					mstate <= MBUS_SVP_READ;
				end 

				//VDP: C00000-C0001F (+mirrors)
				else if(MBUS_A[23:21] == 3'b110 && !MBUS_A[18:16] && !MBUS_A[7:5]) begin
					VDP_SEL <= 1;
					mstate <= MBUS_VDP_READ;
				end

				//RAM: E00000-FFFFFF
				else if(&MBUS_A[23:21]) begin
					// RAM_SEL <= 1;
					MEM_REQ <= ~MEM_ACK;
					MEM_ADDR <= {9'b0_1000_0000, MBUS_A[15:1]};
					MEM_WE <= ~MBUS_RNW;
					MBUS_UDS_N <= M68K_UDS_N;
					MBUS_LDS_N <= M68K_LDS_N;
					mstate <= MBUS_RAM_READ;
				end
			end
			
		MBUS_ZBUS_PRE:
			case(msrc)
			MSRC_M68K:
				if(M68K_AS_N | (~M68K_UDS_N | ~M68K_LDS_N)) begin
					MBUS_UDS_N <= M68K_UDS_N;
					MBUS_LDS_N <= M68K_LDS_N;
					ZBUS_SEL <= 1;
					cycle_cnt <= 2'd1;
					mstate <= MBUS_RNW ? MBUS_ZBUS_WS : MBUS_ZBUS_READ;
				end

			MSRC_Z80:
				begin
					MBUS_UDS_N <= Z80_A[0];
					MBUS_LDS_N <= ~Z80_A[0];
					ZBUS_SEL <= 1;
					mstate <= MBUS_ZBUS_READ;
				end

			MSRC_VDP:
				begin
					MBUS_UDS_N <= 0;
					MBUS_LDS_N <= 0;
					ZBUS_SEL <= 1;
					mstate <= MBUS_ZBUS_READ;
				end
			endcase

		MBUS_ZBUS_WS:			// 68K reads of the Z80 area take one wait state (BlastEm io_read)
			begin
				if (M68K_CLKENp && !cycle_cnt) begin
					mstate <= MBUS_ZBUS_READ;
				end
			end
			
		MBUS_ZBUS_READ:
			begin
				if(~MBUS_ZBUS_DTACK_N) begin
					ZBUS_SEL <= 0;
					data <= {MBUS_ZBUS_D, MBUS_ZBUS_D};
					mstate <= MBUS_FINISH;
				end
			end

		MBUS_RAM_READ:
			if (MEM_REQ == MEM_ACK) begin
				data <= MEM_DATA; // ram68k_q;
				if(msrc == MSRC_M68K) begin
					NO_DATA <= MEM_DATA; // ram68k_q;
					M68K_MBUS_D <= MEM_DATA;
					if (~wr_posted) M68K_MBUS_DTACK_N <= 0;
				end
				wr_posted <= 0;
				mstate <= wr_posted ? MBUS_IDLE : MBUS_FINISH;
			end else if (msrc == MSRC_M68K && ~MBUS_RNW && ~wr_posted) begin
				// write data is latched: let the 68K go on while SDRAM finishes
				M68K_MBUS_DTACK_N <= 0;
				wr_posted <= 1;
			end

		MBUS_ROM_WRITE:
			case(msrc)
			MSRC_M68K:
				if(M68K_AS_N | (~M68K_UDS_N | ~M68K_LDS_N)) begin
					MBUS_UDS_N <= M68K_UDS_N;
					MBUS_LDS_N <= M68K_LDS_N;
					MEM_WE <= 1;
					MEM_REQ <= ~MEM_ACK;
					MEM_ADDR <= BANK_ROM ? {BANK_REG[MBUS_A[21:19]], MBUS_A[18:1]} : MBUS_A;
					mstate <= MBUS_ROM_READ;
				end

			MSRC_Z80:
				begin
					MBUS_UDS_N <= Z80_A[0];
					MBUS_LDS_N <= ~Z80_A[0];
					MEM_WE <= 1;
					MEM_REQ <= ~MEM_ACK;
					MEM_ADDR <= BANK_ROM ? {BANK_REG[MBUS_A[21:19]], MBUS_A[18:1]} : MBUS_A;
					mstate <= MBUS_ROM_READ;
				end
			endcase

		MBUS_ROM_READ:
			if (MEM_REQ == MEM_ACK) begin
				data <= MEM_DATA;
				if(msrc == MSRC_M68K) begin
					NO_DATA <= MEM_DATA;
					M68K_MBUS_D <= MEM_DATA;
					M68K_MBUS_DTACK_N <= 0;
				end
				if (msrc != MSRC_Z80 || !cycle_cnt)
					mstate <= MBUS_FINISH;
			end

		MBUS_SRAM_READ:
			if (MEM_REQ == MEM_ACK) begin
				data <= MEM_DATA; // {sram_q,sram_q};
				if(msrc == MSRC_M68K) begin
					NO_DATA <= MEM_DATA; // {sram_q,sram_q};
					M68K_MBUS_D <= MEM_DATA;
					M68K_MBUS_DTACK_N <= 0;
				end
				// SRAM_SEL <= 0;
				mstate <= MBUS_FINISH;
			end

		MBUS_VDP_READ:
			if (~VDP_DTACK_N) begin
				VDP_SEL <= 0;
				data <= VDP_DO;
				if(MBUS_A[4:2] == 1) data[15:10] <= NO_DATA[15:10]; //unused status bits
				else if(MBUS_A[4]) data <= NO_DATA; // PSG/debug registers
				// a 68K write completes as soon as the VDP accepts it (no extra wait state);
				// a full FIFO still stalls by delaying VDP_DTACK_N
				if (msrc == MSRC_M68K && ~MBUS_RNW) M68K_MBUS_DTACK_N <= 0;
				mstate <= MBUS_FINISH;
			end

		MBUS_IO_READ:
			if(~IO_DTACK_N) begin
				IO_SEL <= 0;
				data <= {IO_DO, IO_DO};
				mstate <= MBUS_FINISH;
			end

		MBUS_JCRT_READ:
			if(~JCART_DTACK_N) begin
				JCART_SEL <= 0;
				data <= JCART_DO & 16'h3F7F;
				mstate <= MBUS_FINISH;
			end

		MBUS_SVP_READ:
			if(~SVP_DTACK_N) begin
				SVP_SEL <= 0;
				data <= SVP_DO;
				mstate <= MBUS_FINISH;
			end 

		MBUS_REFRESH:
			if (M68K_CLKENp) begin
				rfs_wait <= rfs_wait + 1'd1;
				if (rfs_wait == 1) begin
					rfs_wait <= 0;
					mstate <= MBUS_IDLE;
				end
			end

		MBUS_SS_READ:
			begin
				data <= MBUS_A[10]    ? {8'h00, ym_q} :
				        MBUS_A[7:6] != 0 ? {8'h00, VDP_DBG} :
				        MBUS_A[5]     ? ss_status :
				                        ss_zreg[MBUS_A[4:1]*16 +: 16];
				mstate <= MBUS_FINISH;
			end

		MBUS_FINISH:
			begin
				case(msrc)
				MSRC_M68K:
					begin
						M68K_MBUS_D <= data;
						M68K_MBUS_DTACK_N <= 0;
						if((M68K_AS_N | MBUS_RNW | ~M68K_UDS_N | ~M68K_LDS_N)) begin
							MBUS_UDS_N <= M68K_UDS_N;
							MBUS_LDS_N <= M68K_LDS_N;
							mstate <= MBUS_IDLE;
						end
					end

				MSRC_Z80:
					begin
						if (Z80_CLKENp) begin
							Z80_MBUS_D <= Z80_A[0] ? data[7:0] : data[15:8];
							Z80_MBUS_DTACK_N <= 0;
							MBUS_UDS_N <= Z80_A[0];
							MBUS_LDS_N <= ~Z80_A[0];
							mstate <= MBUS_IDLE;
						end
					end

				MSRC_VDP:
					begin
						VDP_MBUS_D <= data;
						VDP_MBUS_DTACK_N <= 0;
						mstate <= MBUS_IDLE;
					end
				endcase
			end
		endcase

		// 68K DRAM refresh: every 128 CPU cycles the next 68K bus cycle waits 2 CPU cycles (BlastEm
		// REFRESH_INTERVAL/REFRESH_DELAY). A counter, not the old period-127 LFSR, whose extra 0.8% refreshes
		// made long CPU-bound loops drift lines behind BlastEm; like BlastEm, the end of a DMA restarts the
		// interval. The hold is counted here rather than in the bus state machine, because the device is full.
		// REGRESSION-SENSITIVE: the DMA-end restart below is a trade-off, not a settled model. Removing it
		// (d294e0f, reverted) fixed Aladdin scenes-6 but broke Alien 3 boot-7 (30 frames) and the SOR2
		// trash-can demo. Any change here needs those three plus a full campaign; see docs/known-issues.md.
		vbus_bgack_r <= VBUS_BGACK_N;
		if (VBUS_BGACK_N && !vbus_bgack_r) begin
			refresh_timer <= 7'd0;
			rfs_pend <= 0;
			rfs_wait <= 0;
		end
		else if (M68K_CLKENp) begin
			refresh_timer <= refresh_timer + 7'd1;
			if (&refresh_timer) begin
				rfs_pend <= 1;
			end
			else if (rfs_pend && mstate == MBUS_IDLE && !M68K_AS_N && M68K_MBUS_DTACK_N) begin
				rfs_wait <= ~rfs_wait;
				if (rfs_wait) rfs_pend <= 0;
			end
		end
	end
end


//--------------------------------------------------------------
// CPU Z80
//--------------------------------------------------------------
reg         Z80_RESET_N;
reg         Z80_BUSRQ_N = 1;
wire        Z80_BUSAK_N;
wire        Z80_MREQ_N;
wire        Z80_RD_N;
wire        Z80_WR_N;
wire [15:0] Z80_A;
wire  [7:0] Z80_DO;
wire        Z80_IO /* xsynthesis syn_keep=1 */ = ~Z80_MREQ_N & (~Z80_RD_N | ~Z80_WR_N);

// use our own T80 instead of the public tv80
`define USE_T80

`ifdef NO_SOUND
assign Z80_BUSAK_N = 1'b0;	// acknowledge immediately
assign Z80_MREQ_N = 1'b1;
assign Z80_RD_N = 1'b1;
assign Z80_WR_N = 1'b1;
assign Z80_A = 16'd0;
assign Z80_DO = 8'd0;
`else

`ifdef USE_T80

T80s #(.T2Write(1)) Z80
(
	.RESET_n(T80_RESET_N),
	.CLK(CLK_Z80),
	.CEN(Z80_CLKENn & ~ss_zfrozen),			// 1-CLK_Z80 or 2-MCLK wide
	.WAIT_n(~Z80_MBUS_DTACK_N | ~Z80_ZBUS_DTACK_N | ~Z80_IO),
	.INT_n(~Z80_VINT),
	.NMI_n('1),
	.BUSRQ_n(Z80_BUSRQ_N | (SS_ZFREEZE & ~ss_zfrozen)),	// a granted bus may stop mid-instruction
	.BUSAK_n(Z80_BUSAK_N),
	.HALT_n(Z80_HALT_N),
	.MREQ_n(Z80_MREQ_N),
	.RD_n(Z80_RD_N),
	.WR_n(Z80_WR_N),
	.OUT0(),
	.A(Z80_A),
	.DI((~Z80_MBUS_DTACK_N) ? Z80_MBUS_D : Z80_ZBUS_D),
	.DO(Z80_DO),
	.REG(Z80_REG),
	.DIRSet(ss_zctl[1]),
	.DIR(ss_dir[211:0]),
	.InstStart(z80_inst_start)
);

`else
tv80s #(.T2Write(1)) Z80
// T80s #(.T2Write(1)) Z80
//T80pa Z80
(
	.reset_n(Z80_RESET_N),
	.clk(MCLK),
//	.CEN_p(Z80_CLKENp),
//	.CEN_n(Z80_CLKENn),
	.cen(Z80_CLKENn),
	.wait_n(~Z80_MBUS_DTACK_N | ~Z80_ZBUS_DTACK_N | ~Z80_IO),
	.int_n(~Z80_VINT),
	.nmi_n('1),
	.busrq_n(Z80_BUSRQ_N),
	.busak_n(Z80_BUSAK_N),
	.mreq_n(Z80_MREQ_N),
	.rd_n(Z80_RD_N),
	.wr_n(Z80_WR_N),
	.A(Z80_A),
	.di((~Z80_MBUS_DTACK_N) ? Z80_MBUS_D : Z80_ZBUS_D),
	.dout(Z80_DO)
);
`endif

`endif

reg z80_reset_n, z80_busrq_n;
reg T80_RESET_N;
always @(posedge CLK_Z80) begin			// crossing from MCLK to CLK_Z80
	Z80_RESET_N <= z80_reset_n;
	Z80_BUSRQ_N <= z80_busrq_n;
	T80_RESET_N <= z80_reset_n & ~ss_zctl[0];
end

wire z80_inst_start;
always @(posedge MCLK) begin
	if (reset | ~SS_ZFREEZE) ss_zfrozen <= 0;
	else if (z80_inst_start | ~T80_RESET_N) ss_zfrozen <= 1;
end

wire        CTRL_F  = (MBUS_A[11:8] == 1) ? Z80_BUSAK_N : (MBUS_A[11:8] == 2) ? z80_reset_n : NO_DATA[8];
wire [15:0] CTRL_DO = {NO_DATA[15:9], CTRL_F, NO_DATA[7:0]};
reg         CTRL_SEL;
always @(posedge MCLK) begin
	if (reset) begin
		z80_busrq_n <= 1;
		z80_reset_n <= 0;
	end
	else if(CTRL_SEL & ~MBUS_RNW & ~MBUS_UDS_N) begin
		if (MBUS_A[11:8] == 1) z80_busrq_n <= ~MBUS_DO[8];
		if (MBUS_A[11:8] == 2) z80_reset_n <=  MBUS_DO[8];
	end
end

//-----------------------------------------------------------------------
// ZBUS Handling
//-----------------------------------------------------------------------
// Z80:   0000-7EFF
// 68000: A00000-A07FFF (A08000-A0FFFF)

wire       Z80_ZBUS  = ~Z80_A[15] && ~&Z80_A[14:8];

wire       ZBUS_NO_BUSY = ZBUS_A[14] && ~|ZBUS_A[13:2] && |ZBUS_A[1:0] && FMBUSY_QUIRK;

reg        ZBUS_SEL;
reg [14:0] ZBUS_A;
reg        ZBUS_WE;
reg  [7:0] ZBUS_DO;
wire [7:0] ZBUS_DI = ZRAM_SEL ? ZRAM_DO : (FM_SEL ? (ZBUS_NO_BUSY ? {1'b0, FM_DO[6:0]} : FM_DO) : 8'hFF);

reg  [7:0] MBUS_ZBUS_D;
reg  [7:0] Z80_ZBUS_D;

reg        MBUS_ZBUS_DTACK_N;
reg        Z80_ZBUS_DTACK_N;

reg        Z80_BR_N;
reg        Z80_BGACK_N;

wire       Z80_ZBUS_SEL = Z80_ZBUS & Z80_IO;
wire       ZBUS_FREE = (~Z80_BUSRQ_N & Z80_RESET_N) | SS_EN;

wire       Z80_MBUS_SEL = Z80_IO & ~Z80_ZBUS;

// RAM 0000-1FFF (2000-3FFF)
wire ZRAM_SEL = ~ZBUS_A[14];

wire  [7:0] ZRAM_DO;
dpram #(13) ramZ80
(
	.clock(MCLK),
	.address_a(ZBUS_A[12:0]),
	.data_a(ZBUS_DO),
	.wren_a(ZBUS_WE & ZRAM_SEL),
	.q_a(ZRAM_DO)
);

always @(posedge MCLK) begin
	reg [1:0] zstate;
	reg [1:0] zsrc;
	reg Z80_BGACK_DIS;

	localparam 	ZSRC_MBUS = 0,
				ZSRC_Z80  = 1;

	localparam	ZBUS_IDLE   = 0,
				ZBUS_READ   = 1,
				ZBUS_FINISH = 2;

	ZBUS_WE <= 0;
	
	if (reset) begin
		MBUS_ZBUS_DTACK_N <= 1;
		Z80_ZBUS_DTACK_N  <= 1;
		zstate <= ZBUS_IDLE;
		
		Z80_BR_N <= 1;
		Z80_BGACK_N <= 1;
		Z80_BGACK_DIS <= 0;
	end
	else begin
		if (~ZBUS_SEL)     					MBUS_ZBUS_DTACK_N <= 1;
		if (~Z80_ZBUS_SEL) 	Z80_ZBUS_DTACK_N  <= 1;

		case (zstate)
		ZBUS_IDLE:
			begin
				if (Z80_RD_N)      Z80_ZBUS_D <= 8'hFF;

				if (ZBUS_SEL & MBUS_ZBUS_DTACK_N) begin
					ZBUS_A <= {MBUS_A[14:1], MBUS_UDS_N};
					ZBUS_DO <= (~MBUS_UDS_N) ? MBUS_DO[15:8] : MBUS_DO[7:0];
					ZBUS_WE <= ~MBUS_RNW & ZBUS_FREE;
					zsrc <= ZSRC_MBUS;
					zstate <= ZBUS_READ;
				end
				else if (Z80_ZBUS_SEL & Z80_ZBUS_DTACK_N) begin
					ZBUS_A <= Z80_A[14:0];
					ZBUS_DO <= Z80_DO;
					ZBUS_WE <= ~Z80_WR_N;
					zsrc <= ZSRC_Z80;
					zstate <= ZBUS_READ;
				end
			end

		ZBUS_READ:
			zstate <= ZBUS_FINISH;

		ZBUS_FINISH:
			begin
				case(zsrc)
				ZSRC_MBUS:
					begin
						MBUS_ZBUS_D <= ZBUS_FREE ? ZBUS_DI : 8'hFF;
						MBUS_ZBUS_DTACK_N <= 0;
					end

				ZSRC_Z80: 
					begin
						Z80_ZBUS_D <= ZBUS_DI;
						Z80_ZBUS_DTACK_N <= 0;
					end
				endcase
				zstate <= ZBUS_IDLE;
			end
		endcase
		
		if (Z80_MBUS_SEL && Z80_BR_N && Z80_BGACK_N && VBUS_BR_N && VBUS_BGACK_N && M68K_CLKENp) begin
			Z80_BR_N <= 0;
		end
		else if (!Z80_BR_N && !M68K_BG_N && M68K_AS_N && M68K_CLKENn) begin
			Z80_BGACK_N <= 0;
		end
		else if (!Z80_BGACK_N && !Z80_BR_N && !M68K_BG_N && M68K_CLKENp) begin
			Z80_BR_N <= 1;
		end
		else if (!Z80_BGACK_DIS && !Z80_BGACK_N && Z80_BR_N && !Z80_MBUS_SEL && M68K_CLKENn) begin
			Z80_BGACK_DIS <= 1;
		end
		else if (!Z80_BGACK_N && Z80_BGACK_DIS && M68K_CLKENn) begin
			Z80_BGACK_N <= 1;
			Z80_BGACK_DIS <= 0;
		end
	end
end


//-----------------------------------------------------------------------
// Z80 BANK REGISTER
//-----------------------------------------------------------------------
// 6000-60FF

wire BANK_SEL = ZBUS_A[14:8] == 7'h60;
reg [23:15] BAR;

always @(posedge MCLK) begin
	if (reset) BAR <= 0;
	else if (BANK_SEL & ZBUS_WE) BAR <= {ZBUS_DO[0], BAR[23:16]};
end

assign ss_status = {ss_zfrozen, Z80_HALT_N, z80_busrq_n, z80_reset_n, 3'b000, BAR};

`ifdef SS_TRACE
reg [21:0] ss_trace_cnt;
always @(posedge MCLK) begin
	ss_trace_cnt <= ss_trace_cnt + 1'd1;
	if (ss_trace_cnt == 0)
		$display("z80 pc %04x sp %04x de %04x iff %b im %b rst %b t80rst %b busrq %b busak %b frz %b vint %b ss %b%b%b",
			Z80_REG[79:64], Z80_REG[63:48], Z80_REG[111:96], Z80_REG[211:210], Z80_REG[209:208],
			Z80_RESET_N, T80_RESET_N, Z80_BUSRQ_N, Z80_BUSAK_N, ss_zfrozen, Z80_VINT, SS_EN, SS_NMI, SS_ZFREEZE);
end
`endif


//--------------------------------------------------------------
// YM2612
//--------------------------------------------------------------
// 4000-4003 (4000-5FFF)

wire        FM_SEL = ZBUS_A[14:13] == 2'b10;
wire  [7:0] FM_DO;

// YM2612 registers are write-only: keep a copy of every write for save states. Cleared
// while the chip is in reset; pan bits (B4-B6 [7:6]) reset to 1, so they are stored inverted.
reg  [7:0] ym_shadow [0:511];
reg  [7:0] ym_areg0, ym_areg1;
reg  [8:0] ym_clr;
wire [7:0] ym_wreg = ZBUS_A[1] ? ym_areg1 : ym_areg0;
function [7:0] ym_pan_inv(input [7:0] r);
	ym_pan_inv = (r[7:2] == 6'b101101 && r[1:0] != 2'b11) ? 8'hC0 : 8'h00;
endfunction
always @(posedge MCLK) begin
	if (~Z80_RESET_N) begin
		ym_shadow[ym_clr] <= 8'h00;
		ym_clr <= ym_clr + 1'd1;
	end else if (FM_SEL & ZBUS_WE) begin
		if (~ZBUS_A[0]) begin
			if (ZBUS_A[1]) ym_areg1 <= ZBUS_DO;
			else           ym_areg0 <= ZBUS_DO;
		end else
			ym_shadow[{ZBUS_A[1], ym_wreg}] <= ZBUS_DO ^ ym_pan_inv(ym_wreg);
	end
	ym_q <= ym_shadow[MBUS_A[9:1]] ^ ym_pan_inv(MBUS_A[8:1]);
end
wire signed [15:0] FM_right;
wire signed [15:0] FM_left;
wire signed [15:0] FM_LPF_right;
wire signed [15:0] FM_LPF_left;
wire signed [15:0] PRE_LPF_L;
wire signed [15:0] PRE_LPF_R;

`ifndef NO_SOUND
jt12 fm
(
	.rst(~Z80_RESET_N),
	.clk(MCLK),
	.cen(FM_CLKEN),

	.cs_n(0),
	.addr(ZBUS_A[1:0]),
	.wr_n(~(FM_SEL & ZBUS_WE)),
	.din(ZBUS_DO),
	.dout(FM_DO),
	.en_hifi_pcm( EN_HIFI_PCM ),
`ifdef GT_LADDER
	.ladder(1'b1),
`else
	.ladder(LADDER),
`endif
	.snd_left(FM_left),
	.snd_right(FM_right)
);
`else
assign FM_DO = 8'h00;
assign FM_left = 16'sd0;
assign FM_right = 16'sd0;
`endif

wire signed [15:0] fm_adjust_l = (FM_left  << 4) + (FM_left  << 2) + (FM_left  << 1) + (FM_left  >>> 2);
wire signed [15:0] fm_adjust_r = (FM_right << 4) + (FM_right << 2) + (FM_right << 1) + (FM_right >>> 2);

`ifndef NO_SOUND
genesis_fm_lpf fm_lpf_l
(
	.clk(MCLK),
	.reset(reset),
	.in(fm_adjust_l),
	.out(FM_LPF_left)
);

genesis_fm_lpf fm_lpf_r
(
	.clk(MCLK),
	.reset(reset),
	.in(fm_adjust_r),
	.out(FM_LPF_right)
);
`endif

wire signed [15:0] fm_select_l = ((LPF_MODE == 2'b01) ? FM_LPF_left : fm_adjust_l);
wire signed [15:0] fm_select_r = ((LPF_MODE == 2'b01) ? FM_LPF_right : fm_adjust_r);

wire signed [10:0] psg_adjust = PSG_SND - (PSG_SND >>> 5);

`ifndef NO_SOUND
jt12_genmix genmix
(
	.rst(reset),
	.clk(MCLK),
	.fm_left(fm_select_l),
	.fm_right(fm_select_r),
	.psg_snd(psg_adjust),
	.fm_en(ENABLE_FM),
	.psg_en(ENABLE_PSG),
	.snd_left(PRE_LPF_L),
	.snd_right(PRE_LPF_R)
);

genesis_lpf lpf_right
(
	.clk(MCLK),
	.reset(reset),
	.lpf_mode(LPF_MODE[1:0]),
	.in(PRE_LPF_R),
	.out(DAC_RDATA)
);

genesis_lpf lpf_left
(
	.clk(MCLK),
	.reset(reset),
	.lpf_mode(LPF_MODE[1:0]),
	.in(PRE_LPF_L),
	.out(DAC_LDATA)
);
`else
assign DAC_LDATA = 16'd0;
assign DAC_RDATA = 16'd0;
`endif

endmodule
