shawnchivers/genthang/src/peripherals/gen_io.sv

// Copyright (c) 2010 Gregory Estrade (greg@torlus.com)
// Copyright (c) 2018 Sorgelig
//
// All rights reserved
//
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
// Redistributions in synthesized form must reproduce the above copyright
// notice, this list of conditions and the following disclaimer in the
// documentation and/or other materials provided with the distribution.
//
// Neither the name of the author nor the names of other contributors may
// be used to endorse or promote products derived from this software without
// specific prior written permission.
//
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
// Please report bugs to the author, but before you do so, please
// make sure that this is not a derivative work and that
// you have the latest version of this file.
//
// Gen Thang: derived from the Genesis_MiSTer I/O block (MiSTer-devel) by way of
// MDTang; this is not the upstream file. Modified for two pad ports, 3/6-button
// pads and the minimal Nano 20K build.

// gen-hw.txt from line 416
module gen_io
(
	input            RESET,
	input            CLK,
	input            CE,

	input            J3BUT,

	input            P1_UP,
	input            P1_DOWN,
	input            P1_LEFT,
	input            P1_RIGHT,
	input            P1_A,
	input            P1_B,
	input            P1_C,
	input            P1_START,
	input            P1_MODE,
	input            P1_X,
	input            P1_Y,
	input            P1_Z,

	input            P2_UP,
	input            P2_DOWN,
	input            P2_LEFT,
	input            P2_RIGHT,
	input            P2_A,
	input            P2_B,
	input            P2_C,
	input            P2_START,
	input            P2_MODE,
	input            P2_X,
	input            P2_Y,
	input            P2_Z,

	input            DISK,

	input     [24:0] MOUSE,
	input      [2:0] MOUSE_OPT,
	
	input            GUN_OPT,
	input            GUN_TYPE,
	input            GUN_SENSOR,
	input            GUN_A,
	input            GUN_B,
	input            GUN_C,
	input            GUN_START,

	input      [7:0] SERJOYSTICK_IN,
	output     [7:0] SERJOYSTICK_OUT,
	input      [1:0] SER_OPT,

	input            SEL,
	input      [4:1] A,
	input            RNW,
	input      [7:0] DI,
	output reg [7:0] DO,
	output reg       DTACK_N,
	output reg       HL,

	input            PAL,
	input            EXPORT
);

// https://segaretro.org/Sega_Mega_Drive/Control_pad_inputs
//
// $A10003, $A10005: Toggle TH bit; read control pad inputs.
// $A10009, $A1000B: Set TH and input bits to read or write. (0 = read; 1 = write)
//
// Reading control pad inputs typically consists of using $A10009/$A1000B to set TH to write and the other 
// bits to read. The full range of control pad inputs can then be read by repeatedly toggling the TH bit 
// through $A10003/$A10005. Every time the TH bit is switched between 0 and 1, the content of the other bits 
// changes. There are 8 possible states for the register, after which it returns to the start. The counter 
// also resets after 1.5ms, so that extra buttons aren't accidentally read by games that don't support them.

reg  [7:0] R[16];
wire [7:0] DATA = R[1];
wire [7:0] DATB = R[2];
wire [7:0] CTLA = R[4];
wire [7:0] CTLB = R[5];

always @(posedge RESET or posedge CLK) begin
	if(RESET) begin
		DTACK_N <= 1;
		DO <= 'hFF;
		R  <= '{0, 'h7F,'h7F,'h7F, 0,0,0, 'hFF,0,0, 'hFF,0,0, 'hFF,0,0};
	end
	else if(CE) begin
		if(~SEL) DTACK_N <= 1;
		else if(SEL & DTACK_N) begin
			if(~RNW) R[A] <= DI;
			else begin
				// Read
				case(A)
						0: DO <= {EXPORT, PAL, ~DISK, 5'd0};
						1: DO <= (CTLA & DATA) | (~CTLA & (SER_OPT[0] ? SERJOYSTICK_IN : (MOUSE_OPT[0] ? mdata : PAD1_DO)));
						2: DO <= (CTLB & DATB) | (~CTLB & (GUN_OPT ? GUN_DO : (SER_OPT[1] ? SERJOYSTICK_IN : (MOUSE_OPT[1] ? mdata : PAD2_DO))));
						3: DO <= R[3] | ~R[6]; // Unconnected port
				default: DO <= R[A];
				endcase
			end
			DTACK_N <= 0;
		end
	end
end

wire [7:0] PAD1_DO;
pad_io pad1
(
	.RESET(RESET),
	.CLK(CLK),
	.CE(CE),

	.J3BUT(J3BUT),

	.P_UP(P1_UP),
	.P_DOWN(P1_DOWN),
	.P_LEFT(P1_LEFT),
	.P_RIGHT(P1_RIGHT),
	.P_A(P1_A),
	.P_B(P1_B),
	.P_C(P1_C),
	.P_START(P1_START),
	.P_MODE(P1_MODE),
	.P_X(P1_X),
	.P_Y(P1_Y),
	.P_Z(P1_Z),

	.SEL(SEL && A == 1),
	.RNW(RNW),
	.DIR(~CTLA[6]),
	.DI(DI[6]),
	.DO(PAD1_DO)
);

wire [7:0] PAD2_DO;
pad_io pad2
(
	.RESET(RESET),
	.CLK(CLK),
	.CE(CE),

	.J3BUT(J3BUT),

	.P_UP(P2_UP),
	.P_DOWN(P2_DOWN),
	.P_LEFT(P2_LEFT),
	.P_RIGHT(P2_RIGHT),
	.P_A(P2_A),
	.P_B(P2_B),
	.P_C(P2_C),
	.P_START(P2_START),
	.P_MODE(P2_MODE),
	.P_X(P2_X),
	.P_Y(P2_Y),
	.P_Z(P2_Z),

	.SEL(SEL && A == 2),
	.RNW(RNW),
	.DIR(~CTLB[6]),
	.DI(DI[6]),
	.DO(PAD2_DO)
);

wire [7:0] GUN_DO;
gun_io gun
(
	.RESET(RESET),
	.CLK(CLK),
	.CE(CE),

	.GUN_TYPE(GUN_TYPE),
	.SENSOR(GUN_SENSOR),
	.P_A(GUN_A),
	.P_B(GUN_B),
	.P_C(GUN_C),
	.P_START(GUN_START),

	.DI((CTLB & DATB) | ~CTLB),
	.DO(GUN_DO)
);

reg   [8:0] dx,dy;
reg   [4:0] mdata;
reg  [10:0] curdx,curdy;
wire [10:0] newdx = curdx + {{3{MOUSE[4]}},MOUSE[15:8]};
wire [10:0] newdy = MOUSE_OPT[2] ? (curdy - {{3{MOUSE[5]}},MOUSE[23:16]}) : (curdy + {{3{MOUSE[5]}},MOUSE[23:16]});

wire TRA = DATA[5] & CTLA[5];
wire TRB = DATB[5] & CTLB[5];

wire MTH = (MOUSE_OPT[0] & PAD1_DO[6]) | (MOUSE_OPT[1] & PAD2_DO[6]);
wire MTR = (MOUSE_OPT[0] & TRA) | (MOUSE_OPT[1] & TRB);
wire [3:0] BTN = MOUSE_OPT[0] ? ~{P1_START,P1_C,P1_B,P1_A} : ~{P2_START,P2_C,P2_B,P2_A};

assign SERJOYSTICK_OUT = SER_OPT[0] ? (~CTLA | DATA) : (~CTLB | DATB);
always @(posedge CLK) begin
	reg old_stb;
	reg mtrd,mtrd2;
	reg [3:0] cnt;
	reg [5:0] delay;
	
	if (GUN_OPT & CTLB[7] & ~CTLB[6]) begin
		HL <= GUN_DO[6];
	end
	else if (SER_OPT[1] & CTLB[7] & ~CTLB[6]) begin
		HL <= SERJOYSTICK_IN[6];
	end		
	else begin
		HL <= 1'b1;
	end
	
	if(delay == 0) begin
		if(mtrd ^ MTR) delay <= 1;
	end
	else if(CE) begin
		if(&delay) mtrd <= MTR;
		delay <= delay + 1'd1;
	end

	mtrd2 <= mtrd;
	if(mtrd2 ^ mtrd) begin
		if(~&cnt) cnt <= cnt + 1'd1;
		if(cnt == 0) begin
			dx <= curdx[8:0];
			dy <= curdy[8:0];
			curdx <= 0;
			curdy <= 0;
		end
	end
	else begin
		old_stb <= MOUSE[24];
		if(old_stb != MOUSE[24]) begin
			if($signed(newdx) > $signed(10'd255)) curdx <= 10'd255;
			else if($signed(newdx) < $signed(-10'd255)) curdx <= -10'd255;
			else curdx <= newdx;

			if($signed(newdy) > $signed(10'd255)) curdy <= 10'd255;
			else if($signed(newdy) < $signed(-10'd255)) curdy <= -10'd255;
			else curdy <= newdy;
		end;
	end
	
	case(cnt)
			0: mdata <= 4'b1011;
			1: mdata <= 4'b1111;
			2: mdata <= 4'b1111;
			3: mdata <= {dy[8],dx[8]};
			4: mdata <= MOUSE[2:0] | BTN;
			5: mdata <= dx[7:4];
			6: mdata <= dx[3:0];
			7: mdata <= dy[7:4];
	default: mdata <= dy[3:0];
	endcase

	if(MTH) begin
		mdata <= 0;
		cnt <= 0;
	end

	mdata[4] <= mtrd2;
end

endmodule

module gen_io_minimal #(
	parameter P2_SIX_BUTTON = 1,
	parameter P2_CONNECTED = 1	// 0: port 2 reads as an empty port (pull-ups)
)
(
	input            RESET,
	input            CLK,
	input            CE,
	input            J3BUT,
	input            P1_UP,
	input            P1_DOWN,
	input            P1_LEFT,
	input            P1_RIGHT,
	input            P1_A,
	input            P1_B,
	input            P1_C,
	input            P1_START,
	input            P1_MODE,
	input            P1_X,
	input            P1_Y,
	input            P1_Z,
	input            P2_UP,
	input            P2_DOWN,
	input            P2_LEFT,
	input            P2_RIGHT,
	input            P2_A,
	input            P2_B,
	input            P2_C,
	input            P2_START,
	input            P2_MODE,
	input            P2_X,
	input            P2_Y,
	input            P2_Z,
	input            PAL,
	input            EXPORT,
	input            SEL,
	input      [4:1] A,
	input            RNW,
	input      [7:0] DI,
	output reg [7:0] DO,
	output reg       DTACK_N
);

reg [7:0] data_reg_a, data_reg_b;
reg [7:0] control_reg_a, control_reg_b;
wire [7:0] pad_a_do, pad_b_do;

always @(posedge RESET or posedge CLK) begin
	if (RESET) begin
		DTACK_N <= 1'b1;
		DO <= 8'hFF;
		data_reg_a <= 8'h7F;
		data_reg_b <= 8'h7F;
		control_reg_a <= 8'h00;
		control_reg_b <= 8'h00;
	end
	else if (CE) begin
		if (~SEL)
			DTACK_N <= 1'b1;
		else if (DTACK_N) begin
			if (~RNW) begin
				if (A == 1) data_reg_a <= DI;
				if (A == 2) data_reg_b <= DI;
				if (A == 4) control_reg_a <= DI;
				if (A == 5) control_reg_b <= DI;
			end
			else begin
				case (A)
					0: DO <= {EXPORT, PAL, 1'b1, 5'd0};
					1: DO <= (control_reg_a & data_reg_a) | (~control_reg_a & pad_a_do);
					2: DO <= (control_reg_b & data_reg_b) | (~control_reg_b & (P2_CONNECTED ? pad_b_do : 8'h7F));
					3: DO <= 8'h7F;
					4: DO <= control_reg_a;
					5: DO <= control_reg_b;
					default: DO <= 8'h00;
				endcase
			end
			DTACK_N <= 1'b0;
		end
	end
end

pad_io pad1
(
	.RESET(RESET),
	.CLK(CLK),
	.CE(CE),
	.J3BUT(J3BUT),
	.P_UP(P1_UP),
	.P_DOWN(P1_DOWN),
	.P_LEFT(P1_LEFT),
	.P_RIGHT(P1_RIGHT),
	.P_A(P1_A),
	.P_B(P1_B),
	.P_C(P1_C),
	.P_START(P1_START),
	.P_MODE(P1_MODE),
	.P_X(P1_X),
	.P_Y(P1_Y),
	.P_Z(P1_Z),
	.SEL(SEL && A == 1),
	.RNW(RNW),
	.DIR(~control_reg_a[6]),
	.DI(DI[6]),
	.DO(pad_a_do),
	.DTACK_N()
);

generate if (P2_SIX_BUTTON) begin : g_p2_six
pad_io pad2
(
	.RESET(RESET),
	.CLK(CLK),
	.CE(CE),
	.J3BUT(J3BUT),
	.P_UP(P2_UP),
	.P_DOWN(P2_DOWN),
	.P_LEFT(P2_LEFT),
	.P_RIGHT(P2_RIGHT),
	.P_A(P2_A),
	.P_B(P2_B),
	.P_C(P2_C),
	.P_START(P2_START),
	.P_MODE(P2_MODE),
	.P_X(P2_X),
	.P_Y(P2_Y),
	.P_Z(P2_Z),
	.SEL(SEL && A == 2),
	.RNW(RNW),
	.DIR(~control_reg_b[6]),
	.DI(DI[6]),
	.DO(pad_b_do),
	.DTACK_N()
);
end else begin : g_p2_three
pad_io_3button pad2
(
	.RESET(RESET), .CLK(CLK), .CE(CE),
	.P_UP(P2_UP), .P_DOWN(P2_DOWN), .P_LEFT(P2_LEFT), .P_RIGHT(P2_RIGHT),
	.P_A(P2_A), .P_B(P2_B), .P_C(P2_C), .P_START(P2_START),
	.SEL(SEL && A == 2), .RNW(RNW), .DIR(~control_reg_b[6]), .DI(DI[6]),
	.DO(pad_b_do), .DTACK_N()
);
end endgenerate

endmodule

module pad_io_3button
(
	input            RESET,
	input            CLK,
	input            CE,
	input            P_UP,
	input            P_DOWN,
	input            P_LEFT,
	input            P_RIGHT,
	input            P_A,
	input            P_B,
	input            P_C,
	input            P_START,
	input            SEL,
	input            RNW,
	input            DIR,
	input            DI,
	output reg [7:0] DO,
	output reg       DTACK_N
);

reg th;
reg di;

always @(*) begin
	DO[7:6] = {1'b0, th};
	DO[5:0] = th ? {P_C, P_B, P_RIGHT, P_LEFT, P_DOWN, P_UP}
	              : {P_START, P_A, 2'b00, P_DOWN, P_UP};
end

// TH follows the last value written to the data port while it is an output
always @(posedge RESET or posedge CLK) begin
	if (RESET) begin
		th <= 1'b1;
		di <= 1'b1;
		DTACK_N <= 1'b1;
	end
	else if (CE) begin
		if (~DIR)
			th <= di;

		if (~SEL)
			DTACK_N <= 1'b1;
		else if (DTACK_N) begin
			if (~RNW)
				di <= DI;
			DTACK_N <= 1'b0;
		end
	end
end

endmodule

module pad_io
(
   input RESET,
   input CLK,
   input CE,
   
   input J3BUT,
   
   input P_UP,
   input P_DOWN,
   input P_LEFT,
   input P_RIGHT,
   input P_A,
   input P_B,
   input P_C,
   input P_START,
   input P_MODE,
   input P_X,
   input P_Y,
   input P_Z,

   input SEL,
   input RNW,

   input DIR,
   input DI,

   output reg [7:0] DO,
   output reg       DTACK_N
);

reg TH;
reg [2:0] JCNT;

always @(*) begin
	DO[7:6] = {1'b0,TH};
	if(TH && JCNT == 3)        DO[5:0] = {P_C,P_B,P_MODE,P_X,P_Y,P_Z};
	else if(TH)                DO[5:0] = {P_C,P_B,P_RIGHT,P_LEFT,P_DOWN,P_UP};
	else if (JCNT < 2)         DO[5:0] = {P_START,P_A,2'b00,P_DOWN,P_UP};
	else if (JCNT == 2)        DO[5:0] = {P_START,P_A,4'b0000};
	else if (JCNT == 3)        DO[5:0] = {P_START,P_A,4'b1111};
	else                       DO[5:0] = {P_START,P_A,2'b00,P_DOWN,P_UP};
end

always @(posedge RESET or posedge CLK) begin
	reg [16:0] JTMR;
	reg  [7:0] FLTMR;

	reg THd;
	reg di;

	if(RESET) begin
		DTACK_N <= 1;
		TH   <= 1;
		JCNT <= 0;
		JTMR <= 0;
		FLTMR <= 0;
		THd <= 1;
		di <= 1;
	end
	else if(CE) begin
	
		if(~&FLTMR) FLTMR <= FLTMR + 1'd1;
		if(~DIR) begin
			TH <= di;
			FLTMR <= 0;
		end
		else if(FLTMR == 210) TH <= 1;
	
		THd <= TH;
		if(JTMR > 11600 || J3BUT) JCNT <= 0;
		if(~THd & TH && JCNT < 4) JCNT <= JCNT + 1'd1;

		if(~&JTMR) JTMR <= JTMR + 1'd1;
		if(THd & ~TH) JTMR <= 0;

		if(~SEL) DTACK_N <= 1;
		else if(SEL & DTACK_N) begin
			if(~RNW) di <= DI;
			DTACK_N <= 0;
		end 
	end
end

endmodule

module gun_io
(
	input RESET,
	input CLK,
	input CE,

	input GUN_TYPE,
	input SENSOR,
	input P_A,
	input P_B,
	input P_C,
	input P_START,

	input [7:0] DI,
	output reg [7:0] DO
);

reg [5:0] mdo; // Menacer
reg [5:0] jdo; // Justifier
reg th;
reg jth;
reg mth;

always @(*) begin
	DO[7:6] = {1'b0, th & (GUN_TYPE ? jth : mth)};
	DO[5:0] = GUN_TYPE ? jdo : mdo;
end

always @(posedge RESET or posedge CLK) begin
	reg jgunsel; // Justifier blue gun or pink gun.
	reg jgunen;  // Justifier gun enabled.
	reg mrsten;  // Menacer RST signal level

	if(RESET) begin
		jth  <= 1;
		mth  <= 1;
	end
	else if(CE) begin
		th <= DI[6];

		// Menacer
		mrsten <= DI[5];
		if(mrsten & ~DI[5] & ~DI[4]) mth <= 1'b1;
		if(SENSOR) mth <= 1'b0;
		mdo <= {2'b00, P_START, P_C, P_A, P_B};

		// Justifier
		jgunsel <= DI[5];
		jgunen <= DI[4];
		jdo[5:3] <= {jgunsel, jgunen, 1'b0};
		if(~jgunen) begin
			if(~jgunsel) begin
				// Blue gun
				jdo[2:0] <= {!SENSOR & th, !P_START,!P_A};
				if(SENSOR) jth <= 1'b0;
			end
			else begin
				// Pink gun (2nd player not supported yet)
				jdo[2:0] <= {th, 2'b11};
			end
		end
		else begin
			jdo[2:0] <= th ? 3'b000 : 3'b011;
			jth <= 1;
		end
	end
end

endmodule
