shawnchivers/genthang/firmware/spi_sd.c

// Based on spi_sd.c from FemtoRV (LIBFEMTORV32) by Bruno Levy, BSD-3-Clause:
// https://github.com/BrunoLevy/learn-fpga/blob/master/FemtoRV/FIRMWARE/LIBFEMTORV32/spi_sd.c
//
// Adapted by way of SNESTang / MDTang (nand2mario) and modified for Gen Thang:
// - Use byte-based PIO instead of bit-banging
// - Simplified initialization process

#include "picorv32.h"

// How to use MMC/SDC: http://elm-chan.org/docs/mmc/mmc_e.html
// SD over SPI: https://onlinedocs.microchip.com/pr/GUID-F9FE1ABC-D4DD-4988-87CE-2AFD74DEA334-en-US-3/index.html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
// http://www.dejazzer.com/ee379/lecture_notes/lec12_sd_card.pdf
// https://electronics.stackexchange.com/questions/77417/what-is-the-correct-command-sequence-for-microsd-card-initialization-in-spi
// send and receive a byte over SPI to sd card
uint8_t spi_send(uint8_t x) {
	reg_spimaster_byte = x;			// send
	return reg_spimaster_byte;		// receive
}

uint32_t spi_send_word(uint32_t x) {
    reg_spimaster_word = x;
    return reg_spimaster_word;
}

uint8_t spi_receive() {
    return spi_send(0xff);
}

uint32_t spi_receive_word() {
    return spi_send_word(0xFFFFFFFF);
}

uint8_t spi_sendrecv(uint8_t x) {
    spi_send(x);
    return spi_receive();
}

void spi_readblock(uint8_t *ptr, int length) {
    int i = 0;
    if ((((uint32_t)ptr) & 3) == 0) {   // aligned on word boundaries
        // transfer in 4-byte words. this is about twice as fast
        for (; i+4<=length; i+=4) {
            *(uint32_t *)ptr = spi_receive_word();
            ptr+=4;
        }
    }
    for (; i<length; i++) {
        *ptr++ = spi_receive();
    }
}

void spi_writeblock(const uint8_t *ptr, int length) {
    int i = 0;
    if ((((uint32_t)ptr) & 3) == 0) {   // aligned on word boundaries
        for (; i+4<=length; i+=4) {
            spi_send_word(*(uint32_t *)ptr);
            ptr += 4;
        }
    }
    for (; i<length; i++) {
        spi_send(*ptr++);
    }
}

#define CMD0_GO_IDLE_STATE              0
#define CMD1_SEND_OP_COND               1
#define CMD8_SEND_IF_COND               8
#define CMD17_READ_SINGLE_BLOCK         17
#define CMD24_WRITE_SINGLE_BLOCK        24
#define CMD32_ERASE_WR_BLK_START        32
#define CMD33_ERASE_WR_BLK_END          33
#define CMD38_ERASE                     38
#define ACMD41_SD_SEND_OP_COND          41
#define CMD55_APP_CMD                   55
#define CMD58_READ_OCR                  58

#define CMD_START_BITS                  0x40
#define CMD0_CRC                        0x95
#define CMD8_CRC                        0x87

#define OCR_SHDC_FLAG                   0x40
#define CMD_OK                          0x01

#define CMD8_3V3_MODE_ARG               0x1AA

#define ACMD41_HOST_SUPPORTS_SDHC       0x40000000

#define CMD_START_OF_BLOCK              0xFE
#define CMD_DATA_ACCEPTED               0x05

static int sdhc_card = 0;

uint8_t sd_send_command(uint8_t cmd, uint32_t arg) {
    uint8_t response = 0xFF;
    uint8_t status;

    // If non-SDHC card, use byte addressing rather than block (512) addressing
    if(!sdhc_card) {
        switch (cmd) {
            case CMD17_READ_SINGLE_BLOCK:
            case CMD24_WRITE_SINGLE_BLOCK:
            case CMD32_ERASE_WR_BLK_START:
            case CMD33_ERASE_WR_BLK_END:
		        arg *= 512;
		        break;
        }
    }

    spi_send(cmd | CMD_START_BITS);
    spi_send((arg >> 24));
    spi_send((arg >> 16));
    spi_send((arg >> 8));
    spi_send((arg >> 0));    

    // CRC required for CMD8 (0x87) & CMD0 (0x95) - default to CMD0
    spi_send((cmd == CMD8_SEND_IF_COND) ? CMD8_CRC : CMD0_CRC);    

    // Wait for response (i.e MISO not held high)
    int count = 0;
    while((response = spi_receive()) == 0xff) {
        if(count > 500) {
                break;
        }
        ++count;   
    }
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
