shawnchivers/genthang/(commit log)

2026-10-06 Fix sprite line buffer read latency and vscroll column bug in the VDP
    The sprite pixel occupancy test read the line buffer one pixel late because the
    RAM is clocked on CLK instead of the inverted clock used upstream. Prefetch two
    pixels ahead and prime each tile. Set VSCROLL_BUG to the hardware behaviour.
    [system.sv, vdp.v]
2026-10-06 Fix menu soft reset and show firmware version
    Keep the menu reset separate from power-on reset so work RAM survives for games such as X-Men. Hold reset through a human-length short press and release it as the menu closes.\n\nDisplay the release version in the menu, rebuild the firmware image, and add a test that keeps the displayed version synchronized with VERSION.
    [firmware.c, md20k_core.sv, system.sv, tb_ref.sv, test_firmware_version.py]
2026-10-06 Clean up VDP state formatting
    Remove trailing whitespace from the sprite line-buffer prefetch states before publishing the accuracy fixes to main.
    [vdp.v]
2026-10-08 Fix sprite-cell overflow and release 1.4.1
    Align clipped horizontally flipped sprites with the BlastEm comparisons, reuse offset state to preserve FPGA fit, and update the full release package.
    [test_build_pinout.py, vdp.v]
2026-10-09 Add CRAM dots option and fix six-button polling
    Expose CRAM write-through as a persistent menu option that defaults to off, and preserve existing settings files. Fix the six-button handshake phase counter so extended responses do not repeat during rapid polling. Rebuild the firmware and prepare the v1.4.2 release.
    [firmware.c, gen_io.sv, md20k_core.sv]
2026-10-09 Add dual DB9 build and remove CRAM dots option
    Add the breadboard-rev1 image for compatible single- and dual-DB9 wiring. Include it in release packaging and protect both controller pin contracts with tests.
    Remove the ineffective CRAM dots menu setting while retaining compatibility with v1.4.2 settings files. Add the narrow JT12 multicycle constraint required for reliable timing closure across all release variants.
2026-10-10 Document canonical breadboard pinout
    Use Genesis button names throughout the raw input documentation and testbench interfaces.
2026-10-10 Embed P1 breadboard diagram locally
    Keep the canonical wiring diagram self-contained in the Genthang documentation.
2026-10-10 Fix held X/Y/Z/Mode repeating on DB9 six-button pads (1.5.2)
    genesis_pad restarted its four-pulse TH handshake every ~2 ms. Six-button
    pads only answer with X/Y/Z/Mode after TH has been idle long enough for
    their internal counter to reset, and that time varies by pad (about 1-2 ms
    on Sega pads, longer on some clones and at 3.3 V). On pads near or above
    2 ms some scans caught the counter mid-sequence and reported the extra
    buttons as released, so a held X, Y or Z read as repeated presses.
    When a known six-button pad misses its reply, keep the previous
    X/Y/Z/Mode state and double the pause between scans (about 2.4, 4.9,
    9.7, then 19.4 ms). Pads that reset quickly keep the short poll. Results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
    [genesis_pad.v, tb_genesis_pad.cpp]
2026-10-11 Model 68K DRAM refresh and remove the extra VDP write wait
    About every 128 68K cycles the next 68K bus cycle is held for 2 CPU
    cycles (BlastEm REFRESH_INTERVAL/REFRESH_DELAY). The interval is a 7-bit
    LFSR (period 127) and the hold is counted outside the bus state machine,
    which only sees one extra request gate: the device is nearly full.
    Acknowledge 68K VDP writes as soon as the VDP accepts them instead of
    after MBUS_FINISH, so a write without a full FIFO costs no wait state.
    genthangverify probes, BlastEm vs this change (main in brackets):
    - loop iterations per frame for nop/RAM/ROM/IO/VDP access: exact (main +42..46)
    - VRAM/VSRAM writes: exact (main -13); back-to-back ROM->VRAM 926 vs 928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
2026-10-11 Fix the menu UART divider at 115200 baud to save logic
    The firmware only ever writes divider 234 (115200 baud from the 27 MHz
    iosys clock), so hard-wire it: the divider register reads 234 and a
    write only starts the idle frame as before, and the bit counters shrink
    from 16 to 8 bits. This frees ~110 LUTs, which the bus timing fix needs
    on the full GW2AR-18C. No effect on the Genesis core.
    A cycle-by-cycle Verilator comparison with the programmable divider set
    to 234 (3M cycles, 5515 TX edges, 1116 received bytes) matches once the
    firmware's divider write has happened.
    [iosys_picorv32.v, simpleuart.v]
2026-10-11 Add DVI video output option and stereo line-out jack (1.6.0)
    An LG 50PN6500 plasma pulsed on mid and dark tones whenever any HDMI data
    island was present, whatever it carried; standalone tests showed DVI was
    stable. The options menu gains "Video output: HDMI / DVI+LINE OUT", saved as
    the third character of GENTHANG.CFG and applied at a frame start.
    DB9 and raw builds also drive 1-bit sigma-delta audio on FPGA pins 31 (left)
    and 56 (right) for a 3.5 mm line-out, filtered off board with 1 kOhm, 10 nF
    and 10 uF per channel. Without the filter the jack is not hot-pluggable.
2026-10-11 Start the VDP on line 0 like BlastEm after reset
    The VDP V counter reset to line -27 (485, top blanking), so a program
    started 27 lines before the first counted frame while BlastEm starts its
    68K at line 0. Reset to the last blanking line (0x1FF), one pixel before
    the counter ticks to line 0 in H32, with the per-line state flags it has
    at that point. Starting inside vblank keeps the HDMI and testbench frame
    sync unchanged; the 68K now starts within 0.12 lines of BlastEm.
    genthangverify: reset-phase probe now reads line 0 like BlastEm; Flicky
    resume frame 5 drops from 2091 to 139 differing pixels; smoke and
    accuracy pass; db9 timing is unchanged.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
2026-10-13 VDP: sprite line-buffer write data is 0 except in a write cycle
    On the board a white dot appears one pixel left of the SOR2 stage 1 trash
    can on exactly the lines where the value left on the obj_ci write port by
    the previous line's last sprite pixel has bit 0 set. The RTL never writes
    that value, so this is the BSRAM on silicon; gate the port data with the
    SP3 write enable so the port idles at 0 (no extra logic in the release
    build: the gate joins the existing data mux). No change in simulation
    (genthangverify smoke/accuracy suites and the 80-frame can scenario
    unchanged). Debug builds (GT_VPAD) restore the old behaviour with HWDBG[5].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
2026-10-13 VDP: line-buffer fixes without the debug-build switches
    The fixes came from a debug branch whose GT_VPAD builds could turn them off
    at run time; on main only the simulation switch SIM_OLD_LINEBUF remains.
2026-10-13 build: GT_NO_SOUND=1 debug option (drops YM2612/PSG/filters and their SDC lines)
2026-10-14 1.6.2: changelog, version bump, Reset game fix confirmed on the board
2026-10-14 VDP: VRAM writes take two access slots, DMA copy paced by slots
    Outside 128K mode VRAM is 8 bits wide, so a FIFO VRAM word needs two access slots (BlastEm, real VDP). FIFO_PARTIAL had been disabled because it caused FIFO underflow: the FIFO read tested FIFO_EMPTY, which also counts the pending second byte, so a stale entry could be read. Re-enable it with the FIFO throttle (VRAM_SPEED) and read only when FIFO_QUEUE is non-zero.
    DMA copy now reads one byte in one access slot and writes it in the next, holding the byte in between.
    68K->VRAM DMA (display on and off) and active-display FIFO bursts now match BlastEm; VRAM copy is within 1%. Fixes the SOR2 'PRESS 2UP START' blink one frame early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
2026-10-16 68K refresh every 128 CPU cycles like BlastEm, restart after DMA
    The period-127 LFSR charged 0.8% more 2-cycle refresh holds than BlastEm's REFRESH_INTERVAL 128, so long CPU-bound loops (Alien Storm's decompressor) fell 4-5 lines behind and mid-frame display/palette writes landed late. A 7-bit counter gives period 128; the end of a DMA restarts the interval, as BlastEm resets its refresh counter after DMA.
    Alien Storm: steady drift gone (5 -> 2-3 lines). status-display probe now passes. Smoke, SOR2, Sonic 2 and resume regressions pass.
2026-10-16 68K reads of the Z80 area take one full wait state
    MBUS_ZBUS_WS only waited for the next CPU clock edge, inside the same bus cycle, so reads of A00000-A0FFFF ran like RAM reads. BlastEm (io_read) charges one 68K cycle; wait for a second clock edge. Probe bus-throughput z80_ram_read now matches (2623 -> 2570); z80-bus and ym-busy still pass.
2026-10-18 68K refresh keeps its 128-cycle phase across DMA bus hand-overs
    Restarting the refresh timer when DMA released the bus (ff8f6f3) shifted a palette transition in Aladdin by seven pixels. The timer now runs free with its original reset seed. Documents the overnight differential follow-up in known-issues.
2026-10-18 Fit the GW2AR-18 again: serial upload opt-in, single-port menu CPU regfile
    Since 08dbf6c every build failed placement at 100% CLS. The iosys UART is now only built with GT_SERIAL_UPLOAD=1 (registers still respond, reads return no data), and PicoRV32 runs with ENABLE_REGS_DUALPORT=0. Default build: logic 97%, 98 spare CLS, timing met. The Verilator board DUT keeps the UART for its firmware log; releases no longer ship the upload tools.
2026-10-18 Raw handheld build: Nano speaker, headphone jack, new pinout; drop DualShock
    - Raw build drives the Nano 20K's on-board MAX98357A over I2S (src/i2s_tx.v,
    48 kHz mono, -12 dB) and mutes it when headphones are plugged into a
    switching 3.5 mm jack (detect on pin 29, ~11 ms debounce). With no plug the
    line-outs idle at mid-level so the detect reads cleanly and plugging in
    does not pop.
    - Raw pinout laid out for a handheld with the Nano component side forward:
    D-pad J6.8-11, jack J6.12-14, face buttons in column pairs on J5, Start
    J5.3, Mode J5.13. btn_n[0..11] = 49,41,86,76,27,28,25,26,71,48,42,72.
    - Removed the deprecated DualShock build (GT_PAD=ds, nano20k_ds.cst,
    dualshock_contr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
2026-10-18 Revert 68K refresh phase change (d294e0f); flag refresh timing as regression-sensitive
    Keeping the refresh phase across DMA fixed Aladdin scenes-6 but the overnight campaign on 7cdd2bf showed it broke Alien 3 boot-7 (30 frames) and the SOR2 trash-can demo. Restores the DMA-end restart from ff8f6f3; both scenarios pass again with output identical to 69c57d6. Adds a warning at the refresh code, a regression-sensitive section in known-issues and AGENTS.md so future timing changes are checked against all three and a full campaign. Gowin: logic 97%, timing met.
2026-10-20 Add dual-DB9 PCB (O1) and Giger-inspired case under hardware/
    OSH Park is the recommended PCB manufacturer for people within the USA.
2026-10-20 Add Display: TV / 4:3 LCD option for 4:3 panel controllers
    LCD mode stretches games and the menu across the 1280-pixel 720p input so
    controllers that squeeze the full frame onto a 4:3 panel (e.g. a 640x480
    PCB800850 kit) show correct proportions. TV mode keeps the centred 4:3
    window and remains the default. The setting is saved as the fourth
    character of GENTHANG.CFG; older files still load.
2026-10-20 Add GT_VIDEO=800x480 build for bare TFT panels on a TFP401 board
    The Adafruit TFP401 has no scaler, so an 800x480 TFT cannot show 720p.
    GT_VIDEO=800x480 outputs native 800x480 CVT timing (992x500, 29.7 MHz
    pixel clock) as DVI. TV mode shows a centred 640x480 window, LCD mode the
    full width. release.sh also builds db9_800x480 and raw_800x480.
    Tested on the board with an Adafruit TFP401 and an 800x480 TFT.
2026-10-25 Fix white screen on 4 MB ROMs: pass the full loader word count as ROMSZ
    The ROM loader counts 32-bit words in the 21-bit ld_cnt, but only
    ld_cnt[19:0] reached the core's ROMSZ. A ROM of exactly 4 MB
    (0x100000 words, e.g. Toy Story, Sonic 3 & Knuckles, UMK3) wrapped to
    size 0, so all cartridge reads, including the reset vectors, returned 0
    and the game never started.
    Verified in the full-board Verilator testbench (menu firmware, TF card,
    SDRAM models) with Toy Story: all 1,048,576 ROM words load correctly in
    both versions; before the fix the 68K never touches the VDP and the
    picture is frozen, after it the SEGA logo appears. Raw Gowin build:
    placement OK, timing met, logic 97%. Flashed and t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
2026-10-25 Raw build: Color mode and Brightness options behind GT_PICTURE
    Adds saved menu options "Color mode: Original / Warm / Cool / Vivid"
    and "Brightness: 100% / 75% / 50% / 25%", applied by the HDMI scaler to
    games and menus after scanlines and blending (software dimming, not the
    LCD backlight). Based on the uncommitted picture-settings work in the
    main checkout, made conditional:
    - build_config.tcl: GT_PICTURE=0|1, default 1 for GT_PAD=raw and 0 for
    db9 (which has no logic to spare); build.tcl writes `define
    PICTURE_OPTS into pad_config.vh. Build-selection tests cover defaults,
    overrides and invalid values.
    - framebuffer: PICTURE_OPTS parameter. Without it the stage is not
    built and vid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
2026-10-25 Add GenThang Modern 3-button handheld build guide (beta)
2026-10-25 Raw 3-button handheld build (GT_3BTN), remove Color mode, pipeline TMDS encoder
    - GT_3BTN=1: P1 is a 3-button pad, port 2 reads as empty (no phantom player 2),
    Mode alone (20 ms debounce) opens the menu. Firmware reads core ID bit 18.
    - Color mode removed from the menu and the scaler; Brightness stays.
    - tmds_channel: one register stage between transition minimisation and the DC
    balance accumulator (hclk failed by 0.9 ns). Output is identical one clk_pixel
    later (checked against the original on 400k random cycles, all modes).
    Raw 3btn: timing met (clk_sys 63.6, clk_z80 41.3, hclk 98.4 MHz), logic 99%.
2026-10-25 Raw build: picture stage off by default; drop the TMDS pipeline
    On the handheld, raw builds with GT_PICTURE=1 broke X-Men audio (rumble) and
    white-screened Aladdin, though timing passed. Hardware bisect: 1.8.0, +ROMSZ
    (6c07826) and +SRAM gate (2d84555) all work; only the picture stage breaks.
    GT_PICTURE now defaults to 0 for every pad (opt in with GT_PICTURE=1).
    The TMDS encoder pipeline is reverted: without the picture stage hclk meets
    74.25 MHz (80.6) unchanged.
    GT_PAD=raw GT_3BTN=1: clk_sys 66.0, clk_z80 45.8, hclk 80.6 MHz, logic 97%.
    Verified on the handheld: X-Men sound, Aladdin, SoR2 one player, Mode = menu.
2026-10-25 Brightness back, folded into the scanline dimmer
    The 1.9.0 picture stage (second register stage + per-channel colour/brightness)
    broke X-Men audio and Aladdin on the handheld. Brightness now picks the existing
    scanline dimmer level instead (brightness + scanline level on scanline rows,
    capped at 25%), with no extra pipeline stage. Games only; the menu stays full.
    GT_PICTURE is on again by default for raw.
    make picture-modes checks every brightness x scanline x blend combination
    against a reference model, plus menu, blanking and the PICTURE_OPTS=0 bypass.
    GT_PAD=raw GT_3BTN=1: clk_sys 62.3, clk_z80 47.0, hclk 80.5 MHz, logic 98%.
    Verified on the handheld: Brightness works, X-Men sound, Alad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
2026-10-25 1.9.1: raw sound/loading fix, Brightness via the scanline dimmer, raw_3btn image
    - Color mode removed; Brightness reuses the scanline dimmer (no extra stage).
    DB9 (GT_PICTURE=0) keeps exactly the 1.9.0 dimmer so it still fits.
    - release.sh builds the new raw_3btn variant (GT_3BTN=1).
    - README, CHANGELOG, VERSION and firmware version 1.9.1.
2026-11-07 Move DB9 right line-out to GPIO17 for the L3 carrier
    Keep left audio, both controller pinouts, raw audio and RTL unchanged. Document the L1/L2 jumper migration, update breadboard wiring, and test the audio output constraints.
2026-11-07 Add illustrated DB9 and biomech console build guide
    Include print and soldering steps, electrical checks, firmware setup, case assembly, a light theme, and a playful humans-only warning.
2026-11-07 Add standalone L3 line-out carrier and colorful assembly guide
    Import the tested GPIO17 audio carrier release from genthang-hw, preserve the ordered fabrication ZIPs, and add the bear-led capacitor guide to a consolidated README assembly-guides section.
2026-11-07 Replace L3 bear presentation with a clear hardware-focused guide
    Keep the colorful capacitor chooser unchanged, replace the mascot with the PCB illustration, and synchronize the standalone package with genthang-hw.
2026-11-07 Add hardware-tested GPIO17 ladder audio firmware
    Keep normal blending and scanlines; omit adaptive blending and core switching in the opt-in ladder build to fit the Nano 20K.
2026-11-07 Release 1.9.3: official ladder audio builds
    Enable YM2612 ladder distortion and omit adaptive blending/core switching by default. Build all five standard variants with matching 1.9.3 menu firmware, preserved pinouts and handheld brightness, successful placement and zero negative timing slack.
2026-11-08 Clarify Gen Thang overview and add animated demos
    Lead with a plain-language project overview and a light-background three-button handheld mock-up. Keep menu screenshots with usage instructions and include the console demo for comparison.
